SC3228/BatteryProgrammer/Batt Programmer_V2/Batt Programmer/Manual/V1/20180212_135302.jpg

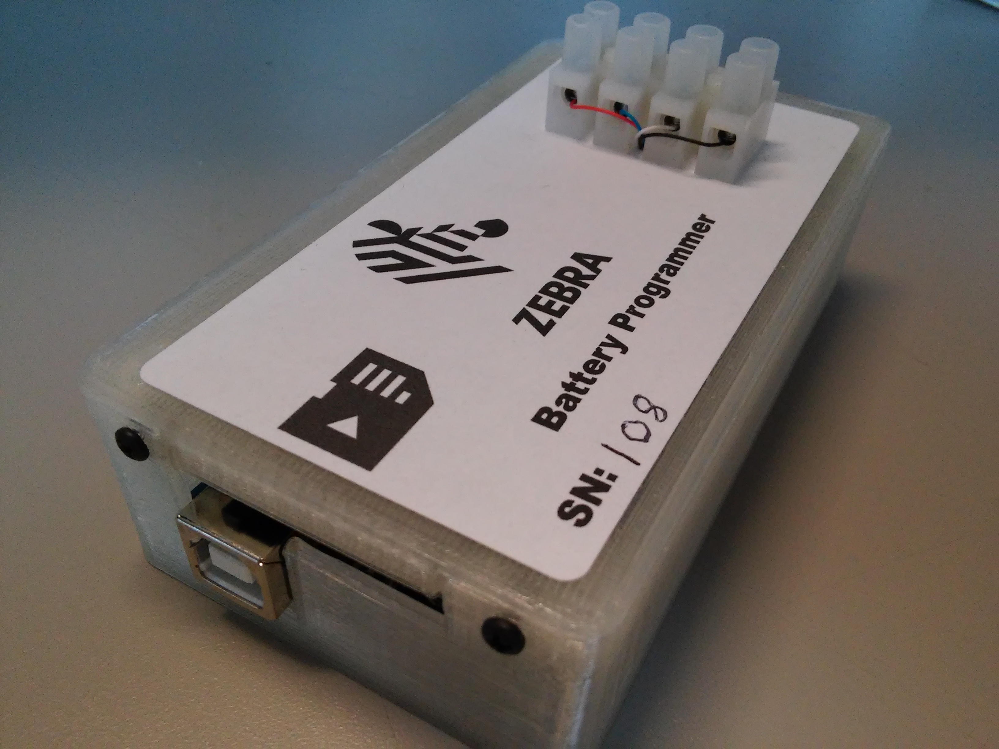
Batt Programmer_V2/Batt Programmer/Manual/V1/20180212_135302.jpg
