SC3228/BatteryProgrammer/Batt Programmer_V2/Batt Programmer/Notes.txt

Support Central Emc-RVHW46 rvhw46@zebra.com

Software
1. Add support for FUBs.
