SC3228/BatteryProgrammer/Batt Programmer_V2/Batt Programmer/Link.txt

https://zebra.sharepoint.com/sites/BatteryProgrammer
