SC3228/BatteryProgrammer/Batt Programmer_V2/Batt Programmer/Box/labels V2 JDM.odt

Batt+

SCL

SDA

Gnd

Therm

PN: ZN10001068

Battery

Programmer

SN:

Batt+

SCL

SDA

Gnd

Therm

PN: ZN10001068

Battery

Programmer

SN:

Batt+

SCL

SDA

Gnd

Therm

PN: ZN10001068

Battery

Programmer

SN:

Batt+

SCL

SDA

Gnd

Therm

PN: ZN10001068

Battery

Programmer

SN:

Batt+

SCL

SDA

Gnd

Therm

PN: ZN10001068

Battery

Programmer

SN:

Batt+

SCL

SDA

Gnd

Therm

PN: ZN10001068

Battery

Programmer

SN:

Batt+

SCL

SDA

Gnd

Therm

PN: ZN10001068

Battery

Programmer

SN:

Batt+

SCL

SDA

Gnd

Therm

PN: ZN10001068

Battery

Programmer

SN:

Batt+

SCL

SDA

Gnd

Therm

PN: ZN10001068

Battery

Programmer

SN:

Batt+

SCL

SDA

Gnd

Therm

PN: ZN10001068

Battery

Programmer

SN:
