SC3228/BatteryProgrammer/Batt Programmer_V2/Batt Programmer/Box/labels V2.odt

Batt+

SCL

SDA

Gnd

Therm

PN: ZN10001068

Battery

Programmer

FOR ZEBRA

INTERNAL USE ONLY!

SN:

Batt+

SCL

SDA

Gnd

Therm

PN: ZN10001068

Battery

Programmer

FOR ZEBRA

INTERNAL USE ONLY!

SN:

Batt+

SCL

SDA

Gnd

Therm

PN: ZN10001068

Battery

Programmer

FOR ZEBRA

INTERNAL USE ONLY!

SN:

Batt+

SCL

SDA

Gnd

Therm

PN: ZN10001068

Battery

Programmer

FOR ZEBRA

INTERNAL USE ONLY!

SN:

Batt+

SCL

SDA

Gnd

Therm

PN: ZN10001068

Battery

Programmer

FOR ZEBRA

INTERNAL USE ONLY!

SN:

Batt+

SCL

SDA

Gnd

Therm

PN: ZN10001068

Battery

Programmer

FOR ZEBRA

INTERNAL USE ONLY!

SN:

Batt+

SCL

SDA

Gnd

Therm

PN: ZN10001068

Battery

Programmer

FOR ZEBRA

INTERNAL USE ONLY!

SN:

Batt+

SCL

SDA

Gnd

Therm

PN: ZN10001068

Battery

Programmer

FOR ZEBRA

INTERNAL USE ONLY!

SN:

Batt+

SCL

SDA

Gnd

Therm

PN: ZN10001068

Battery

Programmer

FOR ZEBRA

INTERNAL USE ONLY!

SN:

Batt+

SCL

SDA

Gnd

Therm

PN: ZN10001068

Battery

Programmer

FOR ZEBRA

INTERNAL USE ONLY!

SN:
