SC3228/BatteryProgrammer/Batt Programmer_V2/Batt Programmer/Box/V1/JDM labels.odt

Batt+

SCL

SDA

Gnd

Battery Programmer

SN:

Batt+

SCL

SDA

Gnd

Battery Programmer

SN:

Batt+

SCL

SDA

Gnd

Battery Programmer

SN:

Batt+

SCL

SDA

Gnd

Battery Programmer

SN:

Batt+

SCL

SDA

Gnd

Battery Programmer

SN:

Batt+

SCL

SDA

Gnd

Battery Programmer

SN:

Batt+

SCL

SDA

Gnd

Battery Programmer

SN:

Batt+

SCL

SDA

Gnd

Battery Programmer

SN:

Batt+

SCL

SDA

Gnd

Battery Programmer

SN:

Batt+

SCL

SDA

Gnd

Battery Programmer

SN:
