SC3228/BatteryProgrammer/Batt Programmer_V2/Batt Programmer/Box/V1/labels.odt

Batt+

SCL

SDA

Gnd

Battery Programmer

FOR ZEBRA INTERNAL USE ONLY!

SN:

Batt+

SCL

SDA

Gnd

Battery Programmer

FOR ZEBRA INTERNAL USE ONLY!

SN:

Batt+

SCL

SDA

Gnd

Battery Programmer

FOR ZEBRA INTERNAL USE ONLY!

SN:

Batt+

SCL

SDA

Gnd

Battery Programmer

FOR ZEBRA INTERNAL USE ONLY!

SN:

Batt+

SCL

SDA

Gnd

Battery Programmer

FOR ZEBRA INTERNAL USE ONLY!

SN:

Batt+

SCL

SDA

Gnd

Battery Programmer

FOR ZEBRA INTERNAL USE ONLY!

SN:

Batt+

SCL

SDA

Gnd

Battery Programmer

FOR ZEBRA INTERNAL USE ONLY!

SN:

Batt+

SCL

SDA

Gnd

Battery Programmer

FOR ZEBRA INTERNAL USE ONLY!

SN:

Batt+

SCL

SDA

Gnd

Battery Programmer

FOR ZEBRA INTERNAL USE ONLY!

SN:

Batt+

SCL

SDA

Gnd

Battery Programmer

FOR ZEBRA INTERNAL USE ONLY!

SN:
