SC3228/BatteryProgrammer/Batt Programmer_V2/Batt Programmer/Manual/Hardware TOP V2.odt

Battery Programmer I/O Board Theory Of Operation

## Overview

## The I/O board is designed as a wing for an Adafruit Feather M4 Express board. It provides the electrical interface to the various batteries

## It also provides other functions as detailed below

## Connectors

## Feather headers - A1

## These connectors provide the interface to the Arduino Mega 2560

## For a detailed pin out please see the A (https://www.adafruit.com/product/3857)dafruit (https://www.adafruit.com/product/3857) documentation (https://www.adafruit.com/product/3857)

## Battery connector – J1

## J1 connects the 5 battery wires to the board, these are Batt+, Gnd, SDA, SCL, Therm

## Input protection

## The diode pack U7 is used to clamp input signals to the rails

## Relays K1 – K3

## Used to isolate the unit from the battery connector until it is powered up and configured

## Controlled by GPIOs from the Mega board thru FETs

## I2C interface

## The I2C interface is handled by the M4 Express board hardware

## The Mega board interface is 3.3V, a level shifter made with Q2 & Q3 is used to support higher bus voltages.

## Pull up voltage

## The I2C pull up voltage is controlled by an M4 Express GPIO using the 2 to 1 analog mux at U4.

## Voltages of 3.3V, or the battery voltage are supported.

## Battery voltages up to ~9.5V are supported

## Pull up resistors

## The I/O board can provide pull up resistor values from 2K to 6.7K

## The resistor value is controlled by GPIOs using the quad analog switches at U1 and U2

## By combining the 5.1K, 6.8K, and 10K resistors in various combinations the following pull up resistor values are available: 2.0K, 2.5K, 2.9K, 3.4K, 4.1K, 5.1K, and 6.7K

## Active clock drive

## To support batteries that need an active clock drive the left over analog switches in U1 and U2 are used to select between the selected pull up resistance or the output of the level shifter at U3

## Only a 3.3V active drive is supported

## On board Auth Chip

## U6 is an Atmel/Microchip ATECC608A authentication chip like the ones in our batteries.

## It’s main use is to perform the math associated with authenticating our batteries

## It stores the serial number and of the battery programmer unit

## It also stores the hardware rev of the I/O board

## Battery voltage measurement

## The battery voltage is measured by an analog input on the M4 Express board

## Resistors R11 and R10 divide the voltage down to a level that allows inputs of up to ~9.5V to be measured

## The on-board regulator on the M4 Express provides a 3.3V 1% reference voltage to the M4 Express AREF pin.

## Config storage

## The unit serial number is stored in the first two bytes of slot 0, LSB first.

## SN values < 1000 are for Zebra internal use only devices

## SN values >= 1000 are for JDM devices

## Slot 0 will be locked after being programmed

## The hardware revision of the unit will be stored in the first two bytes of slot 1.

## Byte 0 will be the major rev value and byte 1 will be the minor rev value.

## Slot 1 will be left unlocked after being programmed.
