SC3228/BatteryProgrammer/Batt Programmer_V2/Batt Programmer/Manual/V1/Hardware TOP V1.odt

Battery Programmer I/O Board Theory Of Operation

## Overview

## The I/O board is designed as a shield for an Arduino Mega 2560 board. It provides the electrical interface to the various batteries

## It also provides other functions as detailed below

## Connectors

## Arduino headers - P1-P7

## These connectors provide the interface to the Arduino Mega 2560

## For a detailed pin out please see the Arduino documentation (https://store.arduino.cc/usa/mega-2560-r3)

## Battery connector – J1

## J1 connects the 4 battery wires to the board, these are Batt+, Gnd, SDA, SCL

## It also has connections to a set of normally open relay contacts for future use

## SD Card socket – J2

## Socket for an SD card that can be used to load/store battery hex files

## Input protection

## The diode pack U7 is used to clamp input signals to the rails

## Relays K1 – K3

## Used to isolate the unit from the battery connector until it is powered up and configured

## Controlled by GPIOs from the Mega board thru FETs

## I2C interface

## The I2C interface is handled by the Mega board hardware

## The Mega board interface is 5V but is compatible with 3.3V signals.

## Pull up voltage

## The I2C pull up voltage is controlled by the Mega GPIOs using the dual 4 to 1 analog mux at U4.

## Voltages of 5V, 3.3V, or the battery voltage are supported.

## The extra input is tied to ground thru R11 and could be used for another input in the future.

## Pull up resistors

## The I/O board can provide pull up resistor values from 2.3K to 10K

## The resistor value is controlled by GPIOs using the two quad analog switches at U1 and U2

## By combining the 5.1K, 6.8K, and 10K resistors in various combinations the following pull up resistor values are available: 2.3K, 2.9K, 3.4K, 4K, 5.1K, 6.8K and 10K

## Active clock drive

## To support batteries that need an active clock drive the left over analog switches in U1 and U2 are used to select between the selected pull up resistance or the output of the level shifter at U3

## Only a 3.3V active drive is supported

## SD Card interface

## The SD card interface only supports a 3.3V SPI interface

## The level shifters at U3 and U5 are used to shift from the 5V mega pins to the 3.3V SD interface

## Both card detect and write protect detection are supported

## On board Auth Chip

## U6 is an Atmel/Microchip ATECC508A authentication chip like the ones in our batteries.

## It’s main use is to perform the math associated with authenticating our batteries

## It stores the serial number and of the battery programmer unit

## It also stores the hardware rev of the I/O board

## Battery voltage measurement

## The battery voltage is measured by an analog input on the Mega board

## Resistors R17 and R22 divide the voltage down to a level that allows inputs of about 5V to be measured

## The regulator at U8 provides a 3.3V reference voltage to the Mega AREF pin.

## Future Expansion

## An extra relay K4 was added for possible future uses

## Load resistor connection

## Charger connection

## Device under test connection
