SC3228/BatteryProgrammer/Batt Programmer_V2/Batt Programmer/GG Programming/GG Update JDM.pdf

# Gas Gauge Update Instructions

This document contains proprietary information of Zebra Technologies Corporation and its subsidiaries (“Zebra Technologies”). It is intended solely for the information and use of parties using the hardware/software described herein. Such proprietary information may not be used, reproduced, or disclosed to any other parties for any other purpose without the express, written permission of Zebra Technologies.

### 1. Terminal Software Installation

A serial communications program is required to use the Battery Programmer. We recommend TeraTerm, but other serial terminal programs may work. TeraTerm can be downloaded from:

https://osdn.net/projects/ttssh2/downloads/74780/teraterm-4.106.exe/

NOTE: The the box is NOT compatible with the Arduino IDE serial monitor

Plug the box into your PC and make a note of the serial port it was assigned. After installing TeraTerm start it and you will see the following dialog, select “Serial” and then pick the port assigned to the box. It will probably be labeled “USB Serial Device”.

When you first plug in the box you may also see a drive pop up with a bunch of files on it. Those files are stored on the box and are needed for the update process. Do not delete or modify them. The drive window can be closed as it is not needed for the update process.

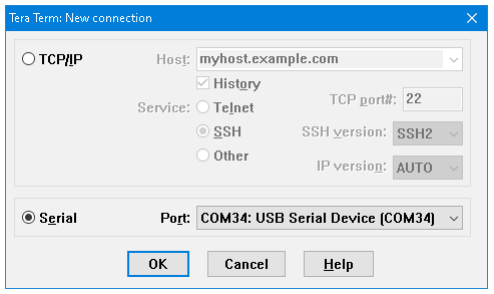
[picture p15: figure]

When the TeraTerm window opens you should see the following:

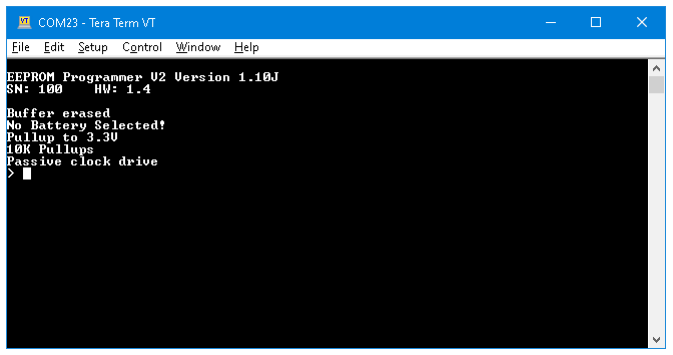
[picture p16: figure]

Page 1 of 2 | GG Update Instructions | 11/22/21

### 2. Select the battery type

Enter the battery select command ‘b’ followed by enter. You should now see the list of supported batteries as shown below:

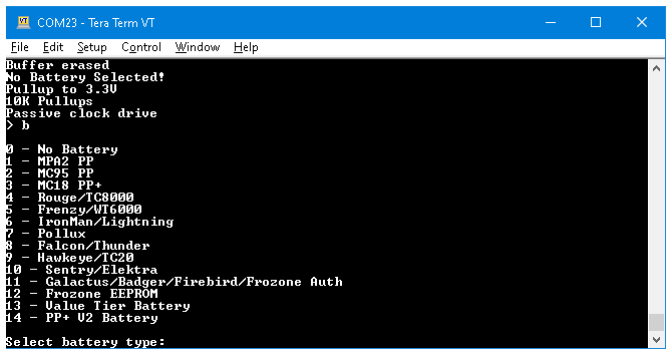
[picture p17: figure]

We want the PP+ V2 Battery, so type the number 14 followed by enter.

### 3. Update a gas gauge

Place a battery into the fixture. You should see the text “Battery detected!” on TeraTerm.
Enter the update gas gauge command ‘ugg’ followed by enter.
The box will now check the battery, check the files it needs for the update, and then update the battery.

This process will take a little over a minute to finish. The LED will glow red during the update.

----DO NOT REMOVE THE BATTERY UNTIL THE UPDATE IS DONE --------Doing so will render the battery unusable----

When the update is finished, the LED will return to green, at that point the battery can be removed from the fixture.

Page 2 of 2 | GG Update Instructions | 11/22/21
