SC3228/BatteryProgrammer/Batt Programmer_V2/Batt Programmer/Docs/BattHardware.ods

Version 1.2 | 2/8/18
Battery Type | Used In | EEPROM Size | EEPROM Address | Temp Chip | Auth Chip | Gas Gauge | Parasitic Power | I2C Bus Speed | Pull up Voltage | Device Pull up | Pack Pull Up | Pack Pull Down | Keys | Data Format | Notes
MPA2&3 PP (Smart) | All MPA2&3 except MC18 | 256 | 0xA0 | 0x90 | N | N | Y | ~32KHz | 3.3V |  |  |  | None | MP2 Smart battery
MPA3 PP+ (Gifted) | MC18, Rogue (TC8000) | 512 | 0xA4 | 0x94 | N | Y | Y |  | 3.3V |  |  |  | Sunrise | PP+
MPA3 PP+ (Gifted) | Frenzy (WT6000) | 512 | 0xA4 | 0x94 | N | Y | Y | 32.2KHz | 3.3V |  |  |  | Freeport | PP+
Pollux | Pollux/Falcon | 512 | 0xA0 | N | N | N | N |  | V_Batt |  |  |  | None | Pollux
Hawkeye | Hawkeye (TC20) | N | N | N | Y | N | N |  | V_Batt |  | 4.7K |  | None | Hawkeye | Data in auth chip slot 8
IronMan | IronMan | 1024 | 0xA0 | N | Y | Y | N | 37.5KHz | V_Batt | 2.2K |  | 1M | IronMan | Combined QC8956 and PP+ | Has both Pollux and PP+ data
Falcon | Falcon | 1024 | 0xA0 | N | Y | Y | N | 37.5KHz | V_Batt | 4.7K |  |  | Falcon | Combined QC8956 and PP+ | Has both Pollux and PP+ data
Sentry | Sentry | 1024 | 0xA0 | N | Y | Y | N | 37.5KHz | V_Batt | 4.7K |  |  | Falcon | Combined QC8956 and PP+ | PP+ Data in auth chip slot 8
Beast | Beast, Galactus, MC19 | 1024 | 0xA0 | N | Y | Y | N | 37.5KHz | V_Batt | 2.2K |  |  | Falcon | PP+ | PP+ Data in auth chip slot 8
