SC3228/BatteryProgrammer/Batt Programmer_V2/Batt Programmer/Backups/V1/IO Board V2_5/IO Board/Hardware TOP.txt

Battery Programmer I/O Board Theroy Of Operation

1. Overview
	The I/O board is designed as a shield for an Arduino Mega 2650 board.
	It provides the electrical interface to the various batteries, as well as other functions
	detailed below.
