SC3228/BatteryProgrammer/Batt Programmer_V2/Batt Programmer/Battery schematics/Beast Connector.png

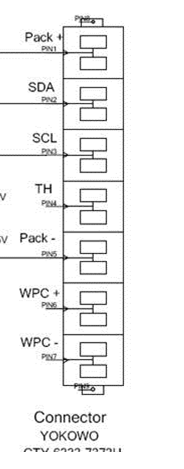
Batt Programmer_V2/Batt Programmer/Battery schematics/Beast Connector.png
