SC3228/BatteryProgrammer/Batt Programmer_V2/Batt Programmer/Battery schematics/Jaws Battery Pinout.jpg

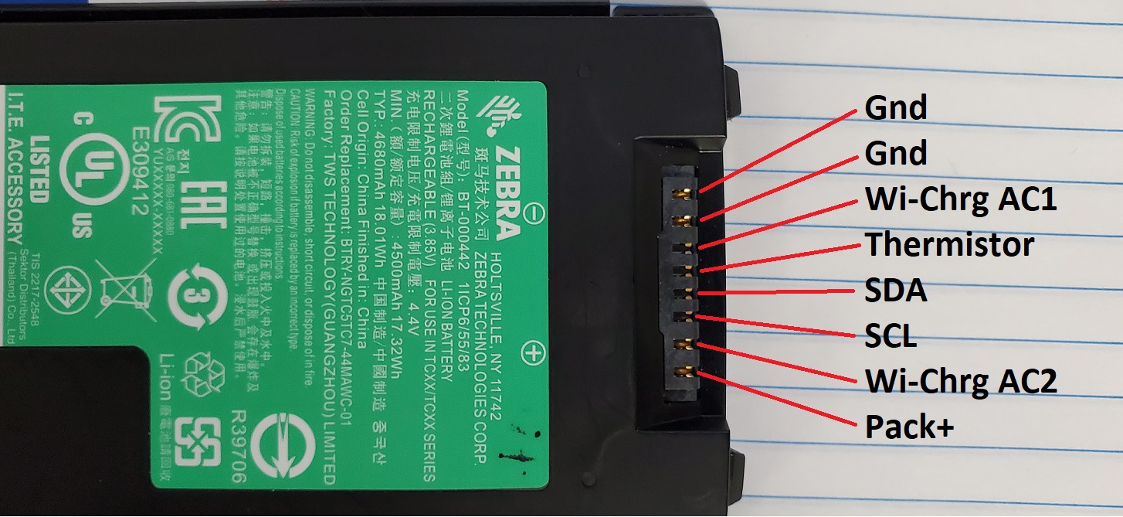
Batt Programmer_V2/Batt Programmer/Battery schematics/Jaws Battery Pinout.jpg
