SC3228/BatteryProgrammer/Batt Programmer_V2/Batt Programmer/Box/V1/sd_card-512.png

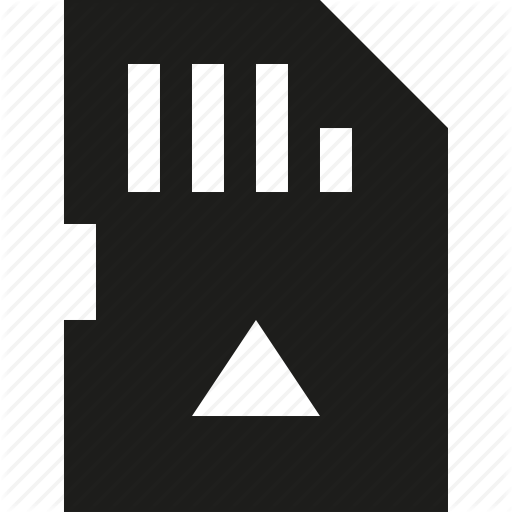
Batt Programmer_V2/Batt Programmer/Box/V1/sd_card-512.png
