SC3228/BatteryProgrammer/Batt Programmer_V2/Batt Programmer/Code/V1 Stuff/BattProgKevin/Untitled.png

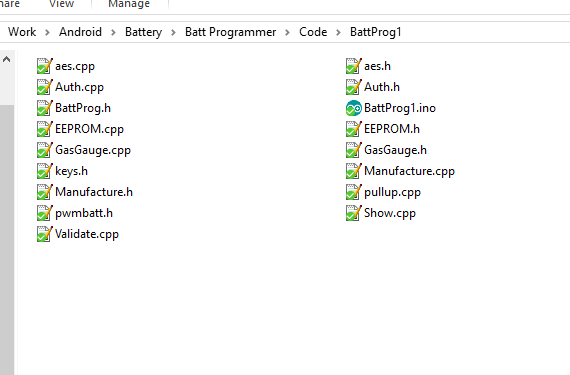
Batt Programmer_V2/Batt Programmer/Code/V1 Stuff/BattProgKevin/Untitled.png
