SC3228/BatteryProgrammer/Batt Programmer_V2/Batt Programmer/GG Programming/Fixture hookup/Jaw Battery Programmer 1.jpg

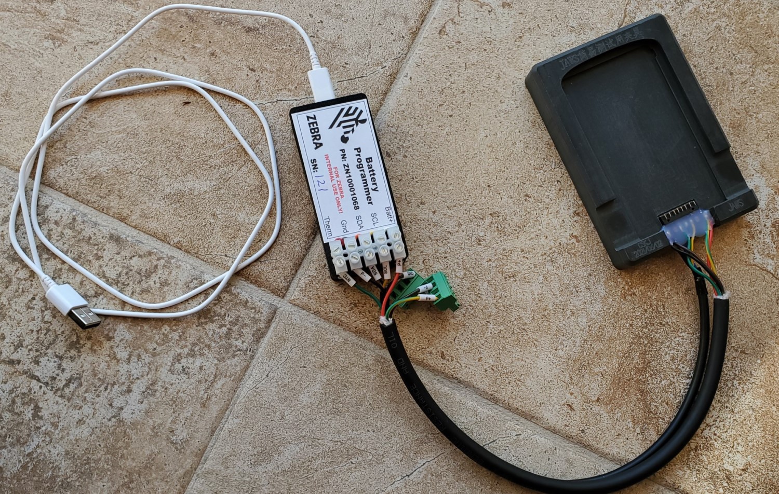
Batt Programmer_V2/Batt Programmer/GG Programming/Fixture hookup/Jaw Battery Programmer 1.jpg
