SC3228/BatteryProgrammer/Batt Programmer_V2/Batt Programmer/GG Programming/Fixture hookup/Jaws Battery Programmer 2.jpg

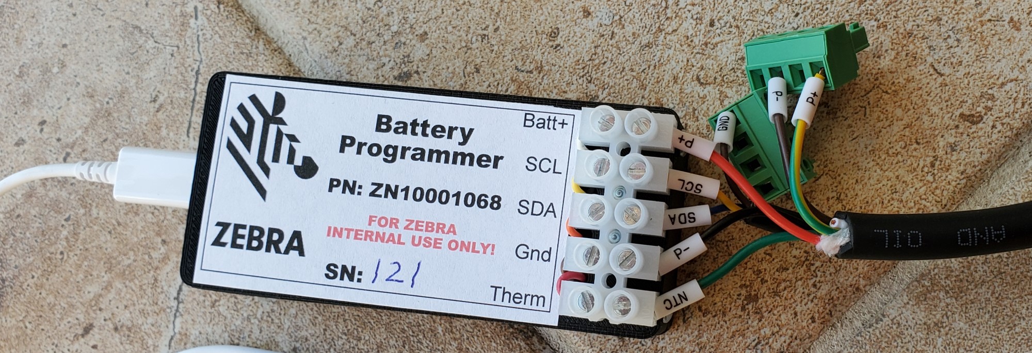
Batt Programmer_V2/Batt Programmer/GG Programming/Fixture hookup/Jaws Battery Programmer 2.jpg
