SC3228/BatteryProgrammer/Batt Programmer_V2/Batt Programmer/IO Board/PCB Settings Stuff/Gerber.png

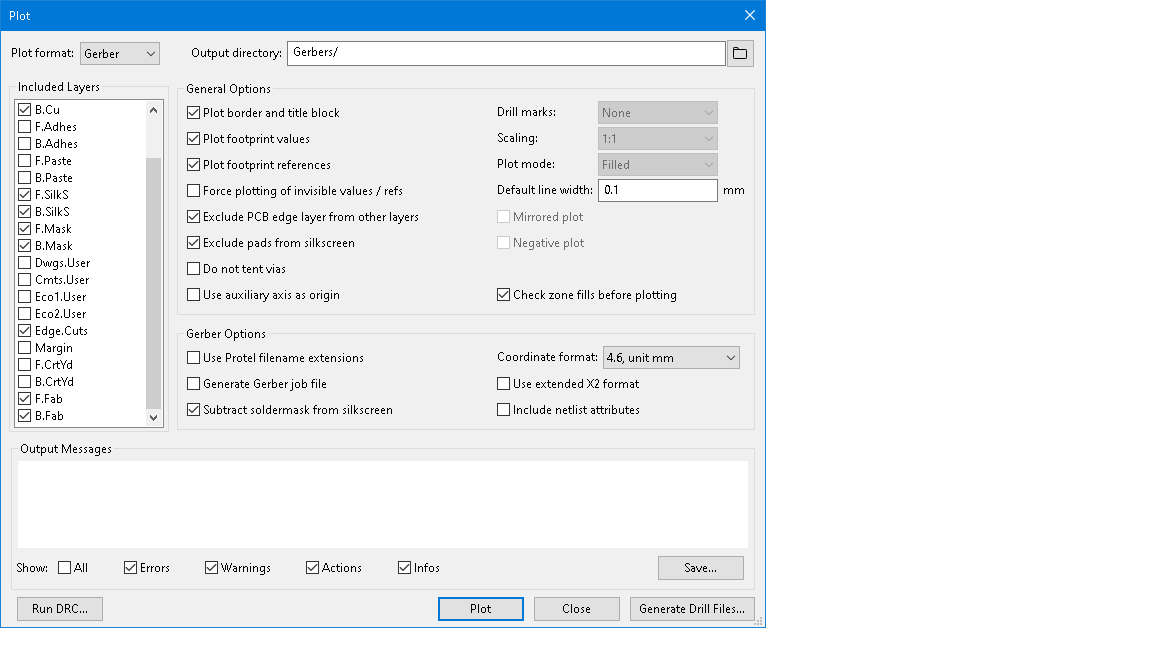
Batt Programmer_V2/Batt Programmer/IO Board/PCB Settings Stuff/Gerber.png
