SC3228/BatteryProgrammer/Batt Programmer_V2/Batt Programmer/Presentations/Top View.jpg

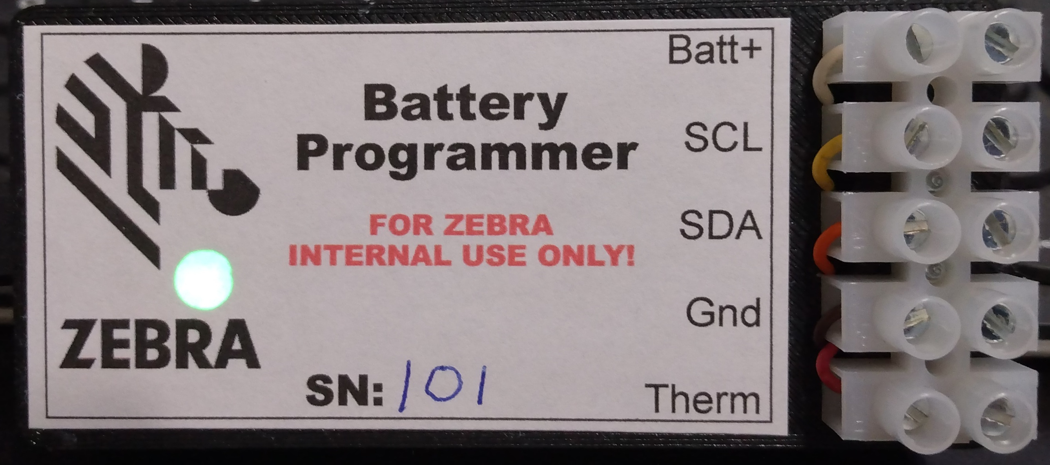
Batt Programmer_V2/Batt Programmer/Presentations/Top View.jpg
