SC3228/BatteryProgrammer/Batt Programmer_V2/Batt Programmer/IO Board/BOM.ods

 |  |  | Build Qnty | Cost each | Total Cost
 |  |  | 10 | $60.02 | $600.21
Ref | Qnt Ea | Buy | Part | Part# | Manf | Supplier | Supplier Part# | Cost | Total Per | Link | Price Break | In Stock | In Stock @ Zebra
A1 | 1 | 10 | Feather M4 Express | 3857 | Adafruit | Digi-key | 1528-2648-ND | $22.95 | $22.95 | https://www.adafruit.com/product/3857 (https://www.digikey.com/en/products/detail/adafruit-industries-llc/3857/9553567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) | 1 | N | 1
U1,U2 | 2 | 20 | Quad 2 to 1 analog mux | MAX4614ESD+ | Maxim | Digi-key | MAX4614ESD+-ND | $3.98 | $7.95 | https://www.digikey.com/en/products/detail/analog-devices-inc-maxim-integrated/MAX4614ESD/1780300 | 10 | Y | 6
U3 | 1 | 10 | Dual Buffer,SOT23-6 | SN74LVC2G17DBVT | TI | Digi-key | 296-26621-1-ND | $1.18 | $1.18 | https://www.digikey.com/product-detail/en/texas-instruments/SN74LVC2G17DBVT/296-26621-1-ND/2255079 | 10 | Y | 5
U4 | 1 | 10 | 2 to 1 analog mux | MAX4624EZT+T | Maxim | Digi-key | MAX4624EZT+T | $4.28 | $4.28 | https://www.digikey.com/en/products/detail/analog-devices-inc-maxim-integrated/MAX4624EZT-T/1163961 | 10 | Y | 4
U5 | 1 | 10 | ESD Protection | DT2042-04SO-7 | Diodes Inc. | Digi-key | DT2042-04SO-7DICT-ND | $0.36 | $0.36 | https://www.digikey.com/product-detail/en/diodes-incorporated/DT2042-04SO-7/DT2042-04SO-7DICT-ND/4457896 | 10 | Y | 4
U6 | 1 | 10 | Authentication IC | ATECC608A-SSHDA-T | Microchip | Digi-key | ATECC608A-SSHDA-TCT-ND | $0.00 | $0.00 | https://www.digikey.com/en/products/detail/microchip-technology/ATECC608A-SSHDA-T/7928116 | 10 | N | 16
U7 | 1 | 10 | Op Amp | MAX4321EUK+T | Maxim | Digi-key | MAX4321EUK+TCT-ND | $2.46 | $2.46 | https://www.digikey.com/en/products/detail/maxim-integrated/MAX4321EUK-T/1702629 | 10 | Y | 4
R1,R2,R3 | 3 | 100 | 100K resistor,5%,1206 | RMCF1206JG100K | Stackpole | Digi-key | RMCF1206JG100KCT-ND | $0.01 | $0.03 | https://www.digikey.com/products/en?keywords=RMCF1206JG100KCT-ND | 100 | Y | 76
R4,R7,R15,R16 | 4 | 100 | 10K resistor,1%,1206 | RMCF1206FT10K0 | Stackpole | Digi-key | RMCF1206FT10K0CT-ND | $0.01 | $0.06 | https://www.digikey.com/products/en?keywords=RMCF1206FT10K0CT-ND | 100 | Y | 68
R5,R8 | 2 | 100 | 6.8K resistor,1%,1206 | RMCF1206FT6K80 | Stackpole | Digi-key | 738-RMCF1206FT6K80CT-ND | $0.01 | $0.03 | https://www.digikey.com/products/en?keywords=738-RMCF1206FT6K80CT-ND | 100 | Y | 98
R6,R9,R14 | 3 | 100 | 5.1K resistor,1%,1206 | RMCF1206FT5K10 | Stackpole | Digi-key | RMCF1206FT5K10CT-ND | $0.01 | $0.04 | https://www.digikey.com/products/en?keywords=RMCF1206FT5K10CT-ND | 100 | Y | 65
R11 | 1 | 10 | 3.65K resistor,.1%,1206 | RT1206BRD073K65L | Yageo | Digi-key | YAG5071CT-ND | $0.48 | $0.48 | https://www.digikey.com/products/en?keywords=YAG5071CT-ND | 10 | Y | 4
R10 | 1 | 10 | 6.81K resistor,.1%,1206 | RT1206BRD076K81L | Yageo | Digi-key | YAG2074CT-ND | $0.48 | $0.48 | https://www.digikey.com/products/en?keywords=YAG2074CT-ND | 10 | Y | 3
R12,R13 | 2 | 20 | 20K resistor,1%,1206 | RMCF1206FT20K0 | Stackpole | Digi-key | RMCF1206FT20K0CT-ND | $0.04 | $0.07 | https://www.digikey.com/en/products/detail/stackpole-electronics-inc/RMCF1206FT20K0/1759766 | 10 | Y | 84
C1,C2,C4,C5,C6 | 5 | 50 | .1uf Cap,1206 | 12061C104KAT4A | AVX Corp | Digi-key | 478-10855-1-ND | $0.07 | $0.34 | https://www.digikey.com/product-detail/en/avx-corporation/12061C104KAT4A/478-10855-1-ND/7536379 | 50 | Y | 15
C3 | 1 | 10 | 10uf Cap,1206 | CL31B106KOHNNWE | Samsung | Digi-key | 1276-3105-1-ND | $0.17 | $0.17 | https://www.digikey.com/en/products/detail/samsung-electro-mechanics/CL31B106KOHNNWE/3888763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 | 10 | Y | 4
K1,K2 | 2 | 50 | DPDT Relay | TX2SA-LT-5V-TH-Z | Panasonic | Digi-key | 255-3837-1-ND | $3.58 | $7.15 | https://www.digikey.com/en/products/detail/panasonic-electric-works/TX2SA-LT-5V-TH-Z/2766947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 | 50 | Y | 4
P1,P2 (A1 Socket) | 1 | 10 | 30 pin header socket | 7-534237-8 | AMP | Digi-key | A32917-ND | $4.94 | $4.94 | https://www.digikey.com/en/products/detail/te-connectivity-amp-connectors/6-534237-4/1089949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 | 10 | Y | 1
D1 | 1 | 10 | 50V 1A Diode | S1A | On Semi | Digi-key | S1AFSCT-ND | $0.34 | $0.34 | https://www.digikey.com/product-detail/en/on-semiconductor/S1A/S1AFSCT-ND/965718 | 10 | Y | 61
D2,D3,D4 | 3 | 100 | Diode Array | BAS70-04-E3-18 | Vishay | Digi-key | BAS70-04-E3-18GICT-ND | $0.18 | $0.54 | https://www.digikey.com/en/products/detail/vishay-general-semiconductor-diodes-division/BAS70-04-E3-18/4826861 | 100 | Y | 21
Q1,Q2,Q3 | 3 | 30 | MOSFET: N-Ch SOT-23 | BSS806NH6327XTSA1 | Infineon | Digi-key | BSS806NH6327XTSA1CT-ND | $0.37 | $1.12 | https://www.digikey.com/en/products/detail/infineon-technologies/BSS806NEH6327XTSA1/5959969 | 10 | Y | 11
 | 1 | 10 | Terminal Strip | 121205 | Adels-Contact | Digi-key | 2098-121205-ND | $0.71 | $0.71 | https://www.digikey.com/products/en?keywords=2098-121205-ND | 10 | Y | 2
 | 6 | 100 | #4x3/8 Screw | PSMS 004 0038 PH | B&F Fastener Supply | Digi-key | H800-ND | $0.09 | $0.54 | https://www.microfasteners.com/smpp0206-2-x-3-8-pan-head-sheet-metal-screws-phillips.html (https://www.digikey.com/en/products/detail/b-f-fastener-supply/PSMS-004-0038-PH/333049) | 100 | Y | 146
PC Board | 1 | 10 |  |  |  |  |  | $3.80 | $3.80 |  | 10 |  | 0
