SC3228/BatteryProgrammer/Batt Programmer_V2/Batt Programmer/Battery Fixtures/Gravity/pogos.stl

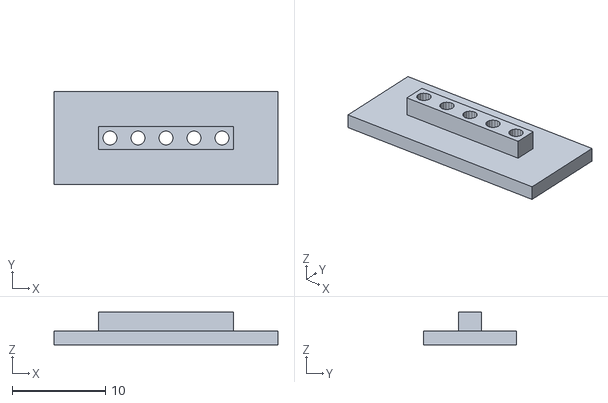
[picture p27: CAD file, 2024-01-31]
Batt Programmer_V2/Batt Programmer/Battery Fixtures/Gravity/pogos.stl
24.0 x 10.0 x 3.50
