SC3228/BatteryProgrammer/Batt Programmer_V2/Batt Programmer/Box/V2 Box Top.stl

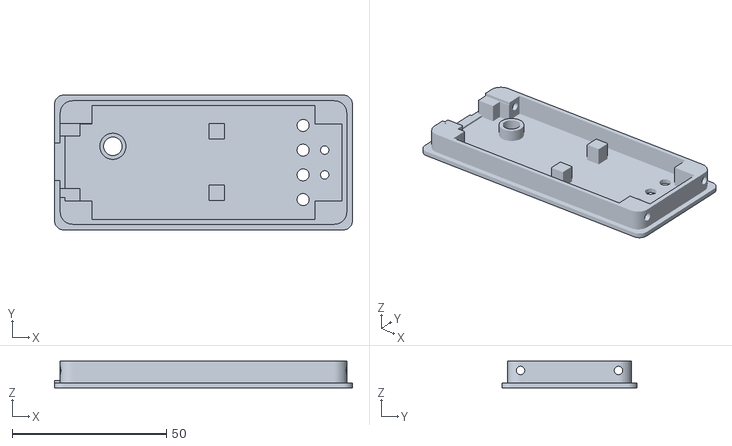
[picture p28: CAD file, 2024-01-31]
Batt Programmer_V2/Batt Programmer/Box/V2 Box Top.stl
96.5 x 43.7 x 8.60
