SC3228/BatteryProgrammer/Batt Programmer_V2/Batt Programmer/IO Board/Gerbers/IO Board-NPTH-drl_map.dxf

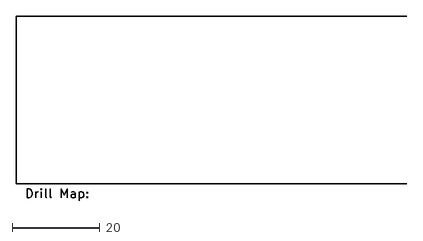
[picture p29: CAD file, 2024-01-31]
Batt Programmer_V2/Batt Programmer/IO Board/Gerbers/IO Board-NPTH-drl_map.dxf
88.9 x 41.9
