SC3228/BatteryProgrammer/Batt Programmer_V2/Batt Programmer/Battery Fixtures/Gravity/fixture.stl

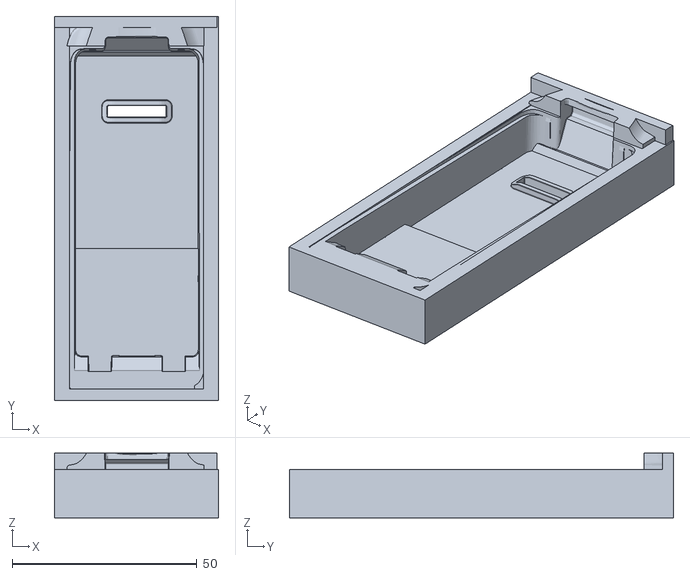
[picture p30: CAD file, 2024-01-31]
Batt Programmer_V2/Batt Programmer/Battery Fixtures/Gravity/fixture.stl
44.4 x 104.0 x 17.5
