SC3228/BatteryProgrammer/Batt Programmer_V2/Batt Programmer/Box/V2 Box Bot.stl

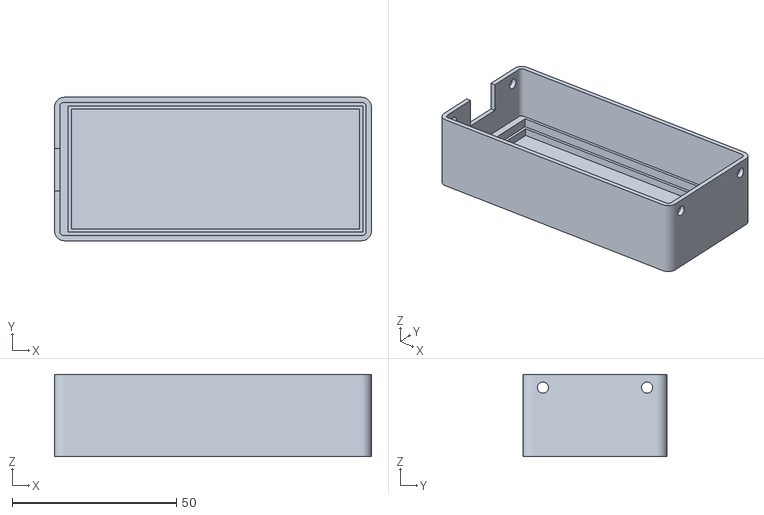
[picture p31: CAD file, 2024-01-31]
Batt Programmer_V2/Batt Programmer/Box/V2 Box Bot.stl
96.5 x 43.7 x 25.0
