SC3228/BatteryProgrammer/Batt Programmer_V2/Batt Programmer/IO Board/Gerbers/IO Board-PTH-drl_map.dxf

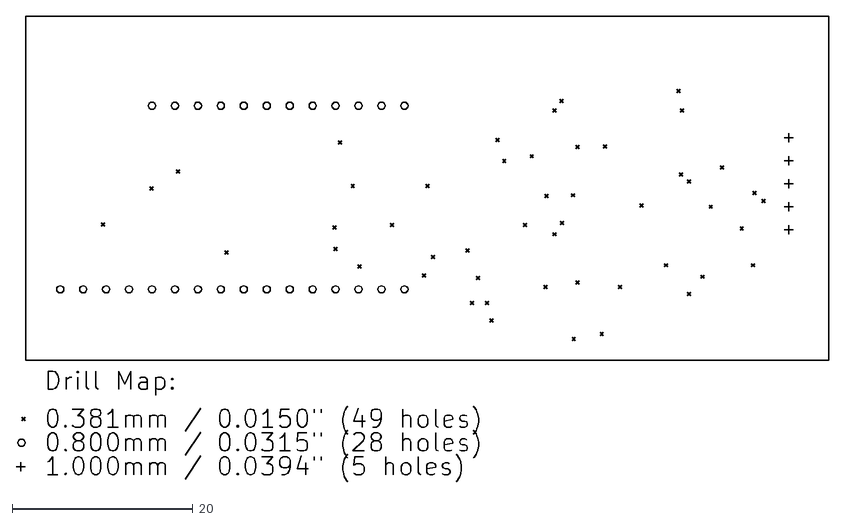
[picture p32: CAD file, 2024-01-31]
Batt Programmer_V2/Batt Programmer/IO Board/Gerbers/IO Board-PTH-drl_map.dxf
90.0 x 51.5
