SC3228/BatteryProgrammer/Batt Programmer_V2/Batt Programmer/Battery Fixtures/Gravity/gravity_4b_top-cover_front_to-Frank_0612.stl

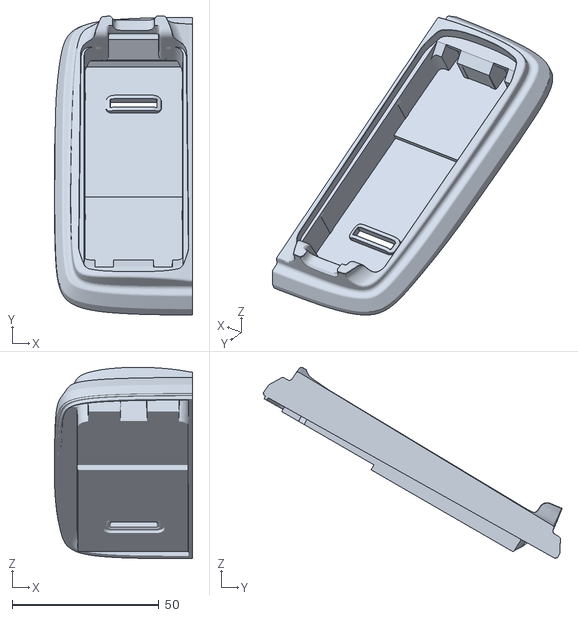
[picture p33: CAD file, 2024-01-31]
Batt Programmer_V2/Batt Programmer/Battery Fixtures/Gravity/gravity_4b_top-cover_front_to-Frank_0612.stl
47.1 x 102.0 x 65.3
