SC3228/BatteryProgrammer/Batt Programmer_V2/Batt Programmer/Box/V2 Box.stl

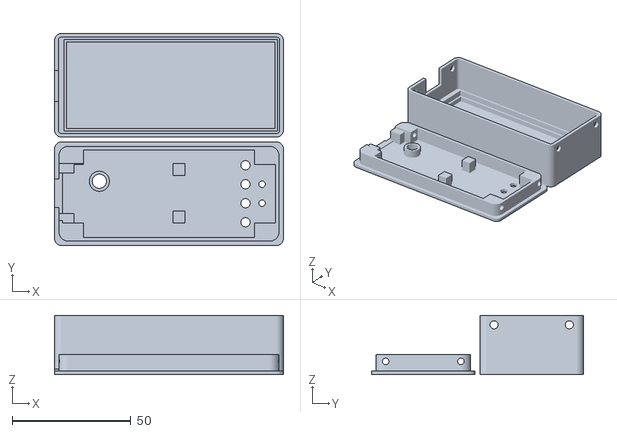
[picture p34: CAD file, 2024-01-31]
Batt Programmer_V2/Batt Programmer/Box/V2 Box.stl
96.5 x 89.4 x 25.0
