SC3228/BatteryProgrammer/(list of files, cad)

Other CAD files:
Batt Programmer_V2/Batt Programmer_OLD/Box/test.scad
