SC3228/BatteryProgrammer/Batt Programmer_V2/Batt Programmer/Docs/508 setup.txt

1. I2C address = 0xC0
2. Chip mode = 0x06
	TTL enable = 1 (VCC based VIN H/L)
	Watchdog Duration = 1 (10 sec.)
