SC3228/BatteryProgrammer/Batt Programmer_V2/Batt Programmer/Battery Programmer Instructions.docx

How to assign new battery programmer to Z employee:

1. Install label on box and mark with correct SN from spreadsheet (V2 Units.ods)
2. Load V2Test UF2 FW File to Board
  a. Plug in USB Cord
  b. Press Reset button 2x
  c. Drag “V2Test.uf2” to FTHRCANBOOT Device
3. Open TeraTerm to run ATP
4. Type “DAT” to run ATP.
5. Load BattProgV2 UF2 FW File to Board
  a. Plug in USB Cord
  b. Press Reset button 2x
  c. Drag “V2Config.uf2” to FTHRCANBOOT Device
6. Type “ES” to enter device Serial Number.
7. Type “EH” to enter device Hardware Rev Number.
8. Load BattProgV2 UF2 FW File to Board
  a. Plug in USB Cord
  b. Press Reset button 2x
  c. Drag “BattProgV2_Ver1_XX.uf2” to FTHRCANBOOT Device
9. BATTPROG Drive should appear on PC
10. Open TeraTerm
