SC3228/BatteryProgrammer/Batt Programmer_V2/Batt Programmer/GG Programming/Data maps/MakeFactoryFreshOrPreserveLearned.xlsx

* Texas Instruments Data Flash File
* File created Wed Jan 19 12:44:13 2022 |  | KEY: Changes to Agile .srec file:
*
* Device Number 1561 |  | TWS updates during mfg.
* Firmware Version 2.01
* Build Number 21 |  | Gauge updates while learning - preserve
* Order Number 0
* |  | Gauge updates while learning, but - overwrite from .fs file
* bqz Device Number 1561
* bqz Firmware Version 2.01
* bqz Build Number 21 | Note that these are the build 21 address offsets. Previously, I sent the build 19 addresses offsets. |  |  |  |  | ADDRESSES DIFFERENT | FLAGS DIFFERENT | Newly exposed
* |  |  |  |  |  | IN BUILDS 19 & 21 | IN BUILDS 19 & 21 | in 21_fixed.bqz
* Field Order: Class name | SubClass name | Parameter name | Parameter Value | Data Length | Address Offset |  |  |  | Default Value | Minimum Value | Maximum Value | Display Format | Read Formula | Write Formula | Flags | Help | Native Units | Data Flash Raw Value
Calibration | Voltage | Cell Gain | 12127 | 2 | 0 |  |  |  | 12101 | -32767 | 32767 | ddd | x | x |  |  | - | 0x522f
Calibration | Current | CC Gain | 9.965 | 4 | 6 |  |  |  | 1 | 0.1 | 4 | f.ffffff | 3.68/x | 3.68/x |  |  | - | 0xc288bd3e
Calibration | Current | Capacity Gain | 9.963 | 4 | 10 |  |  |  | 1 | 298.262 | 119304600 | f.ffffff | 4390411.01/x | 4390411.01/x |  |  | - | 0xdaa5d748
Calibration | Temperature | Internal Temp Offset | -3.6 | 1 | 20 |  |  |  | 0 | -128 | 127 | dd.d | x | x |  |  | 0.1Â°C | 0xf8
Calibration | Temperature | External1 Temp Offset | 0 | 1 | 21 |  |  |  | 0 | -128 | 127 | dd.d | x | x |  |  | 0.1Â°C | 0x00
Calibration | Internal Temp Model | Int Gain | -13908 | 2 | 1088 |  |  |  | -13908 | -32768 | 32767 | ddd | x | x |  |  | - | 0xacc9
Calibration | Internal Temp Model | Int base offset | 6959 | 2 | 1090 |  |  |  | 6959 | -32768 | 32767 | ddd | x | x |  |  | - | 0x2f1b
Calibration | Internal Temp Model | Int Minimum AD | 0 | 2 | 1092 |  |  |  | 0 | -32768 | 32767 | ddd | x | x |  |  | - | 0x0000
Calibration | Internal Temp Model | Int Maximum Temp | 6959 | 2 | 1094 |  |  |  | 6959 | -32768 | 32767 | ddd | x | x |  |  | 0.1degK | 0x2f1b
Calibration | Cell Temperature Model | Coeff a1 | -17447 | 2 | 1096 |  |  |  | -17447 | -32768 | 32767 | ddd | x | x |  |  | - | 0xd9bb
Calibration | Cell Temperature Model | Coeff a2 | 29322 | 2 | 1098 |  |  |  | 29322 | -32768 | 32767 | ddd | x | x |  |  | - | 0x8a72
Calibration | Cell Temperature Model | Coeff a3 | -25430 | 2 | 1100 |  |  |  | -25430 | -32768 | 32767 | ddd | x | x |  |  | - | 0xaa9c
Calibration | Cell Temperature Model | Coeff a4 | 29836 | 2 | 1102 |  |  |  | 29836 | -32768 | 32767 | ddd | x | x |  |  | - | 0x8c74
Calibration | Cell Temperature Model | Coeff a5 | 1200 | 2 | 1104 |  |  |  | 1200 | -32768 | 32767 | ddd | x | x |  |  | - | 0xb004
Calibration | Cell Temperature Model | Coeff b1 | -293 | 2 | 1106 |  |  |  | -293 | -32768 | 32767 | ddd | x | x |  |  | - | 0xdbfe
Calibration | Cell Temperature Model | Coeff b2 | 552 | 2 | 1108 |  |  |  | 552 | -32768 | 32767 | ddd | x | x |  |  | - | 0x2802
Calibration | Cell Temperature Model | Coeff b3 | -2887 | 2 | 1110 |  |  |  | -2887 | -32768 | 32767 | ddd | x | x |  |  | - | 0xb9f4
Calibration | Cell Temperature Model | Coeff b4 | 4591 | 2 | 1112 |  |  |  | 4591 | -32768 | 32767 | ddd | x | x |  |  | - | 0xef11
Calibration | Cell Temperature Model | Rc0 | 11703 | 2 | 1114 |  |  |  | 11703 | -32768 | 32767 | ddd | x | x |  |  | - | 0xb72d
Calibration | Cell Temperature Model | Adc0 | 11703 | 2 | 1116 |  |  |  | 11703 | -32768 | 32767 | ddd | x | x |  |  | - | 0xb72d
Calibration | Cell Temperature Model | Rpad | 0 | 2 | 1118 |  |  |  | 0 | -32768 | 32767 | ddd | x | x |  |  | - | 0x0000
Calibration | Cell Temperature Model | Rint | 0 | 2 | 1120 |  |  |  | 0 | -32768 | 32767 | ddd | x | x |  |  | - | 0x0000
Calibration | Current Deadband | Deadband | 0 | 1 | 1125 |  |  |  | 3 | 0 | 255 | ddd | x | x |  |  | mA | 0x00
Calibration | Current Deadband | Coulomb Counter Deadband | 9 | 1 | 1126 |  |  |  | 9 | 0 | 255 | ddd | x | x |  |  | 116nV | 0x09
Settings | Configuration | Charging Configuration | 1000 | 2 | 1706 | XXXXXX |  |  | 0 | 0 | 0x3f87 | hh | x | x | RSVD|RSVD|TAPER_VOLT|SLEEPCHG|HIBAT_CHG|CHGV_DEGRADE|DEGRADE_CC|COMP_IR|CS_CV|RSVD|RSVD|RSVD|RSVD|SOC_CHARGE|RSVD|CRATE |  | hex | 0x4a01
Settings | Configuration | Temperature Enable | 2 | 1 | 1825 | XXXXXX |  |  | 2 | 0 | 0x03 | hh | x | x | RSVD|RSVD|RSVD|RSVD|RSVD|RSVD|TS1|TSInt |  | hex | 0xcc
Settings | Configuration | DA Configuration | 10 | 2 | 1826 | XXXXXX |  |  | 10 | 0 | 0x10 | hh | x | x | RSVD|RSVD|RSVD|RSVD|RSVD|RSVD|RSVD|RSVD|RSVD|RSVD|RSVD|SLEEP|RSVD|RSVD|RSVD|RSVD |  | hex | 0x1000
Settings | Configuration | I2C Gauging Configuration | 1f | 1 | 1600 |  |  |  | 20 | 0 | 0x3f | hh | x | x | RSVD|RSVD|TAMB_SYNC_SIM|1PERCENT_HOLD|RSVD|LOCK0|RSOC_HOLD|RSOCL |  | hex | 0x1f
Settings | Configuration | I2C Configuration | 0 | 1 | 1601 |  | XXXXXX |  | 8 | 0 | 0xff | hh | x | x | FLASH_BUSY_WAIT|RSVD|RSVD|RSVD|XL|RSVD|RSVD|RSVD |  | hex | 0x00
Settings | Configuration | Auth Config | 0 | 1 | 1602 |  |  |  | 0 | 0 | 0x03 | hh | x | x | RSVD|RSVD|RSVD|RSVD|RSVD|RSVD|KEY_SEL_1|KEY_SEL_0 |  | hex | 0x00
Settings | Configuration | Power Config | 10 | 1 | 1603 |  |  |  | 10 | 0 | 0xff | hh | x | x | RSVD|AUTO_DP_SLP_EN|RSVD|SLP_ACCUM|RSVD|RSVD|HIBERNATE|HIB_AUTO |  | hex | 0x10
Settings | Configuration | IO Config | 0 | 1 | 1604 |  |  |  | 0 | 0 | 0xff | hh | x | x | GPIO_LEVEL_EN|GPIO_POL|INT_TYPE|INT_PUP|INT_POL|INT_EN|BTP_SRC|BTP_EN |  | hex | 0x00
Settings | Configuration | Init Voltage High Set | 4500 | 2 | 1611 |  |  |  | 4500 | 0 | 5000 | ddd | x | x |  |  | mV | 0x9411
Settings | Configuration | Init Voltage High Clear | 4400 | 2 | 1613 |  |  |  | 4400 | 0 | 5000 | ddd | x | x |  |  | mV | 0x3011
Settings | Configuration | Init Voltage Low Set | 2500 | 2 | 1615 |  |  |  | 2500 | 0 | 5000 | ddd | x | x |  |  | mV | 0xc409
Settings | Configuration | Init Voltage Low Clear | 2600 | 2 | 1617 |  |  |  | 2600 | 0 | 5000 | ddd | x | x |  |  | mV | 0x280a
Settings | Configuration | Init Temperature High Set | 60 | 1 | 1619 |  |  |  | 60 | -128 | 127 | ddd | x | x |  |  | Â°C | 0x3c
Settings | Configuration | Init Temperature High Clear | 55 | 1 | 1620 |  |  |  | 55 | -128 | 127 | ddd | x | x |  |  | Â°C | 0x37
Settings | Configuration | Init Temperature Low Set | 0 | 1 | 1621 |  |  |  | 0 | -128 | 127 | ddd | x | x |  |  | Â°C | 0x00
Settings | Configuration | Init Temperature Low Clear | 5 | 1 | 1622 |  |  |  | 5 | -128 | 127 | ddd | x | x |  |  | Â°C | 0x05
Settings | Configuration | SOC Delta | 0 | 1 | 1623 |  |  |  | 1 | 0 | 100 | ddd | x | x |  |  | % | 0x00
Settings | Configuration | GPIO Pulse Width | 7 | 1 | 1624 |  |  |  | 7 | 0 | 255 | ddd | x | x |  |  | 25ms | 0x07
Settings | Configuration | SOC Flag Config A | 0c8c | 2 | 1646 |  |  |  | 0c8c | 0 | 0x0fff | hhhh | x | x | RSVD|RSVD|RSVD|RSVD|TCSETVCT|FCSETVCT|RSVD|RSVD|TCCLEARRSOC|TCSETRSOC|TCCLEARV|TCSETV|TDCLEARRSOC|TDSETRSOC|TDCLEARV|TDSETV |  | hex | 0x8c0c
Settings | Configuration | SOC Flag Config B | 8c | 1 | 1648 |  |  |  | 8c | 0 | 0xff | hh | x | x | FCCLEARRSOC|FCSETRSOC|FCCLEARV|FCSETV|FDCLEARRSOC|FDSETRSOC|FDCLEARV|FDSETV |  | hex | 0x8c
Settings | Configuration | IT Gauging Configuration | d5de | 2 | 1673 |  |  |  | f5fe | 0 | 0xffff | hhhh | x | x | DOD_RSCALE_EN|RELAX_SMOOTH_OK|LFP_RELAX|SMOOTH|RELAX_JUMP_OK|FF_NEAR_EDV|RSVD|FAST_QMAX_FLD|FAST_QMAX_LRN|RSOC_CONV|TDELTAV|DOD0EW|OCVFR|RFACTSTEP|CSYNC|CCT |  | hex | 0xd6d5
Settings | Configuration | IT Gauging Ext | 003e | 2 | 1677 |  | XXXXXX |  | 007f | 0x0000 | 0x003f | hhhh | x | x | RSVD|RSVD|RSVD|RSVD|RSVD|RSVD|RSVD|RSVD|RSVD|EDV_CONV|FOCV_EN|THERM_SAT|THERM_IV|AMB_PRED|CHG_100_SMOOTH_OK|DSG_0_SMOOTH_OK |  | hex | 0x3e00
Settings | AFE | AFE Filter | 250 | 1 | 1828
Settings | BTP | Init Discharge Set | 150 | 2 | 1605 |  |  |  | 150 | 0 | 32767 | ddd | x | x |  |  | mAh | 0x9600
Settings | BTP | Init Charge Set | 175 | 2 | 1607 |  |  |  | 175 | 0 | 32767 | ddd | x | x |  |  | mAh | 0xaf00
Settings | BTP | Init Discharge Set RSOC | 10 | 1 | 1609 |  |  |  | 10 | 0 | 100 | ddd | x | x |  |  | % | 0x0a
Settings | BTP | Init Charge Set RSOC | 15 | 1 | 1610 |  |  |  | 15 | 0 | 100 | ddd | x | x |  |  | % | 0x0f
Settings | Lifetimes | Lifetimes Configuration | 0 | 2 | 1837 | XXXXXX |  |  | 0 | 0 | 0x00ff | hhhh | x | x | RSVD|RSVD|RSVD|RSVD|RSVD|RSVD|RSVD|RSVD|RSVD|RSVD|RSVD|RSVD|RSVD|RSVD|RSVD|SEALED_RESET |  | hex | 0x1900
Settings | Lifetimes | Time RSOC Threshold A | 95 | 1 | 1840 | XXXXXX |  |  | 95 | 0 | 100 | ddd | x | x |  |  | % | 0x3c
Settings | Lifetimes | Time RSOC Threshold B | 90 | 1 | 1841 | XXXXXX |  |  | 90 | 0 | 100 | ddd | x | x |  |  | % | 0x00
Settings | Lifetimes | Time RSOC Threshold C | 80 | 1 | 1842 | XXXXXX |  |  | 80 | 0 | 100 | ddd | x | x |  |  | % | 0x00
Settings | Lifetimes | Time RSOC Threshold D | 50 | 1 | 1843 | XXXXXX |  |  | 50 | 0 | 100 | ddd | x | x |  |  | % | 0x32
Settings | Lifetimes | Time RSOC Threshold E | 20 | 1 | 1844 | XXXXXX |  |  | 20 | 0 | 100 | ddd | x | x |  |  | % | 0x5f
Settings | Lifetimes | Time RSOC Threshold F | 10 | 1 | 1845 | XXXXXX |  |  | 10 | 0 | 100 | ddd | x | x |  |  | % | 0x5a
Settings | Lifetimes | Time RSOC Threshold G | 5 | 1 | 1846 | XXXXXX |  |  | 5 | 0 | 100 | ddd | x | x |  |  | % | 0x50
Settings | Manufacturing | Mfg Status init | 28 | 2 | 1036 |  |  |  | 0 | 0 | 0xffff | hhhh | x | x | RSVD|RSVD|RSVD|RSVD|RSVD|RSVD|RSVD|RSVD|RSVD|RSVD|LF_EN|RSVD|GAUGE_EN|RSVD|RSVD|RSVD |  | hex | 0x2800
Advanced Charge Algorithm | Temperature Ranges | T1 Temp | 0 | 1 | 1708 | XXXXXX |  |  | 0 | -128 | 127 | ddd | x | x |  |  | Â°C | 0x50
Advanced Charge Algorithm | Temperature Ranges | T2 Temp | 10 | 1 | 1709 | XXXXXX |  |  | 10 | -128 | 127 | ddd | x | x |  |  | Â°C | 0x02
Advanced Charge Algorithm | Temperature Ranges | T5 Temp | 20 | 1 | 1710 | XXXXXX |  |  | 20 | -128 | 127 | ddd | x | x |  |  | Â°C | 0x00
Advanced Charge Algorithm | Temperature Ranges | T6 Temp | 45 | 1 | 1711 | XXXXXX |  |  | 25 | -128 | 127 | ddd | x | x |  |  | Â°C | 0x10
Advanced Charge Algorithm | Temperature Ranges | T3 Temp | 50 | 1 | 1712 | XXXXXX |  |  | 45 | -128 | 127 | ddd | x | x |  |  | Â°C | 0x00
Advanced Charge Algorithm | Temperature Ranges | T4 Temp | 60 | 1 | 1713 | XXXXXX |  |  | 55 | -128 | 127 | ddd | x | x |  |  | Â°C | 0x0a
Advanced Charge Algorithm | Temperature Ranges | Hysteresis Temp | 1 | 1 | 1714 | XXXXXX |  |  | 1 | 0 | 127 | ddd | x | x |  |  | Â°C | 0x14
Advanced Charge Algorithm | Low Temp Charging | Current Low | 132 | 2 | 1715 | XXXXXX |  |  | 132 | 0 | 32767 | ddd | x | x |  |  | mA | 0x2d37
Advanced Charge Algorithm | Low Temp Charging | Current Med | 352 | 2 | 1717 | XXXXXX |  |  | 352 | 0 | 32767 | ddd | x | x |  |  | mA | 0x3c01
Advanced Charge Algorithm | Low Temp Charging | Current High | 264 | 2 | 1719 | XXXXXX |  |  | 264 | 0 | 32767 | ddd | x | x |  |  | mA | 0x8400
Advanced Charge Algorithm | Low Temp Charging | Voltage | 4350 | 2 | 898 |  |  |  | 4400 | 0 | 32767 | ddd | x | x |  |  | mV | 0xfe10
Advanced Charge Algorithm | Standard Temp Low Charging | Current Low | 1980 | 2 | 1721 | XXXXXX |  |  | 1980 | 0 | 32767 | ddd | x | x |  |  | mA | 0x6001
Advanced Charge Algorithm | Standard Temp Low Charging | Current Med | 4004 | 2 | 1723 | XXXXXX |  |  | 4004 | 0 | 32767 | ddd | x | x |  |  | mA | 0x0801
Advanced Charge Algorithm | Standard Temp Low Charging | Current High | 2992 | 2 | 1725 | XXXXXX |  |  | 2992 | 0 | 32767 | ddd | x | x |  |  | mA | 0xbc07
Advanced Charge Algorithm | Standard Temp Low Charging | Voltage | 4350 | 2 | 900 |  |  |  | 4400 | 0 | 32767 | ddd | x | x |  |  | mV | 0xfe10
Advanced Charge Algorithm | Standard Temp High Charging | Current Low | 1980 | 2 | 1727 | XXXXXX |  |  | 1980 | 0 | 32767 | ddd | x | x |  |  | mA | 0xa40f
Advanced Charge Algorithm | Standard Temp High Charging | Current Med | 4004 | 2 | 1729 | XXXXXX |  |  | 4004 | 0 | 32767 | ddd | x | x |  |  | mA | 0xb00b
Advanced Charge Algorithm | Standard Temp High Charging | Current High | 2992 | 2 | 1731 | XXXXXX |  |  | 2992 | 0 | 32767 | ddd | x | x |  |  | mA | 0xbc07
Advanced Charge Algorithm | Standard Temp High Charging | Voltage | 4100 | 2 | 902 |  |  |  | 4400 | 0 | 32767 | ddd | x | x |  |  | mV | 0xfe10
Advanced Charge Algorithm | High Temp Charging | Current Low | 1012 | 2 | 1733 | XXXXXX |  |  | 1012 | 0 | 32767 | ddd | x | x |  |  | mA | 0xa40f
Advanced Charge Algorithm | High Temp Charging | Current Med | 1980 | 2 | 1735 | XXXXXX |  |  | 1980 | 0 | 32767 | ddd | x | x |  |  | mA | 0xb00b
Advanced Charge Algorithm | High Temp Charging | Current High | 1496 | 2 | 1737 | XXXXXX |  |  | 1496 | 0 | 32767 | ddd | x | x |  |  | mA | 0xf403
Advanced Charge Algorithm | High Temp Charging | Voltage | 4350 | 2 | 904 |  |  |  | 4100 | 0 | 32767 | ddd | x | x |  |  | mV | 0xfe10
Advanced Charge Algorithm | Rec Temp Charging | Current Low | 2400 | 2 | 1739 | XXXXXX |  |  | 2508 | 0 | 32767 | ddd | x | x |  |  | mA | 0xbc07
Advanced Charge Algorithm | Rec Temp Charging | Current Med | 4488 | 2 | 1741 | XXXXXX |  |  | 4488 | 0 | 32767 | ddd | x | x |  |  | mA | 0xd805
Advanced Charge Algorithm | Rec Temp Charging | Current High | 3520 | 2 | 1743 | XXXXXX |  |  | 3520 | 0 | 32767 | ddd | x | x |  |  | mA | 0x6009
Advanced Charge Algorithm | Rec Temp Charging | Voltage | 4350 | 2 | 906 |  |  |  | 4400 | 0 | 32767 | ddd | x | x |  |  | mV | 0xfe10
Advanced Charge Algorithm | Pre-Charging | Current | 300 | 2 | 1745 | XXXXXX |  |  | 88 | 0 | 32767 | ddd | x | x |  |  | mA | 0x8811
Advanced Charge Algorithm | Maintenance Charging | Current | 44 | 2 | 1747 | XXXXXX |  |  | 44 | 0 | 32767 | ddd | x | x |  |  | mA | 0xc00d
Advanced Charge Algorithm | Voltage Range | Precharge Start Voltage | 2500 | 2 | 1749 | XXXXXX |  |  | 2500 | 0 | 32767 | ddd | x | x |  |  | mV | 0x2c01
Advanced Charge Algorithm | Voltage Range | Charging Voltage Low | 3200 | 2 | 1751 | XXXXXX |  |  | 2900 | 0 | 32767 | ddd | x | x |  |  | mV | 0x2c00
Advanced Charge Algorithm | Voltage Range | Charging Voltage Med | 4300 | 2 | 1753 | XXXXXX |  |  | 3600 | 0 | 32767 | ddd | x | x |  |  | mV | 0xc409
Advanced Charge Algorithm | Voltage Range | Charging Voltage High | 4300 | 2 | 1755 | XXXXXX |  |  | 4000 | 0 | 32767 | ddd | x | x |  |  | mV | 0x800c
Advanced Charge Algorithm | Voltage Range | Charging Voltage Hysteresis | 100 | 1 | 1757 | XXXXXX |  |  | 0 | 0 | 255 | ddd | x | x |  |  | mV | 0xcc
Advanced Charge Algorithm | SoC Range | Charging SoC Med | 50 | 1 | 1758 | XXXXXX |  |  | 50 | 0 | 100 | ddd | x | x |  |  | % | 0x10
Advanced Charge Algorithm | SoC Range | Charging SoC High | 75 | 1 | 1759 | XXXXXX |  |  | 75 | 0 | 100 | ddd | x | x |  |  | % | 0xcc
Advanced Charge Algorithm | SoC Range | Charging SoC Hysteresis | 1 | 1 | 1760 | XXXXXX |  |  | 1 | 0 | 100 | ddd | x | x |  |  | % | 0x10
Advanced Charge Algorithm | Degrade Mode 1 | Cycle Threshold | 50 | 2 | 1761 | XXXXXX |  |  | 50 | 0 | 65535 | ddd | x | x |  |  | - | 0x6432
Advanced Charge Algorithm | Degrade Mode 1 | SOH Threshold | 95 | 1 | 1763 | XXXXXX |  |  | 95 | 0 | 100 | ddd | x | x |  |  | % | 0x4b
Advanced Charge Algorithm | Degrade Mode 1 | Runtime Threshold | 8760 | 2 | 1764 | XXXXXX |  |  | 8760 | 0 | 65535 | ddd | x | x |  |  | h | 0x0132
Advanced Charge Algorithm | Degrade Mode 1 | High SOC Threshold | 8760 | 2 | 1766 | XXXXXX |  |  | 8760 | 0 | 65535 | ddd | x | x |  |  | h | 0x005f
Advanced Charge Algorithm | Degrade Mode 1 | High Temp Threshold | 8760 | 2 | 1768 | XXXXXX |  |  | 8760 | 0 | 65535 | ddd | x | x |  |  | h | 0x3822
Advanced Charge Algorithm | Degrade Mode 1 | High Temp at SOC Threshold | 8760 | 2 | 1770 | XXXXXX |  |  | 8760 | 0 | 65535 | ddd | x | x |  |  | h | 0x3822
Advanced Charge Algorithm | Degrade Mode 1 | Voltage Degradation | 10 | 2 | 1772 | XXXXXX |  |  | 10 | 0 | 32767 | ddd | x | x |  |  | mV | 0x3822
Advanced Charge Algorithm | Degrade Mode 1 | Current Degradation | 10 | 1 | 1774 | XXXXXX |  |  | 10 | 0 | 100 | ddd | x | x |  |  | % | 0x38
Advanced Charge Algorithm | Degrade Mode 2 | Cycle Threshold | 150 | 2 | 1775 | XXXXXX |  |  | 150 | 0 | 65535 | ddd | x | x |  |  | - | 0x220a
Advanced Charge Algorithm | Degrade Mode 2 | SOH Threshold | 80 | 1 | 1777 | XXXXXX |  |  | 80 | 0 | 100 | ddd | x | x |  |  | % | 0x00
Advanced Charge Algorithm | Degrade Mode 2 | Runtime Threshold | 17520 | 2 | 1778 | XXXXXX |  |  | 17520 | 0 | 65535 | ddd | x | x |  |  | h | 0x0a96
Advanced Charge Algorithm | Degrade Mode 2 | High SOC Threshold | 17520 | 2 | 1780 | XXXXXX |  |  | 17520 | 0 | 65535 | ddd | x | x |  |  | h | 0x0050
Advanced Charge Algorithm | Degrade Mode 2 | High Temp Threshold | 17520 | 2 | 1782 | XXXXXX |  |  | 17520 | 0 | 65535 | ddd | x | x |  |  | h | 0x7044
Advanced Charge Algorithm | Degrade Mode 2 | High Temp at SOC Threshold | 17520 | 2 | 1784 | XXXXXX |  |  | 17520 | 0 | 65535 | ddd | x | x |  |  | h | 0x7044
Advanced Charge Algorithm | Degrade Mode 2 | Voltage Degradation | 40 | 2 | 1786 | XXXXXX |  |  | 40 | 0 | 65535 | ddd | x | x |  |  | mV | 0x7044
Advanced Charge Algorithm | Degrade Mode 2 | Current Degradation | 20 | 1 | 1788 | XXXXXX |  |  | 20 | 0 | 100 | ddd | x | x |  |  | % | 0x70
Advanced Charge Algorithm | Degrade Mode 3 | Cycle Threshold | 350 | 2 | 1789 | XXXXXX |  |  | 350 | 0 | 65535 | ddd | x | x |  |  | - | 0x4428
Advanced Charge Algorithm | Degrade Mode 3 | SOH Threshold | 60 | 1 | 1791 | XXXXXX |  |  | 60 | 0 | 100 | ddd | x | x |  |  | % | 0x00
Advanced Charge Algorithm | Degrade Mode 3 | Runtime Threshold | 26280 | 2 | 1792 | XXXXXX |  |  | 26280 | 0 | 65535 | ddd | x | x |  |  | h | 0x145e
Advanced Charge Algorithm | Degrade Mode 3 | High SOC Threshold | 26280 | 2 | 1794 | XXXXXX |  |  | 26280 | 0 | 65535 | ddd | x | x |  |  | h | 0x013c
Advanced Charge Algorithm | Degrade Mode 3 | High Temp Threshold | 26280 | 2 | 1796 | XXXXXX |  |  | 26280 | 0 | 65535 | ddd | x | x |  |  | h | 0xa866
Advanced Charge Algorithm | Degrade Mode 3 | High Temp at SOC Threshold | 26280 | 2 | 1798 | XXXXXX |  |  | 26280 | 0 | 65535 | ddd | x | x |  |  | h | 0xa866
Advanced Charge Algorithm | Degrade Mode 3 | Voltage Degradation | 70 | 2 | 1800 | XXXXXX |  |  | 70 | 0 | 65535 | ddd | x | x |  |  | mV | 0xa866
Advanced Charge Algorithm | Degrade Mode 3 | Current Degradation | 40 | 1 | 1802 | XXXXXX |  |  | 40 | 0 | 100 | ddd | x | x |  |  | % | 0xa8
Advanced Charge Algorithm | Degrade Mode | Cycle Count Start Runtime | 1 | 1 | 1803 | XXXXXX |  |  | 1 | 0 | 255 | ddd | x | x |  |  | - | 0x66
Advanced Charge Algorithm | Degrade Mode | Runtime Update Interval | 10 | 1 | 1804 | XXXXXX |  |  | 10 | 0 | 18 | ddd | x | x |  |  | h | 0x46
Advanced Charge Algorithm | Degrade Mode | Runtime Degrade | 210 | 2 | 512 |  |  |  | 0 | 0 | 65535 | ddd | x | x |  |  | hours | 0xa000
Advanced Charge Algorithm | CS Degrade | Temperature Threshold | 50 | 2 | 1805 | XXXXXX |  |  | 50 | 0 | 32767 | dd.d | x - 2732 | x + 2732 |  |  | 0.1Â°K | 0x0028
Advanced Charge Algorithm | CS Degrade | Voltage Threshold | 4200 | 2 | 1807 | XXXXXX |  |  | 4200 | 0 | 32767 | ddd | x | x |  |  | mV | 0x010a
Advanced Charge Algorithm | CS Degrade | Time Interval | 150 | 2 | 1809 | XXXXXX |  |  | 150 | 0 | 14400 | ddd | x/2 | x * 2 |  |  | s | 0xa00c
Advanced Charge Algorithm | CS Degrade | Delta Voltage | 25 | 2 | 1811 | XXXXXX |  |  | 25 | 0 | 32767 | ddd | x | x |  |  | mV | 0x6810
Advanced Charge Algorithm | CS Degrade | Min CV | 3000 | 2 | 1813 | XXXXXX |  |  | 3000 | 0 | 32767 | ddd | x | x |  |  | mV | 0x2c01
Advanced Charge Algorithm | Termination Config | Charge Term Taper Current | 250 | 2 | 1815 | XXXXXX |  |  | 100 | 0 | 32767 | ddd | x | x |  |  | mA | 0x1900
Advanced Charge Algorithm | Termination Config | Minimum Taper Charge | 25 | 2 | 1817 | ?????
Advanced Charge Algorithm | Termination Config | Charge Term Voltage Offset | 100 | 2 | 1819 | XXXXXX |  |  | 100 | 0 | 32767 | ddd | x | x |  |  | mV | 0xaa00
Advanced Charge Algorithm | Termination Config | Charge Term Charging Voltage | 4300 | 2 | 1821 | XXXXXX |  |  | 4400 | 0 | 32767 | ddd | x | x |  |  | mV | 0xcc10
Advanced Charge Algorithm | Termination Config | Current Taper Window | 40 | 1 | 1823 | ??????
Advanced Charge Algorithm | IR Correction | Averaging Interval | 12 | 1 | 1824 | XXXXXX |  |  | 12 | 1 | 255 | ddd | x | x |  |  | s | 0x00
Gas Gauging | Current Thresholds | Dsg Current Threshold | 45 | 2 | 1829 | XXXXXX |  |  | 60 | -32768 | 32767 | ddd | x | x |  |  | mA | 0x0210
Gas Gauging | Current Thresholds | Chg Current Threshold | 70 | 2 | 1831 | XXXXXX |  |  | 75 | -32768 | 32767 | ddd | x | x |  |  | mA | 0x0000
Gas Gauging | Current Thresholds | Quit Current | 25 | 2 | 1833 | XXXXXX |  |  | 40 | 0 | 32767 | ddd | x | x |  |  | mA | 0x2d00
Gas Gauging | Current Thresholds | Dsg Relax Time | 60 | 1 | 1835 | XXXXXX |  |  | 60 | 0 | 255 | ddd | x | x |  |  | s | 0x46
Gas Gauging | Current Thresholds | Chg Relax Time | 60 | 1 | 1836 | XXXXXX |  |  | 60 | 0 | 255 | ddd | x | x |  |  | s | 0x00
Gas Gauging | Max Load | Max Load Current | -500 | 2 | 1635 |  |  |  | -500 | -32768 | 0 | ddd | x | x |  |  | mA | 0x0cfe
Gas Gauging | Max Load | Max Load Rsoc | 50 | 1 | 1637 |  |  |  | 50 | 0 | 100 | ddd | x | x |  |  | % | 0x32
Gas Gauging | Design | Design Capacity mAh | 6600 | 2 | 1638 |  |  |  | 5300 | 0 | 32767 | ddd | x | x |  |  | mAh | 0x6211
Gas Gauging | Design | Design Capacity cWh | 2541 | 2 | 1640 |  |  |  | 2040 | 0 | 32767 | ddd | x | x |  |  | cWh | 0xb106
Gas Gauging | Design | Design Voltage | 3850 | 2 | 1642 |  |  |  | 3850 | 0 | 32767 | ddd | x | x |  |  | mV | 0x0a0f
Gas Gauging | Cycle | Cycle Count Percentage | 100 | 1 | 1644 |  |  |  | 90 | 0 | 100 | ddd | x | x |  |  | % | 0x64
Gas Gauging | FD | Set Voltage Threshold | 3000 | 2 | 1649 |  |  |  | 3000 | 0 | 5000 | ddd | x | x |  |  | mV | 0xb80b
Gas Gauging | FD | Clear Voltage Threshold | 3100 | 2 | 1651 |  |  |  | 3100 | 0 | 5000 | ddd | x | x |  |  | mV | 0x1c0c
Gas Gauging | FD | Set % RSOC Threshold | 0 | 1 | 1653 |  |  |  | 0 | 0 | 100 | ddd | x | x |  |  | % | 0x00
Gas Gauging | FD | Clear % RSOC Threshold | 5 | 1 | 1654 |  |  |  | 5 | 0 | 100 | ddd | x | x |  |  | % | 0x05
Gas Gauging | FC | Set Voltage Threshold | 4275 | 2 | 1655 |  |  |  | 4400 | 0 | 5000 | ddd | x | x |  |  | mV | 0xb310
Gas Gauging | FC | Clear Voltage Threshold | 4200 | 2 | 1657 |  |  |  | 4300 | 0 | 5000 | ddd | x | x |  |  | mV | 0x6810
Gas Gauging | FC | Set % RSOC Threshold | 100 | 1 | 1659 |  |  |  | 100 | 0 | 100 | ddd | x | x |  |  | % | 0x64
Gas Gauging | FC | Clear % RSOC Threshold | 95 | 1 | 1660 |  |  |  | 95 | 0 | 100 | ddd | x | x |  |  | % | 0x5f
Gas Gauging | TD | Set Voltage Threshold | 3200 | 2 | 1661 |  |  |  | 3200 | 0 | 5000 | ddd | x | x |  |  | mV | 0x800c
Gas Gauging | TD | Clear Voltage Threshold | 3300 | 2 | 1663 |  |  |  | 3300 | 0 | 5000 | ddd | x | x |  |  | mV | 0xe40c
Gas Gauging | TD | Set % RSOC Threshold | 6 | 1 | 1665 |  |  |  | 6 | 0 | 100 | ddd | x | x |  |  | % | 0x06
Gas Gauging | TD | Clear % RSOC Threshold | 8 | 1 | 1666 |  |  |  | 8 | 0 | 100 | ddd | x | x |  |  | % | 0x08
Gas Gauging | TC | Set Voltage Threshold | 4275 | 2 | 1667 |  |  |  | 4400 | 0 | 5000 | ddd | x | x |  |  | mV | 0xb310
Gas Gauging | TC | Clear Voltage Threshold | 4200 | 2 | 1669 |  |  |  | 4300 | 0 | 5000 | ddd | x | x |  |  | mV | 0x6810
Gas Gauging | TC | Set % RSOC Threshold | 100 | 1 | 1671 |  |  |  | 100 | 0 | 100 | ddd | x | x |  |  | % | 0x64
Gas Gauging | TC | Clear % RSOC Threshold | 95 | 1 | 1672 |  |  |  | 95 | 0 | 100 | ddd | x | x |  |  | % | 0x5f
Gas Gauging | State | Cycle Count | 2 | 2 | 448 |  |  |  | 0 | 0 | 65535 | ddd | x | x |  |  | - | 0x0200
Gas Gauging | State | Qmax Cell 1 | 7105 | 2 | 390 |  |  |  | 5359 | 0 | 32767 | ddd | x | x |  |  | mAh | 0x1e12
Gas Gauging | State | Qmax Day | 55 | 2 | 392 |  |  |  | 0 | 0 | 65535 | ddd | x | x |  |  | - | 0x4100
Gas Gauging | State | Qmax Cycle Count | 2 | 2 | 394 |  |  |  | 0 | 0 | 65535 | ddd | x | x |  |  | - | 0x0200
Gas Gauging | State | Update Status | 0e | 1 | 396 |  |  |  | 0 | 0 | 0x0e | hh | x | x | RSVD|RSVD|RSVD|RSVD|is_Qmax_Field_Updated|Enable|UPDATE1|UPDATE0 |  | - | 0x0e
Gas Gauging | State | Cell 1 Chg Voltage at EoC | 4339 | 2 | 397 |  |  |  | 4375 | 0 | 32767 | ddd | x | x |  |  | mV | 0xf510
Gas Gauging | State | Current at EoC | 238 | 2 | 399 |  |  |  | 100 | 0 | 32767 | ddd | x | x |  |  | mA | 0xa400
Gas Gauging | State | Avg I Last Run | -996 | 2 | 401 |  |  |  | -500 | -32768 | 32767 | ddd | x | x |  |  | mA | 0x20fc
Gas Gauging | State | Avg P Last Run | -384 | 2 | 403 |  |  |  | -192 | -32768 | 32767 | ddd | x | x |  |  | cW | 0x96fe
Gas Gauging | State | Delta Voltage | 2 | 2 | 405 |  |  |  | 0 | -32768 | 32767 | ddd | x | x |  |  | mV | 0x0200
Gas Gauging | State | Temp k | 3.63 | 2 | 407 |  |  |  | 2 | 0 | 32767 | d.dd | x | x |  |  | 0.1 Â°C/256cW | 0x5500
Gas Gauging | State | Temp a | 1093 | 2 | 409 |  |  |  | 1000 | 0 | 32767 | ddd | x | x |  |  | s | 0x8500
Gas Gauging | State | Max Avg I Last Run | -999 | 2 | 411 |  |  |  | -500 | -32768 | 32767 | ddd | x | x |  |  | mA | 0x17fc
Gas Gauging | State | Max Avg P Last Run | -430 | 2 | 413 |  |  |  | -192 | -32768 | 32767 | ddd | x | x |  |  | cW | 0x84fe
Gas Gauging | State | SOH Temp k | 3.63 | 2 | 1702 | XXXXXX |  |  | 1 | 0 | 32767 | d.dd | x | x |  |  | 0.1 Â°C/256cW | 0x4a01
Gas Gauging | State | SOH Temp a | 1093 | 2 | 1704 | XXXXXX |  |  | 1000 | 0 | 32767 | ddd | x | x |  |  | s | 0x5002
Gas Gauging | Turbo Cfg | Min System Voltage | 3000 | 2 | 835 |  |  |  | 3000 | 0 | 32767 | ddd | x | x |  |  | mV | 0xb80b
Gas Gauging | Turbo Cfg | Ten Second Max C Rate | -2 | 1 | 837 |  |  |  | -2 | -127 | 0 | dd.d | x | x |  |  | 0.1C | 0xec
Gas Gauging | Turbo Cfg | Ten Millisecond Max C Rate | -4 | 1 | 838 |  |  |  | -4 | -127 | 0 | dd.d | x | x |  |  | 0.1C | 0xd8
Gas Gauging | Turbo Cfg | High Frequency Resistance | 0 | 2 | 839 |  |  |  | 36 | 0 | 32767 | ddd | x | x |  |  | mOhm | 0x0000
Gas Gauging | Turbo Cfg | Reserve Energy % | 0 | 1 | 841 |  |  |  | 0 | 0 | 100 | ddd | x | x |  |  | % | 0x00
Gas Gauging | Turbo Cfg | Turbo Adjustment Factor | 1 | 1 | 842 |  |  |  | 1 | 0 | 255 | d.dd | x | x |  |  | % | 0x64
Gas Gauging | IT Cfg | Load Select | 1 | 1 | 1679 |  |  |  | 1 | 0 | 7 | ddd | x | x |  |  | - | 0x01
Gas Gauging | IT Cfg | Load Mode | 1 | 1 | 1680 |  |  |  | 1 | 0 | 1 | ddd | x | x |  |  | - | 0x01
Gas Gauging | IT Cfg | User Rate-mA | 0 | 2 | 1681 |  |  |  | 0 | -9000 | 0 | ddd | x | x |  |  | mA | 0x0000
Gas Gauging | IT Cfg | User Rate-cW | 0 | 2 | 1683 |  |  |  | 0 | -32768 | 0 | ddd | x | x |  |  | cW | 0x0000
Gas Gauging | IT Cfg | Reserve Cap-mAh | 0 | 2 | 1685 |  |  |  | 0 | 0 | 9000 | ddd | x | x |  |  | mAh | 0x0000
Gas Gauging | IT Cfg | Reserve Cap-cWh | 0 | 2 | 1687 |  |  |  | 0 | 0 | 32000 | ddd | x | x |  |  | cWh | 0x0000
Gas Gauging | IT Cfg | Predict Ambient Time | 2186 | 2 | 1700 |  |  |  | 2000 | 0 | 65535 | ddd | x | x |  |  | s | 0xa004
Gas Gauging | IT Cfg | Design Resistance | 60 | 2 | 384 |  |  |  | 90 | 1 | 32767 | ddd | x | x |  |  | mOhm | 0x5f00
Gas Gauging | IT Cfg | Pack Resistance | 68 | 2 | 386 |  |  |  | 0 | 0 | 32767 | ddd | x | x |  |  | mOhm | 0x4400
Gas Gauging | IT Cfg | System Resistance | 60 | 2 | 388 |  |  |  | 0 | 0 | 32767 | ddd | x | x |  |  | mOhm | 0x3c00
Gas Gauging | IT Cfg | Ra Filter | 80 | 2 | 1486 |  |  |  | 80 | 0 | 999 | dd.d | x | x |  |  | 0.10% | 0x2003
Gas Gauging | IT Cfg | Ra Max Delta | 15 | 1 | 1489 |  |  |  | 15 | 0 | 255 | ddd | x | x |  |  | % | 0x0f
Gas Gauging | IT Cfg | Resistance Parameter Filter | 65142 | 2 | 1492 |  |  |  | 65142 | 1 | 65535 | ddd | x | x |  |  | - | 0x76fe
Gas Gauging | IT Cfg | Near EDV Ra Param Filter | 62184 | 2 | 1494 |  |  |  | 62184 | 1 | 65535 | ddd | x | x |  |  | - | 0xe8f2
Gas Gauging | IT Cfg | Cell 1 Interconnect Resistance | 1 | 2 | 1496 |  |  |  | 0 | 0 | 32767 | ddd | x | x |  |  | 2^-10ohm | 0x0100
Gas Gauging | IT Cfg | Max Current Change % | 10 | 1 | 1498 |  |  |  | 10 | 0 | 100 | ddd | x | x |  |  | % | 0x0a
Gas Gauging | IT Cfg | Resistance Update Voltage | 50 | 2 | 1499 |  |  |  | 50 | 0 | 32767 | ddd | x | x |  |  | mV | 0x3200
Gas Gauging | IT Cfg | Q Invalid MaxT | 45 | 2 | 1508 |  |  |  | 40 | 0 | 32767 | dd.d | x | x |  |  | 0.1 Â°C | 0xc201
Gas Gauging | IT Cfg | Q Invalid MinT | 0 | 2 | 1510 |  |  |  | 10 | 0 | 32767 | dd.d | x | x |  |  | 0.1 Â°C | 0x0000
Gas Gauging | IT Cfg | Qmax Delta | 5 | 1 | 1537 |  |  |  | 5 | 3 | 100 | ddd | x | x |  |  | % | 0x05
Gas Gauging | IT Cfg | Qmax Upper Bound | 130 | 1 | 1538 |  |  |  | 130 | 100 | 255 | ddd | x | x |  |  | % | 0x82
Gas Gauging | IT Cfg | Cycle Adjust Threshold | 20 | 1 | 1539 |  |  |  | 20 | 0 | 255 | ddd | x | x |  |  | - | 0x14
Gas Gauging | IT Cfg | Cycle Adj Incr | 5 | 1 | 1540 |  |  |  | 5 | 0 | 255 | ddd | x | x |  |  | 0.01% | 0x05
Gas Gauging | IT Cfg | OCV Pred Active T Limit | 200 | 2 | 1541 |  |  |  | 200 | 100 | 65535 | ddd | x | x |  |  | s | 0xc800
Gas Gauging | IT Cfg | OCV Pred Transient T | 300 | 2 | 1543 |  |  |  | 300 | 100 | 65535 | ddd | x | x |  |  | s | 0x2c01
Gas Gauging | IT Cfg | OCV Pred Measure Time | 200 | 2 | 1545 |  |  |  | 200 | 0 | 65535 | ddd | x | x |  |  | s | 0xc800
Gas Gauging | IT Cfg | Term Voltage | 3000 | 2 | 1547 |  |  |  | 3000 | 0 | 32767 | ddd | x | x |  |  | mV | 0xb80b
Gas Gauging | IT Cfg | Term V Hold Time | 2 | 1 | 1549 |  |  |  | 2 | 0 | 255 | ddd | x | x |  |  | s | 0x02
Gas Gauging | IT Cfg | Term Voltage Delta | 200 | 2 | 1550 |  |  |  | 200 | 0 | 32767 | ddd | x | x |  |  | mV | 0xc800
Gas Gauging | IT Cfg | Max Simulation Iterations | 50 | 1 | 1561 |  |  |  | 50 | 20 | 50 | ddd | x | x |  |  | - | 0x32
Gas Gauging | IT Cfg | Simulation Near Term Delta | 250 | 2 | 1562 |  |  |  | 250 | 0 | 32767 | ddd | x | x |  |  | mV | 0xfa00
Gas Gauging | IT Cfg | Fast Scale Start SOC | 10 | 1 | 1580 |  |  |  | 10 | 0 | 100 | ddd | x | x |  |  | % | 0x0a
Gas Gauging | IT Cfg | Min Delta Voltage | 0 | 2 | 1589 |  |  |  | 0 | -32768 | 32767 | ddd | x | x |  |  | mV | 0x0000
Gas Gauging | Smoothing | Smooth Relax Time | 1000 | 2 | 1689 |  |  |  | 1000 | 1 | 32767 | ddd | x | x |  |  | s | 0xe803
Gas Gauging | Smoothing | Term Smooth Start Cell V Delta | 150 | 2 | 1691 |  |  |  | 150 | 0 | 32767 | ddd | x | x |  |  | mV | 0x9600
Gas Gauging | Smoothing | Term Smooth Final Cell V Delta | 0 | 2 | 1693 |  |  |  | 100 | 0 | 32767 | ddd | x | x |  |  | mV | 0x0000
Gas Gauging | Smoothing | Term Smooth Time | 20 | 1 | 1695 |  |  |  | 20 | 1 | 32767 | ddd | x | x |  |  | s | 0x14
Gas Gauging | Smoothing | EDV Convergence SOC Threshold | 60 | 1 | 1697 |  |  |  | 60 | 0 | 100 | ddd | x | x |  |  | % | 0x3c
Gas Gauging | Smoothing | EDV Convergence V Threshold | 3500 | 2 | 1698 |  |  |  | 3500 | 0 | 5000 | ddd | x | x |  |  | mV | 0xac0d
Gas Gauging | SoH | SoH Load Rate | 5 | 1 | 1593 |  |  |  | 5 | 0 | 255 | dd.d | x | x |  |  | 0.1Hr rate | 0x32
Power | Power | Valid Update Voltage | 2800 | 2 | 1625 |  |  |  | 2800 | 0 | 32767 | ddd | x | x |  |  | mV | 0xf00a
Power | Sleep | Sleep Current | 12 | 2 | 1627 |  |  |  | 15 | 0 | 32767 | ddd | x | x |  |  | mA | 0x0c00
Power | Sleep | Voltage Time | 4 | 1 | 1629 |  |  |  | 5 | 1 | 20 | ddd | x | x |  |  | s | 0x04
Power | Sleep | Deep Sleep Voltage Time | 20 | 1 | 1630 |  |  |  | 20 | 1 | 20 | ddd | x | x |  |  | s | 0x14
Power | Sleep | Wake Check Time | 1 | 1 | 1631 |  |  |  | 1 | 0 | 20 | ddd | x | x |  |  | s | 0x01
Power | Sleep | Deep Sleep Current | 8 | 2 | 1632 |  |  |  | 10 | 0 | 32767 | ddd | x | x |  |  | mA | 0x0800
Power | Hibernate | Auto Time | 2 | 1 | 1634 |  |  |  | 2 | 0 | 20 | ddd | x | x |  |  | s | 0x02
System Data | Manufacturer Data | Manufacturer Info Block A01 | 6c | 1 | 65 |  |  |  | 61 | 0 | 0xff | hh | x | x |  |  | Hex | 0x61
System Data | Manufacturer Data | Manufacturer Info Block A02 | 1 | 1 | 66 |  |  |  | 62 | 0 | 0xff | hh | x | x |  |  | Hex | 0x01
System Data | Manufacturer Data | Manufacturer Info Block A03 | 18 | 1 | 67 |  |  |  | 63 | 0 | 0xff | hh | x | x |  |  | Hex | 0x1a
System Data | Manufacturer Data | Manufacturer Info Block A04 | af | 1 | 68 |  |  |  | 64 | 0 | 0xff | hh | x | x |  |  | Hex | 0xb8
System Data | Manufacturer Data | Manufacturer Info Block A05 | 0e | 1 | 69 |  |  |  | 65 | 0 | 0xff | hh | x | x |  |  | Hex | 0x0e
System Data | Manufacturer Data | Manufacturer Info Block A06 | 0 | 1 | 70 |  |  |  | 66 | 0 | 0xff | hh | x | x |  |  | Hex | 0x00
System Data | Manufacturer Data | Manufacturer Info Block A07 | 0a | 1 | 71 |  |  |  | 67 | 0 | 0xff | hh | x | x |  |  | Hex | 0x0a
System Data | Manufacturer Data | Manufacturer Info Block A08 | 14 | 1 | 72 |  |  |  | 68 | 0 | 0xff | hh | x | x |  |  | Hex | 0x14
System Data | Manufacturer Data | Manufacturer Info Block A09 | 2d | 1 | 73 |  |  |  | 69 | 0 | 0xff | hh | x | x |  |  | Hex | 0x2d
System Data | Manufacturer Data | Manufacturer Info Block A10 | 37 | 1 | 74 |  |  |  | 6a | 0 | 0xff | hh | x | x |  |  | Hex | 0x37
System Data | Manufacturer Data | Manufacturer Info Block A11 | 3c | 1 | 75 |  |  |  | 6b | 0 | 0xff | hh | x | x |  |  | Hex | 0x3c
System Data | Manufacturer Data | Manufacturer Info Block A12 | 0 | 1 | 76 |  |  |  | 6c | 0 | 0xff | hh | x | x |  |  | Hex | 0x00
System Data | Manufacturer Data | Manufacturer Info Block A13 | 0 | 1 | 77 |  |  |  | 6d | 0 | 0xff | hh | x | x |  |  | Hex | 0x00
System Data | Manufacturer Data | Manufacturer Info Block A14 | 0 | 1 | 78 |  |  |  | 6e | 0 | 0xff | hh | x | x |  |  | Hex | 0x00
System Data | Manufacturer Data | Manufacturer Info Block A15 | 0 | 1 | 79 |  |  |  | 6f | 0 | 0xff | hh | x | x |  |  | Hex | 0x00
System Data | Manufacturer Data | Manufacturer Info Block A16 | 0 | 1 | 80 |  |  |  | 70 | 0 | 0xff | hh | x | x |  |  | Hex | 0x00
System Data | Manufacturer Data | Manufacturer Info Block A17 | 0 | 1 | 81 |  |  |  | 71 | 0 | 0xff | hh | x | x |  |  | Hex | 0x00
System Data | Manufacturer Data | Manufacturer Info Block A18 | 0 | 1 | 82 |  |  |  | 72 | 0 | 0xff | hh | x | x |  |  | Hex | 0x00
System Data | Manufacturer Data | Manufacturer Info Block A19 | 0 | 1 | 83 |  |  |  | 73 | 0 | 0xff | hh | x | x |  |  | Hex | 0x00
System Data | Manufacturer Data | Manufacturer Info Block A20 | 0 | 1 | 84 |  |  |  | 74 | 0 | 0xff | hh | x | x |  |  | Hex | 0x00
System Data | Manufacturer Data | Manufacturer Info Block A21 | 0 | 1 | 85 |  |  |  | 75 | 0 | 0xff | hh | x | x |  |  | Hex | 0x00
System Data | Manufacturer Data | Manufacturer Info Block A22 | 0 | 1 | 86 |  |  |  | 76 | 0 | 0xff | hh | x | x |  |  | Hex | 0x00
System Data | Manufacturer Data | Manufacturer Info Block A23 | 0 | 1 | 87 |  |  |  | 77 | 0 | 0xff | hh | x | x |  |  | Hex | 0x00
System Data | Manufacturer Data | Manufacturer Info Block A24 | 0 | 1 | 88 |  |  |  | 7a | 0 | 0xff | hh | x | x |  |  | Hex | 0x00
System Data | Manufacturer Data | Manufacturer Info Block A25 | 0 | 1 | 89 |  |  |  | 78 | 0 | 0xff | hh | x | x |  |  | Hex | 0x00
System Data | Manufacturer Data | Manufacturer Info Block A26 | 0 | 1 | 90 |  |  |  | 79 | 0 | 0xff | hh | x | x |  |  | Hex | 0x00
System Data | Manufacturer Data | Manufacturer Info Block A27 | 0 | 1 | 91 |  |  |  | 30 | 0 | 0xff | hh | x | x |  |  | Hex | 0x00
System Data | Manufacturer Data | Manufacturer Info Block A28 | 0 | 1 | 92 |  |  |  | 31 | 0 | 0xff | hh | x | x |  |  | Hex | 0x00
System Data | Manufacturer Data | Manufacturer Info Block A29 | 0 | 1 | 93 |  |  |  | 32 | 0 | 0xff | hh | x | x |  |  | Hex | 0x00
System Data | Manufacturer Data | Manufacturer Info Block A30 | 0 | 1 | 94 |  |  |  | 33 | 0 | 0xff | hh | x | x |  |  | Hex | 0x00
System Data | Manufacturer Data | Manufacturer Info Block A31 | 0 | 1 | 95 |  |  |  | 34 | 0 | 0xff | hh | x | x |  |  | Hex | 0x00
System Data | Manufacturer Data | Manufacturer Info Block A32 | 0 | 1 | 96 |  |  |  | 35 | 0 | 0xff | hh | x | x |  |  | Hex | 0x00
System Data | Manufacturer Info B | Manufacturer Info Block B01 | 0 | 1 | 98 |  |  |  | 61 | 0 | 0xff | hh | x | x |  |  | Hex | 0x00
System Data | Manufacturer Info B | Manufacturer Info Block B02 | 0 | 1 | 99 |  |  |  | 62 | 0 | 0xff | hh | x | x |  |  | Hex | 0x00
System Data | Manufacturer Info B | Manufacturer Info Block B03 | 0 | 1 | 100 |  |  |  | 63 | 0 | 0xff | hh | x | x |  |  | Hex | 0x00
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
System Data | Manufacturer Info C | Manufacturer Info Block C03 | 0 | 1 | 133 |  |  |  | 63 | 0 | 0xff | hh | x | x |  |  | Hex | 0x00
System Data | Manufacturer Info C | Manufacturer Info Block C04 | 0 | 1 | 134 |  |  |  | 64 | 0 | 0xff | hh | x | x |  |  | Hex | 0x00
System Data | Manufacturer Info C | Manufacturer Info Block C05 | 0 | 1 | 135 |  |  |  | 65 | 0 | 0xff | hh | x | x |  |  | Hex | 0x00
System Data | Manufacturer Info C | Manufacturer Info Block C06 | 0 | 1 | 136 |  |  |  | 66 | 0 | 0xff | hh | x | x |  |  | Hex | 0x00
System Data | Manufacturer Info C | Manufacturer Info Block C07 | 0 | 1 | 137 |  |  |  | 67 | 0 | 0xff | hh | x | x |  |  | Hex | 0x00
System Data | Manufacturer Info C | Manufacturer Info Block C08 | 0 | 1 | 138 |  |  |  | 68 | 0 | 0xff | hh | x | x |  |  | Hex | 0x00
System Data | Manufacturer Info C | Manufacturer Info Block C09 | 0 | 1 | 139 |  |  |  | 69 | 0 | 0xff | hh | x | x |  |  | Hex | 0x00
System Data | Manufacturer Info C | Manufacturer Info Block C10 | 0 | 1 | 140 |  |  |  | 6a | 0 | 0xff | hh | x | x |  |  | Hex | 0x00
System Data | Manufacturer Info C | Manufacturer Info Block C11 | 0 | 1 | 141 |  |  |  | 6b | 0 | 0xff | hh | x | x |  |  | Hex | 0x00
System Data | Manufacturer Info C | Manufacturer Info Block C12 | 0 | 1 | 142 |  |  |  | 6c | 0 | 0xff | hh | x | x |  |  | Hex | 0x00
System Data | Manufacturer Info C | Manufacturer Info Block C13 | 0 | 1 | 143 |  |  |  | 6d | 0 | 0xff | hh | x | x |  |  | Hex | 0x00
System Data | Manufacturer Info C | Manufacturer Info Block C14 | 0 | 1 | 144 |  |  |  | 6e | 0 | 0xff | hh | x | x |  |  | Hex | 0x00
System Data | Manufacturer Info C | Manufacturer Info Block C15 | 0 | 1 | 145 |  |  |  | 6f | 0 | 0xff | hh | x | x |  |  | Hex | 0x00
System Data | Manufacturer Info C | Manufacturer Info Block C16 | 0 | 1 | 146 |  |  |  | 70 | 0 | 0xff | hh | x | x |  |  | Hex | 0x00
System Data | Manufacturer Info C | Manufacturer Info Block C17 | 0 | 1 | 147 |  |  |  | 71 | 0 | 0xff | hh | x | x |  |  | Hex | 0x00
System Data | Manufacturer Info C | Manufacturer Info Block C18 | 0 | 1 | 148 |  |  |  | 72 | 0 | 0xff | hh | x | x |  |  | Hex | 0x00
System Data | Manufacturer Info C | Manufacturer Info Block C19 | 0 | 1 | 149 |  |  |  | 73 | 0 | 0xff | hh | x | x |  |  | Hex | 0x00
System Data | Manufacturer Info C | Manufacturer Info Block C20 | 0 | 1 | 150 |  |  |  | 74 | 0 | 0xff | hh | x | x |  |  | Hex | 0x00
System Data | Manufacturer Info C | Manufacturer Info Block C21 | 0 | 1 | 151 |  |  |  | 75 | 0 | 0xff | hh | x | x |  |  | Hex | 0x00
System Data | Manufacturer Info C | Manufacturer Info Block C22 | 0 | 1 | 152 |  |  |  | 76 | 0 | 0xff | hh | x | x |  |  | Hex | 0x00
System Data | Manufacturer Info C | Manufacturer Info Block C23 | 0 | 1 | 153 |  |  |  | 77 | 0 | 0xff | hh | x | x |  |  | Hex | 0x00
System Data | Manufacturer Info C | Manufacturer Info Block C24 | 0 | 1 | 154 |  |  |  | 7a | 0 | 0xff | hh | x | x |  |  | Hex | 0x00
System Data | Manufacturer Info C | Manufacturer Info Block C25 | 0 | 1 | 155 |  |  |  | 78 | 0 | 0xff | hh | x | x |  |  | Hex | 0x00
System Data | Manufacturer Info C | Manufacturer Info Block C26 | 0 | 1 | 156 |  |  |  | 79 | 0 | 0xff | hh | x | x |  |  | Hex | 0x00
System Data | Manufacturer Info C | Manufacturer Info Block C27 | 0 | 1 | 157 |  |  |  | 30 | 0 | 0xff | hh | x | x |  |  | Hex | 0x00
System Data | Manufacturer Info C | Manufacturer Info Block C28 | 0 | 1 | 158 |  |  |  | 31 | 0 | 0xff | hh | x | x |  |  | Hex | 0x00
System Data | Manufacturer Info C | Manufacturer Info Block C29 | 0 | 1 | 159 |  |  |  | 32 | 0 | 0xff | hh | x | x |  |  | Hex | 0x00
System Data | Manufacturer Info C | Manufacturer Info Clock C30 | 0 | 1 | 160 |  |  |  | 33 | 0 | 0xff | hh | x | x |  |  | Hex | 0x00
System Data | Manufacturer Info C | Manufacturer Info Block C31 | 0 | 1 | 161 |  |  |  | 34 | 0 | 0xff | hh | x | x |  |  | Hex | 0x00
System Data | Manufacturer Info C | Manufacturer Info Block C32 | 0 | 1 | 162 |  |  |  | 35 | 0 | 0xff | hh | x | x |  |  | Hex | 0x00
System Data | Integrity | Static DF Signature | 0 | 2 | 163 |  |  |  | 0 | 0 | 0x7fff | hhhh | x | x |  |  | hex | 0x0000
System Data | Integrity | Static Chem DF Signature | 5478 | 2 | 165 |  |  |  | 3a4c | 0 | 0x7fff | hhhh | x | x |  |  | hex | 0x8d42
System Data | Integrity | All DF Signature | 0 | 2 | 167 |  |  |  | 0 | 0 | 0x7fff | hhhh | x | x |  |  | hex | 0x0000
I2C Configuration | Data | Manufacture Date | 2021-11-21 | 2 | 169 |  |  |  | 1980-01-01 | 0 | 65535 | z | x | x |  |  | date | 0x2153
I2C Configuration | Data | Serial Number | 10 | 2 | 171 |  |  |  | 1 | 0 | 0xffff | hhhh | x | x |  |  | hex | 0x5203
I2C Configuration | Data | Manufacturer Name | T | 21 | 173 |  |  |  | Texas Instruments | x | x | s | x | x |  |  | - | 0x015400000000000000000000000000000000000000
I2C Configuration | Data | Device Name | bq27z561 | 21 | 194 |  |  |  | bq27z561 | x | x | s | x | x |  |  | - | 0x08627132377a353631000000000000000000000000
I2C Configuration | Data | Device Chemistry | LION | 5 | 215 |  |  |  | LION | x | x | s | x | x |  |  | - | 0x044c494f4e
Lifetimes | Voltage | Cell 1 Max Voltage | 4391 | 2 | 514 |  |  |  | 0 | 0 | 32767 | ddd | x | x |  |  | mV | 0xfe10
Lifetimes | Voltage | Cell 1 Min Voltage | 2851 | 2 | 516 |  |  |  | 32767 | 0 | 32767 | ddd | x | x |  |  | mV | 0xe60a
Lifetimes | Current | Max Charge Current | 1500 | 2 | 518 |  |  |  | 0 | 0 | 32767 | ddd | x | x |  |  | mA | 0xb90b
Lifetimes | Current | Max Discharge Current | -1000 | 2 | 520 |  |  |  | 0 | -32768 | 0 | ddd | x | x |  |  | mA | 0x29f9
Lifetimes | Current | Max Avg Dsg Current | -999 | 2 | 522 |  |  |  | 0 | -32768 | 0 | ddd | x | x |  |  | mA | 0x51fb
Lifetimes | Current | Max Avg Dsg Power | -432 | 2 | 524 |  |  |  | 0 | -32768 | 0 | ddd | x | x |  |  | cW | 0x03fe
Lifetimes | Temperature | Max Temp Cell | 26 | 1 | 526 |  |  |  | -128 | -128 | 127 | ddd | x | x |  |  | Â°C | 0x30
Lifetimes | Temperature | Min Temp Cell | -9 | 1 | 527 |  |  |  | 127 | -128 | 127 | ddd | x | x |  |  | Â°C | 0x09
Lifetimes | Temperature | Max Temp Int Sensor | 23 | 1 | 528 |  |  |  | -128 | -128 | 127 | ddd | x | x |  |  | Â°C | 0x30
Lifetimes | Temperature | Min Temp Int Sensor | -14 | 1 | 529 |  |  |  | 127 | -128 | 127 | ddd | x | x |  |  | Â°C | 0x09
Lifetimes | Charging Events | No Valid Charge Term | 2 | 2 | 530 |  |  |  | 0 | 0 | 32767 | ddd | x | x |  |  | events | 0x0000
Lifetimes | Charging Events | Last Valid Charge Term | 1 | 2 | 532 |  |  |  | 0 | 0 | 32767 | ddd | x | x |  |  | cycles | 0x0000
Lifetimes | Gauging Events | No Of Qmax Updates | 5 | 2 | 534 |  |  |  | 0 | 0 | 32767 | ddd | x | x |  |  | events | 0x0400
Lifetimes | Gauging Events | Last Qmax Update | 2 | 2 | 536 |  |  |  | 0 | 0 | 32767 | ddd | x | x |  |  | cycles | 0x0200
Lifetimes | Gauging Events | No Of Ra Updates | 26 | 2 | 538 |  |  |  | 0 | 0 | 32767 | ddd | x | x |  |  | events | 0x1300
Lifetimes | Gauging Events | Last Ra Update | 2 | 2 | 540 |  |  |  | 0 | 0 | 32767 | ddd | x | x |  |  | cycles | 0x0200
Lifetimes | Time | Total Fw Runtime | 1388 | 4 | 545 |  |  |  | 0 | 0x00000000 | 0xFFFFFFFF | ddd | x/3600 | x*3600 |  |  | s | 0x160d5900
Lifetimes | Time | Time Spent In UT RSOC A | 0 | 4 | 549 |  |  |  | 0 | 0x00000000 | 0xFFFFFFFF | ddd | x/3600 | x*3600 |  |  | s | 0x00000000
Lifetimes | Time | Time Spent In UT RSOC B | 0 | 4 | 553 |  |  |  | 0 | 0x00000000 | 0xFFFFFFFF | ddd | x/3600 | x*3600 |  |  | s | 0x00000000
Lifetimes | Time | Time Spent In UT RSOC C | 0 | 4 | 557 |  |  |  | 0 | 0x00000000 | 0xFFFFFFFF | ddd | x/3600 | x*3600 |  |  | s | 0x00000000
Lifetimes | Time | Time Spent In UT RSOC D | 0 | 4 | 561 |  |  |  | 0 | 0x00000000 | 0xFFFFFFFF | ddd | x/3600 | x*3600 |  |  | s | 0x00000000
Lifetimes | Time | Time Spent In UT RSOC E | 11 | 4 | 565 |  |  |  | 0 | 0x00000000 | 0xFFFFFFFF | ddd | x/3600 | x*3600 |  |  | s | 0x00000000
Lifetimes | Time | Time Spent In UT RSOC F | 5 | 4 | 569 |  |  |  | 0 | 0x00000000 | 0xFFFFFFFF | ddd | x/3600 | x*3600 |  |  | s | 0x00000000
Lifetimes | Time | Time Spent In UT RSOC G | 0 | 4 | 573 |  |  |  | 0 | 0x00000000 | 0xFFFFFFFF | ddd | x/3600 | x*3600 |  |  | s | 0x00000000
Lifetimes | Time | Time Spent In UT RSOC H | 0 | 4 | 577 |  |  |  | 0 | 0x00000000 | 0xFFFFFFFF | ddd | x/3600 | x*3600 |  |  | s | 0x00000000
Lifetimes | Time | Time Spent In LT RSOC A | 0 | 4 | 581 |  |  |  | 0 | 0x00000000 | 0xFFFFFFFF | ddd | x/3600 | x*3600 |  |  | s | 0x00000000
Lifetimes | Time | Time Spent In LT RSOC B | 0 | 4 | 585 |  |  |  | 0 | 0x00000000 | 0xFFFFFFFF | ddd | x/3600 | x*3600 |  |  | s | 0x00000000
Lifetimes | Time | Time Spent In LT RSOC C | 0 | 4 | 589 |  |  |  | 0 | 0x00000000 | 0xFFFFFFFF | ddd | x/3600 | x*3600 |  |  | s | 0x00000000
Lifetimes | Time | Time Spent In LT RSOC D | 0 | 4 | 593 |  |  |  | 0 | 0x00000000 | 0xFFFFFFFF | ddd | x/3600 | x*3600 |  |  | s | 0x00000000
Lifetimes | Time | Time Spent In LT RSOC E | 11 | 4 | 597 |  |  |  | 0 | 0x00000000 | 0xFFFFFFFF | ddd | x/3600 | x*3600 |  |  | s | 0x00000000
Lifetimes | Time | Time Spent In LT RSOC F | 0 | 4 | 601 |  |  |  | 0 | 0x00000000 | 0xFFFFFFFF | ddd | x/3600 | x*3600 |  |  | s | 0x00000000
Lifetimes | Time | Time Spent In LT RSOC G | 0 | 4 | 605 |  |  |  | 0 | 0x00000000 | 0xFFFFFFFF | ddd | x/3600 | x*3600 |  |  | s | 0x00000000
Lifetimes | Time | Time Spent In LT RSOC H | 0 | 4 | 609 |  |  |  | 0 | 0x00000000 | 0xFFFFFFFF | ddd | x/3600 | x*3600 |  |  | s | 0x00000000
Lifetimes | Time | Time Spent In STL RSOC A | 0 | 4 | 613 |  |  |  | 0 | 0x00000000 | 0xFFFFFFFF | ddd | x/3600 | x*3600 |  |  | s | 0x00000000
Lifetimes | Time | Time Spent In STL RSOC B | 0 | 4 | 617 |  |  |  | 0 | 0x00000000 | 0xFFFFFFFF | ddd | x/3600 | x*3600 |  |  | s | 0x00000000
Lifetimes | Time | Time Spent In STL RSOC C | 0 | 4 | 621 |  |  |  | 0 | 0x00000000 | 0xFFFFFFFF | ddd | x/3600 | x*3600 |  |  | s | 0x00000000
Lifetimes | Time | Time Spent In STL RSOC D | 0 | 4 | 625 |  |  |  | 0 | 0x00000000 | 0xFFFFFFFF | ddd | x/3600 | x*3600 |  |  | s | 0x00000000
Lifetimes | Time | Time Spent In STL RSOC E | 225 | 4 | 629 |  |  |  | 0 | 0x00000000 | 0xFFFFFFFF | ddd | x/3600 | x*3600 |  |  | s | 0x00000000
Lifetimes | Time | Time Spent In STL RSOC F | 0 | 4 | 633 |  |  |  | 0 | 0x00000000 | 0xFFFFFFFF | ddd | x/3600 | x*3600 |  |  | s | 0x00000000
Lifetimes | Time | Time Spent In STL RSOC G | 0 | 4 | 637 |  |  |  | 0 | 0x00000000 | 0xFFFFFFFF | ddd | x/3600 | x*3600 |  |  | s | 0x00000000
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
Lifetimes | Time | Time Spent In OT RSOC D | 0 | 4 | 753 |  |  |  | 0 | 0x00000000 | 0xFFFFFFFF | ddd | x/3600 | x*3600 |  |  | s | 0x00000000
Lifetimes | Time | Time Spent In OT RSOC E | 0 | 4 | 757 |  |  |  | 0 | 0x00000000 | 0xFFFFFFFF | ddd | x/3600 | x*3600 |  |  | s | 0x00000000
Lifetimes | Time | Time Spent In OT RSOC F | 0 | 4 | 761 |  |  |  | 0 | 0x00000000 | 0xFFFFFFFF | ddd | x/3600 | x*3600 |  |  | s | 0x00000000
Lifetimes | Time | Time Spent In OT RSOC G | 0 | 4 | 765 |  |  |  | 0 | 0x00000000 | 0xFFFFFFFF | ddd | x/3600 | x*3600 |  |  | s | 0x00000000
Lifetimes | Time | Time Spent In OT RSOC H | 0 | 4 | 769 |  |  |  | 0 | 0x00000000 | 0xFFFFFFFF | ddd | x/3600 | x*3600 |  |  | s | 0x00000000
Ra Table | R_a0 | Cell0 R_a flag | 55 | 2 | 256 |  |  |  | ff55 | 0 | 0xffff | hhhh | x | x | STATUS7|STATUS6|STATUS5|STATUS4|STATUS3|STATUS2|STATUS1|STATUS0|FLAG7|FLAG6|FLAG5|FLAG4|FLAG3|FLAG2|FLAG1|FLAG0 |  | - | 0x5500
Ra Table | R_a0 | Cell0 R_a 0 | 85 | 2 | 258 |  |  |  | 159 | 0 | 32767 | ddd | x | x |  |  | 2^-10ohm | 0x6e00
Ra Table | R_a0 | Cell0 R_a 1 | 43 | 2 | 260 |  |  |  | 58 | 0 | 32767 | ddd | x | x |  |  | 2^-10ohm | 0x4600
Ra Table | R_a0 | Cell0 R_a 2 | 42 | 2 | 262 |  |  |  | 65 | 0 | 32767 | ddd | x | x |  |  | 2^-10ohm | 0x4700
Ra Table | R_a0 | Cell0 R_a 3 | 48 | 2 | 264 |  |  |  | 79 | 0 | 32767 | ddd | x | x |  |  | 2^-10ohm | 0x4e00
Ra Table | R_a0 | Cell0 R_a 4 | 58 | 2 | 266 |  |  |  | 90 | 0 | 32767 | ddd | x | x |  |  | 2^-10ohm | 0x5500
Ra Table | R_a0 | Cell0 R_a 5 | 41 | 2 | 268 |  |  |  | 63 | 0 | 32767 | ddd | x | x |  |  | 2^-10ohm | 0x4100
Ra Table | R_a0 | Cell0 R_a 6 | 46 | 2 | 270 |  |  |  | 76 | 0 | 32767 | ddd | x | x |  |  | 2^-10ohm | 0x4900
Ra Table | R_a0 | Cell0 R_a 7 | 45 | 2 | 272 |  |  |  | 82 | 0 | 32767 | ddd | x | x |  |  | 2^-10ohm | 0x4700
Ra Table | R_a0 | Cell0 R_a 8 | 46 | 2 | 274 |  |  |  | 82 | 0 | 32767 | ddd | x | x |  |  | 2^-10ohm | 0x4700
Ra Table | R_a0 | Cell0 R_a 9 | 48 | 2 | 276 |  |  |  | 87 | 0 | 32767 | ddd | x | x |  |  | 2^-10ohm | 0x4a00
Ra Table | R_a0 | Cell0 R_a 10 | 49 | 2 | 278 |  |  |  | 87 | 0 | 32767 | ddd | x | x |  |  | 2^-10ohm | 0x4800
Ra Table | R_a0 | Cell0 R_a 11 | 55 | 2 | 280 |  |  |  | 101 | 0 | 32767 | ddd | x | x |  |  | 2^-10ohm | 0x5000
Ra Table | R_a0 | Cell0 R_a 12 | 69 | 2 | 282 |  |  |  | 118 | 0 | 32767 | ddd | x | x |  |  | 2^-10ohm | 0x6200
Ra Table | R_a0 | Cell0 R_a 13 | 148 | 2 | 284 |  |  |  | 191 | 0 | 32767 | ddd | x | x |  |  | 2^-10ohm | 0x7b00
Ra Table | R_a0 | Cell0 R_a 14 | 238 | 2 | 286 |  |  |  | 282 | 0 | 32767 | ddd | x | x |  |  | 2^-10ohm | 0xca00
Ra Table | R_a0x | xCell0 R_a flag | 0 | 2 | 320 |  |  |  | ffff | 0 | 0xffff | hhhh | x | x | STATUS7|STATUS6|STATUS5|STATUS4|STATUS3|STATUS2|STATUS1|STATUS0|FLAG7|FLAG6|FLAG5|FLAG4|FLAG3|FLAG2|FLAG1|FLAG0 |  | - | 0x0000
Ra Table | R_a0x | xCell0 R_a 0 | 85 | 2 | 322 |  |  |  | 159 | 0 | 32767 | ddd | x | x |  |  | 2^-10ohm | 0x6e00
Ra Table | R_a0x | xCell0 R_a 1 | 43 | 2 | 324 |  |  |  | 58 | 0 | 32767 | ddd | x | x |  |  | 2^-10ohm | 0x4600
Ra Table | R_a0x | xCell0 R_a 2 | 42 | 2 | 326 |  |  |  | 65 | 0 | 32767 | ddd | x | x |  |  | 2^-10ohm | 0x4700
Ra Table | R_a0x | xCell0 R_a 3 | 48 | 2 | 328 |  |  |  | 79 | 0 | 32767 | ddd | x | x |  |  | 2^-10ohm | 0x4e00
Ra Table | R_a0x | xCell0 R_a 4 | 58 | 2 | 330 |  |  |  | 90 | 0 | 32767 | ddd | x | x |  |  | 2^-10ohm | 0x5500
Ra Table | R_a0x | xCell0 R_a 5 | 41 | 2 | 332 |  |  |  | 63 | 0 | 32767 | ddd | x | x |  |  | 2^-10ohm | 0x4100
Ra Table | R_a0x | xCell0 R_a 6 | 46 | 2 | 334 |  |  |  | 76 | 0 | 32767 | ddd | x | x |  |  | 2^-10ohm | 0x4900
Ra Table | R_a0x | xCell0 R_a 7 | 45 | 2 | 336 |  |  |  | 82 | 0 | 32767 | ddd | x | x |  |  | 2^-10ohm | 0x4700
Ra Table | R_a0x | xCell0 R_a 8 | 46 | 2 | 338 |  |  |  | 82 | 0 | 32767 | ddd | x | x |  |  | 2^-10ohm | 0x4700
Ra Table | R_a0x | xCell0 R_a 9 | 48 | 2 | 340 |  |  |  | 87 | 0 | 32767 | ddd | x | x |  |  | 2^-10ohm | 0x4a00
Ra Table | R_a0x | xCell0 R_a 10 | 49 | 2 | 342 |  |  |  | 87 | 0 | 32767 | ddd | x | x |  |  | 2^-10ohm | 0x4800
Ra Table | R_a0x | xCell0 R_a 11 | 55 | 2 | 344 |  |  |  | 101 | 0 | 32767 | ddd | x | x |  |  | 2^-10ohm | 0x5000
Ra Table | R_a0x | xCell0 R_a 12 | 69 | 2 | 346 |  |  |  | 118 | 0 | 32767 | ddd | x | x |  |  | 2^-10ohm | 0x6200
Ra Table | R_a0x | xCell0 R_a 13 | 148 | 2 | 348 |  |  |  | 191 | 0 | 32767 | ddd | x | x |  |  | 2^-10ohm | 0x6d00
Ra Table | R_a0x | xCell0 R_a 14 | 238 | 2 | 350 |  |  |  | 282 | 0 | 32767 | ddd | x | x |  |  | 2^-10ohm | 0xb300
