SC3228/BatteryProgrammer/Batt Programmer_V2/Batt Programmer/Code/V2 Test and config/Manual/Startup.png

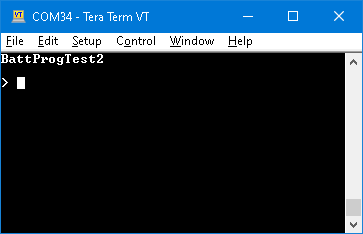
Batt Programmer_V2/Batt Programmer/Code/V2 Test and config/Manual/Startup.png
