SC3228/BatteryProgrammer/Batt Programmer_V2/Batt Programmer/Manual/bootloader drive.png

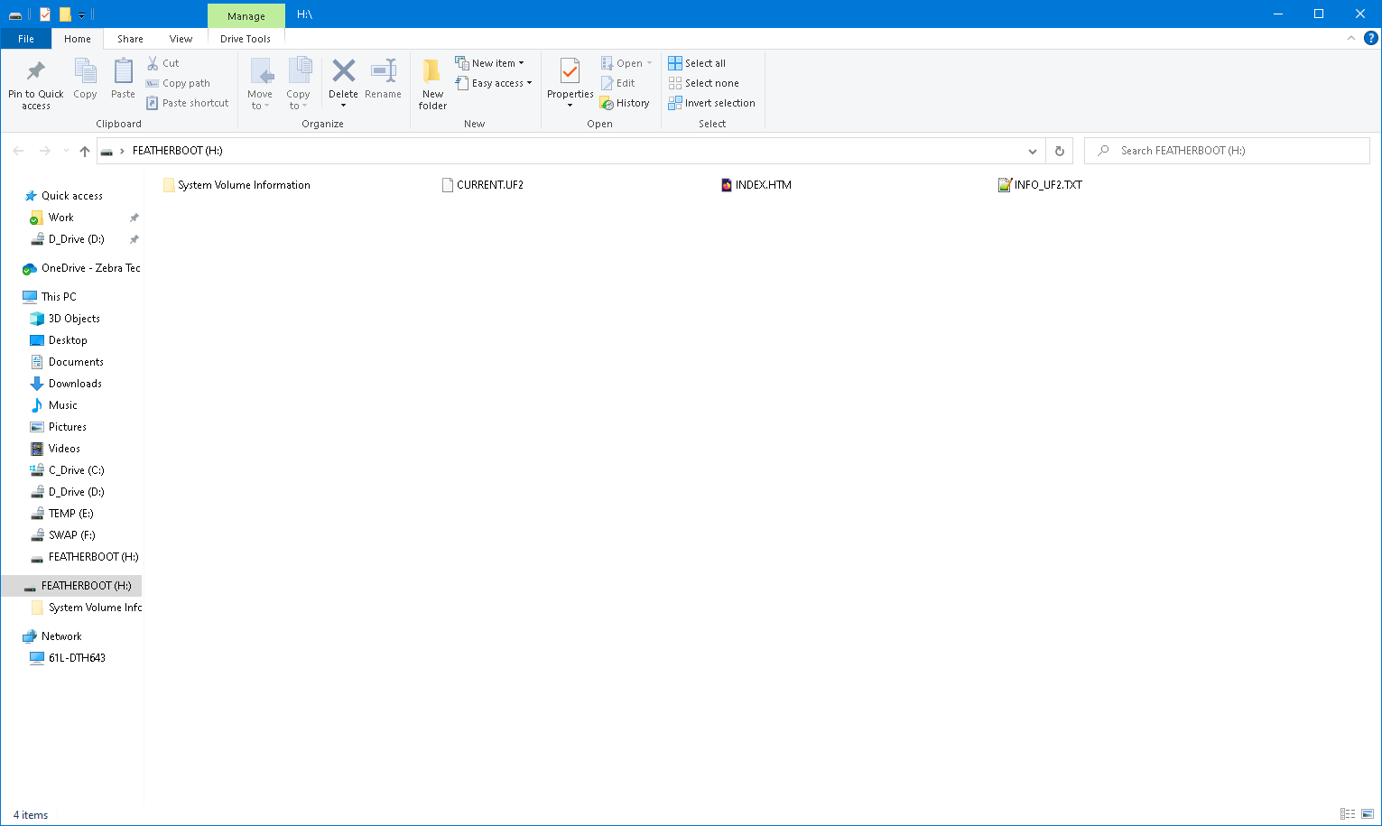
Batt Programmer_V2/Batt Programmer/Manual/bootloader drive.png
