SC3228/BatteryProgrammer/Batt Programmer_V2/Batt Programmer/Manual/extra pics/Board Bot.jpg

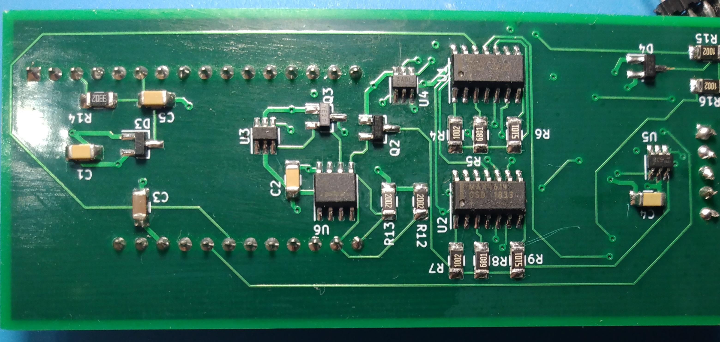
Batt Programmer_V2/Batt Programmer/Manual/extra pics/Board Bot.jpg
