SC3228/BatteryProgrammer/Batt Programmer_V2/Batt Programmer/Manual/extra pics/Board Top.jpg

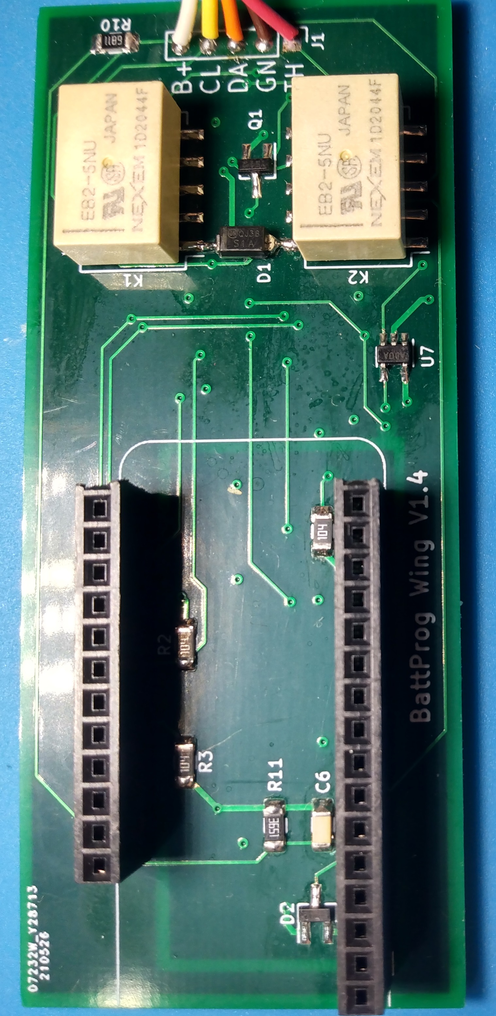
Batt Programmer_V2/Batt Programmer/Manual/extra pics/Board Top.jpg
