SC3228/BatteryProgrammer/Batt Programmer_V2/Batt Programmer/Manual/extra pics/V2Box.jpg

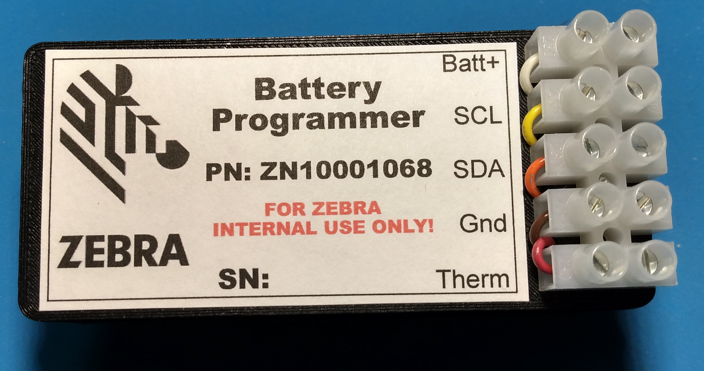
Batt Programmer_V2/Batt Programmer/Manual/extra pics/V2Box.jpg
