SC3228/BatteryProgrammer/Batt Programmer_V2/Batt Programmer/Manual/V1/20180212_135318.jpg

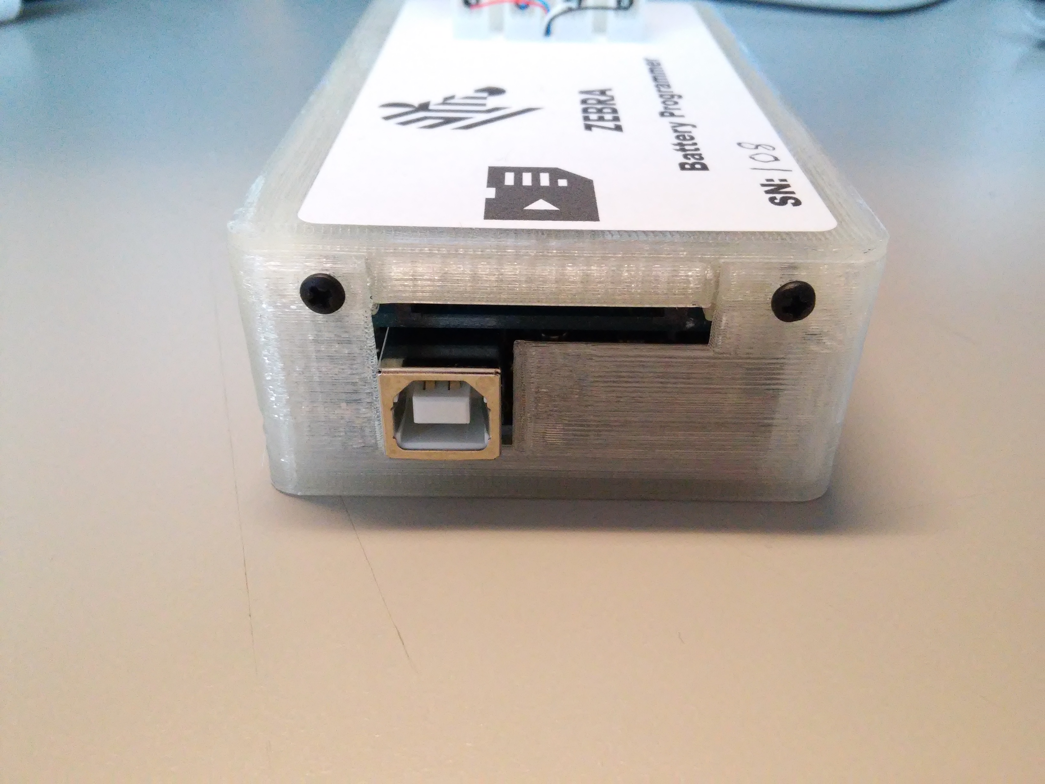
Batt Programmer_V2/Batt Programmer/Manual/V1/20180212_135318.jpg
