SC3228/BatteryProgrammer/Batt Programmer_V2/Batt Programmer/Manual/V1/done.png

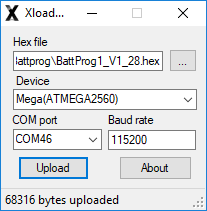
Batt Programmer_V2/Batt Programmer/Manual/V1/done.png
