SC3228/BatteryProgrammer/Batt Programmer_V2/Batt Programmer/Manual/V1/hexselect.png

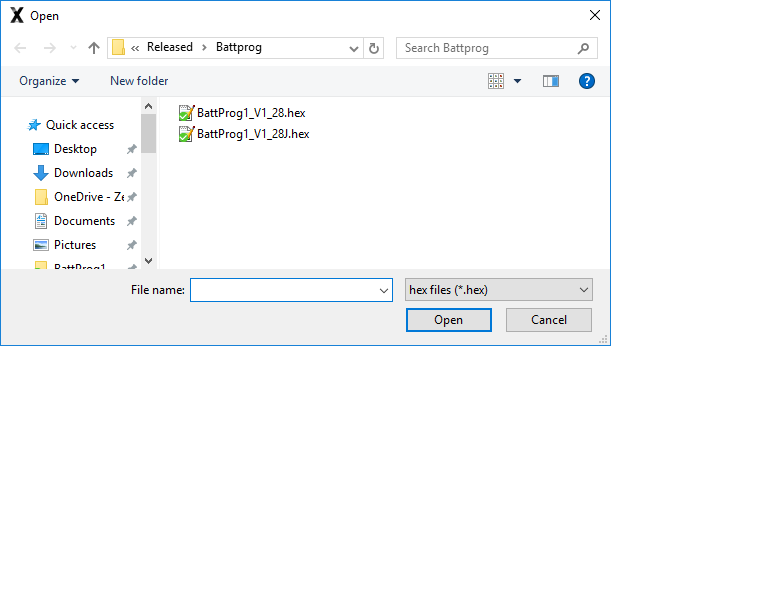
Batt Programmer_V2/Batt Programmer/Manual/V1/hexselect.png
