SC3228/BatteryProgrammer/Batt Programmer_V2/Batt Programmer/Manual/V1/loading.png

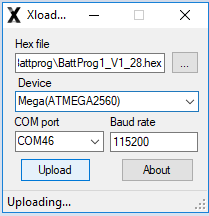
Batt Programmer_V2/Batt Programmer/Manual/V1/loading.png
