SC3228/BatteryProgrammer/Batt Programmer_V2/Batt Programmer/GG Programming/Data maps/1_5X test.txt

P 0,2
P 6,8
P 20,2
P 65,32
P 98,32
P 131,32
P 169,25
P 390,17
P 411,4
P 448,2
P 514,28
P 545,228
P 1635,2
