SC3228/BatteryProgrammer/Batt Programmer_V2/Batt Programmer/Battery schematics/BTRY-MC40.pdf

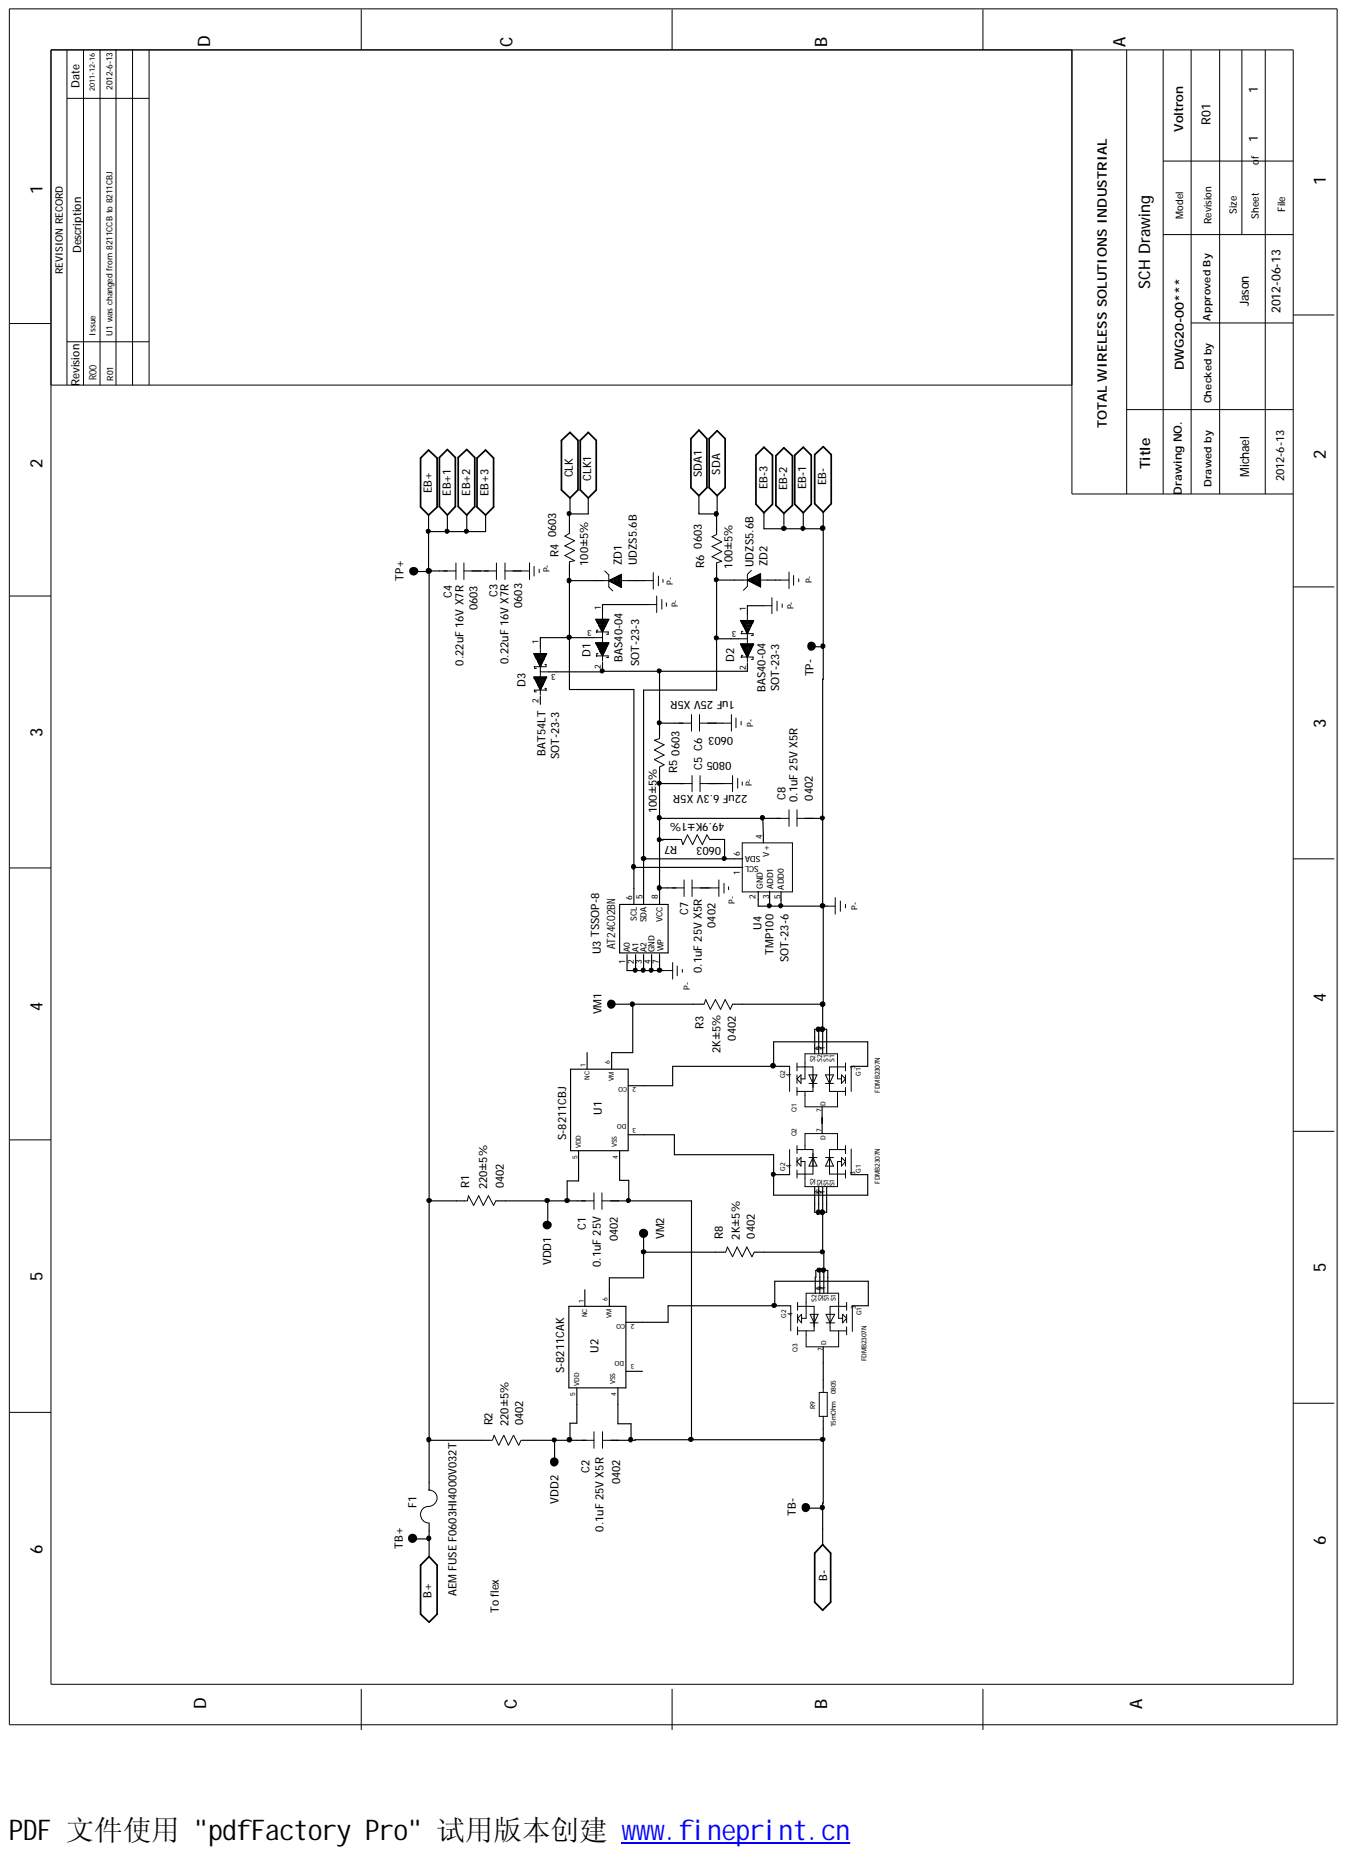
[picture p78: page 1]

R01 U1 was changed from 8211CCB to 8211CBJ 2012-6-13

TOTAL WIRELESS SOLUTIONS INDUSTRIAL

Revision Approved By Checked by Drawed by

1 A0 2 A1 3 A2 4 GND 5 SDA 6 SCL 7 WP 8 VCC

PDF 文件使用 "pdfFactory Pro" 试用版本创建 www.fineprint.cn
