SC3228/BatteryProgrammer/Batt Programmer_V2/Batt Programmer/Battery schematics/MC18ProductionPack.pdf

Description | Date
6 | 5 | 4 | 3 | 2 | 1

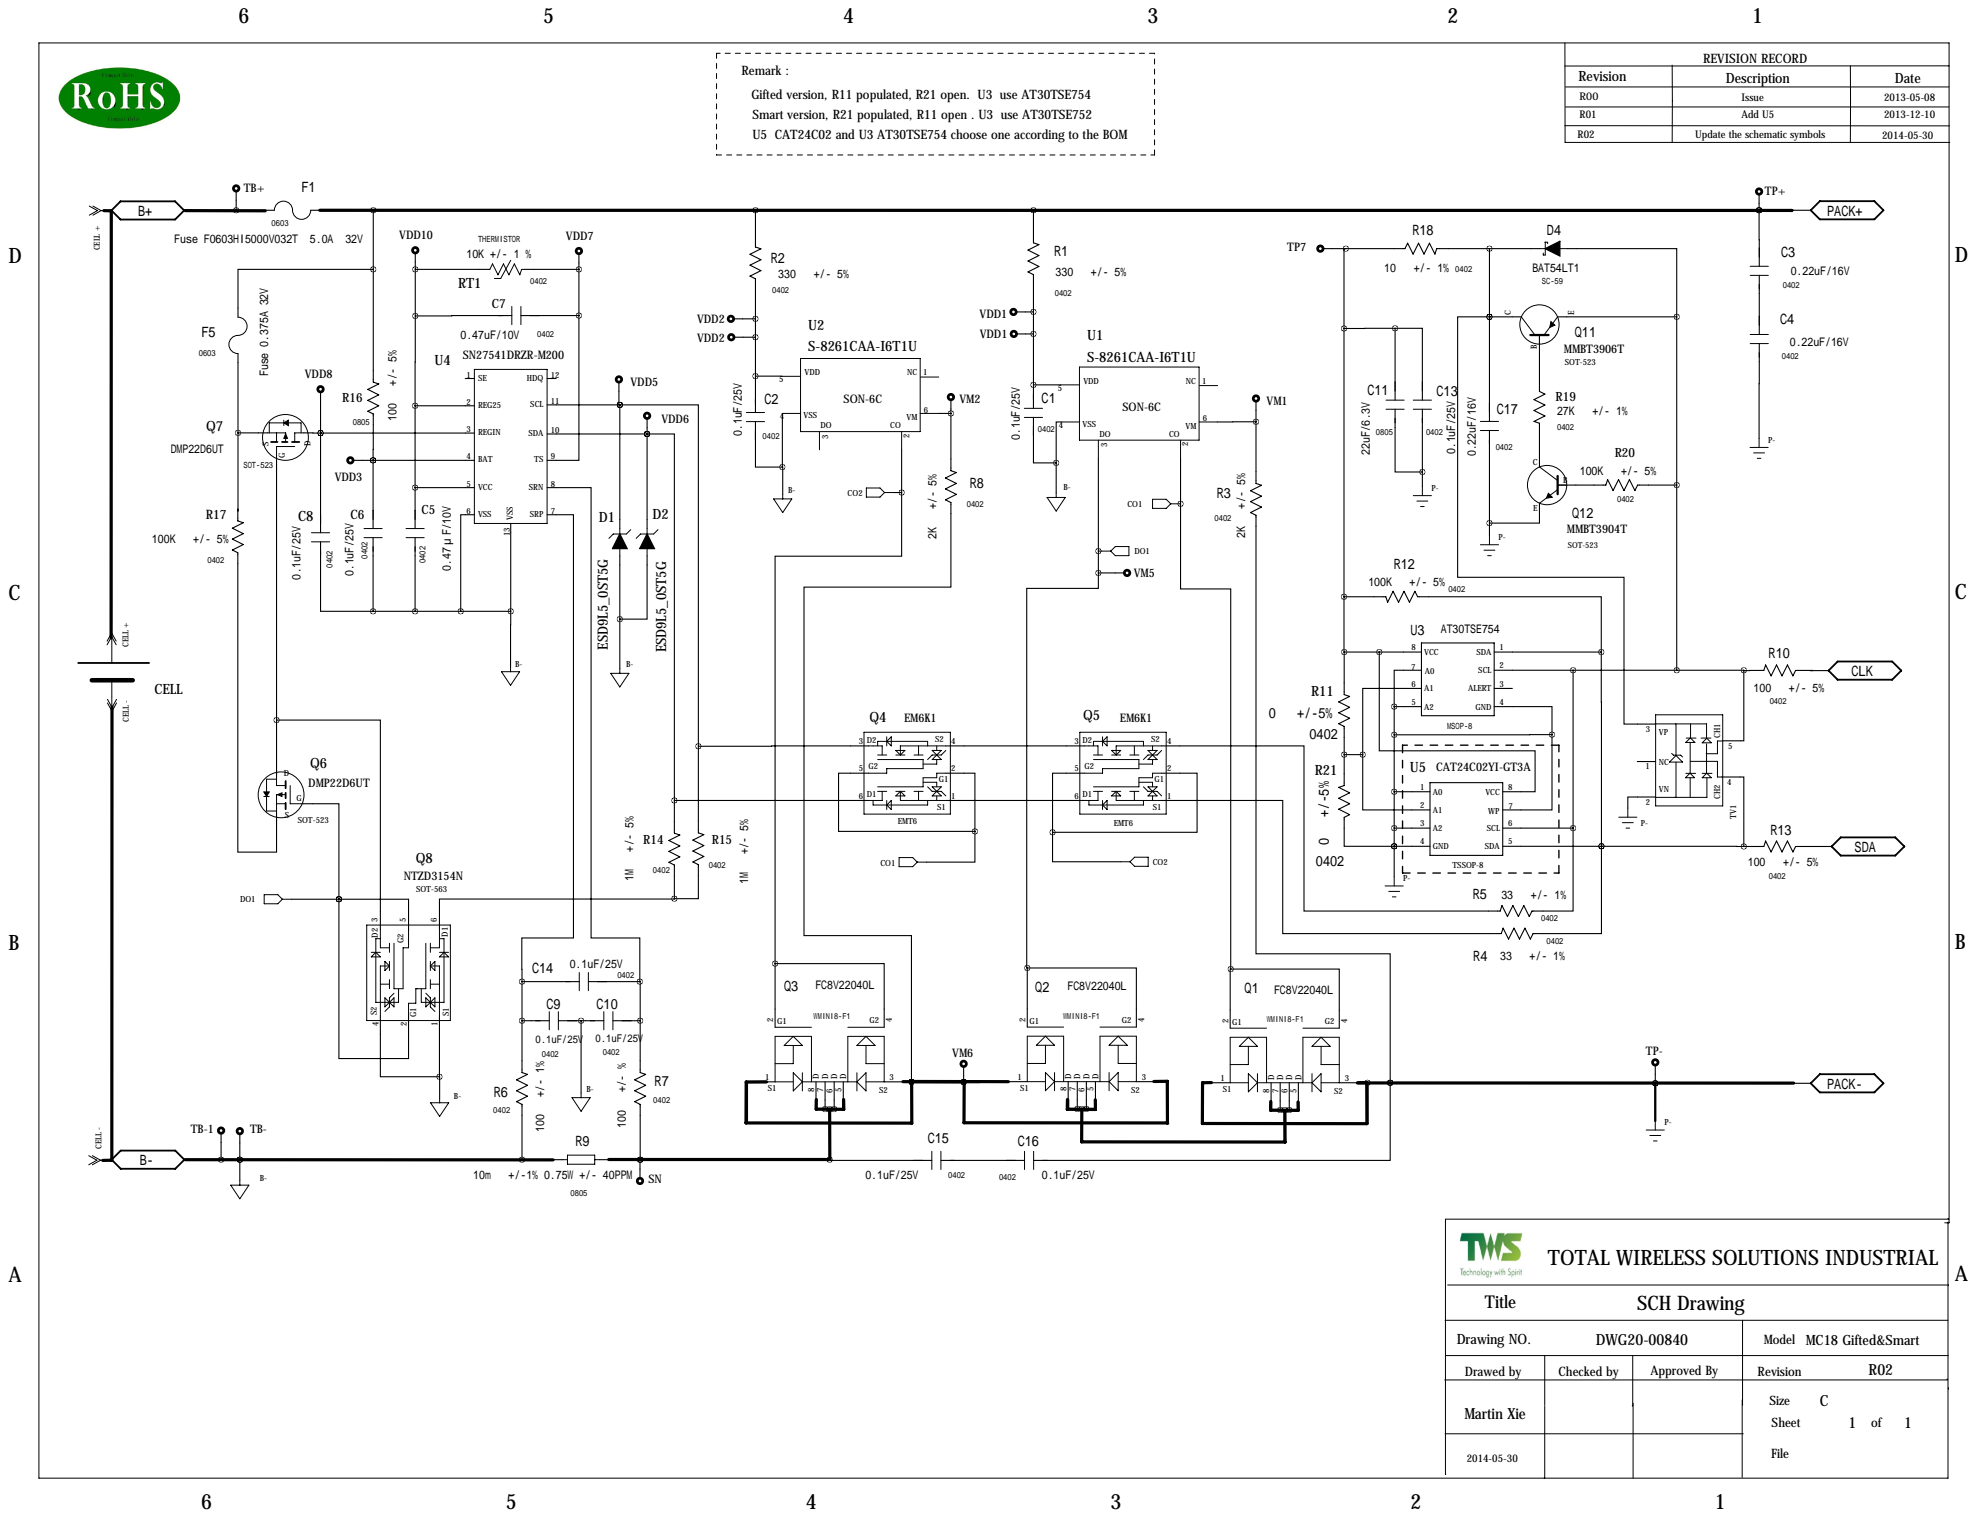
[picture p79: page 1]

Gifted version, R11 populated, R21 open. U3 use AT30TSE754
Smart version, R21 populated, R11 open . U3 use AT30TSE752
U5 CAT24C02 and U3 AT30TSE754 choose one according to the BOM

TOTAL WIRELESS SOLUTIONS INDUSTRIAL

Drawing NO. DWG20-00840 | Model MC18 Gifted&Smart

Drawed by | Checked by | Approved By | Revision R02
