SC3228/BatteryProgrammer/Batt Programmer_V2/Batt Programmer/Battery schematics/RogueProductionPack.pdf

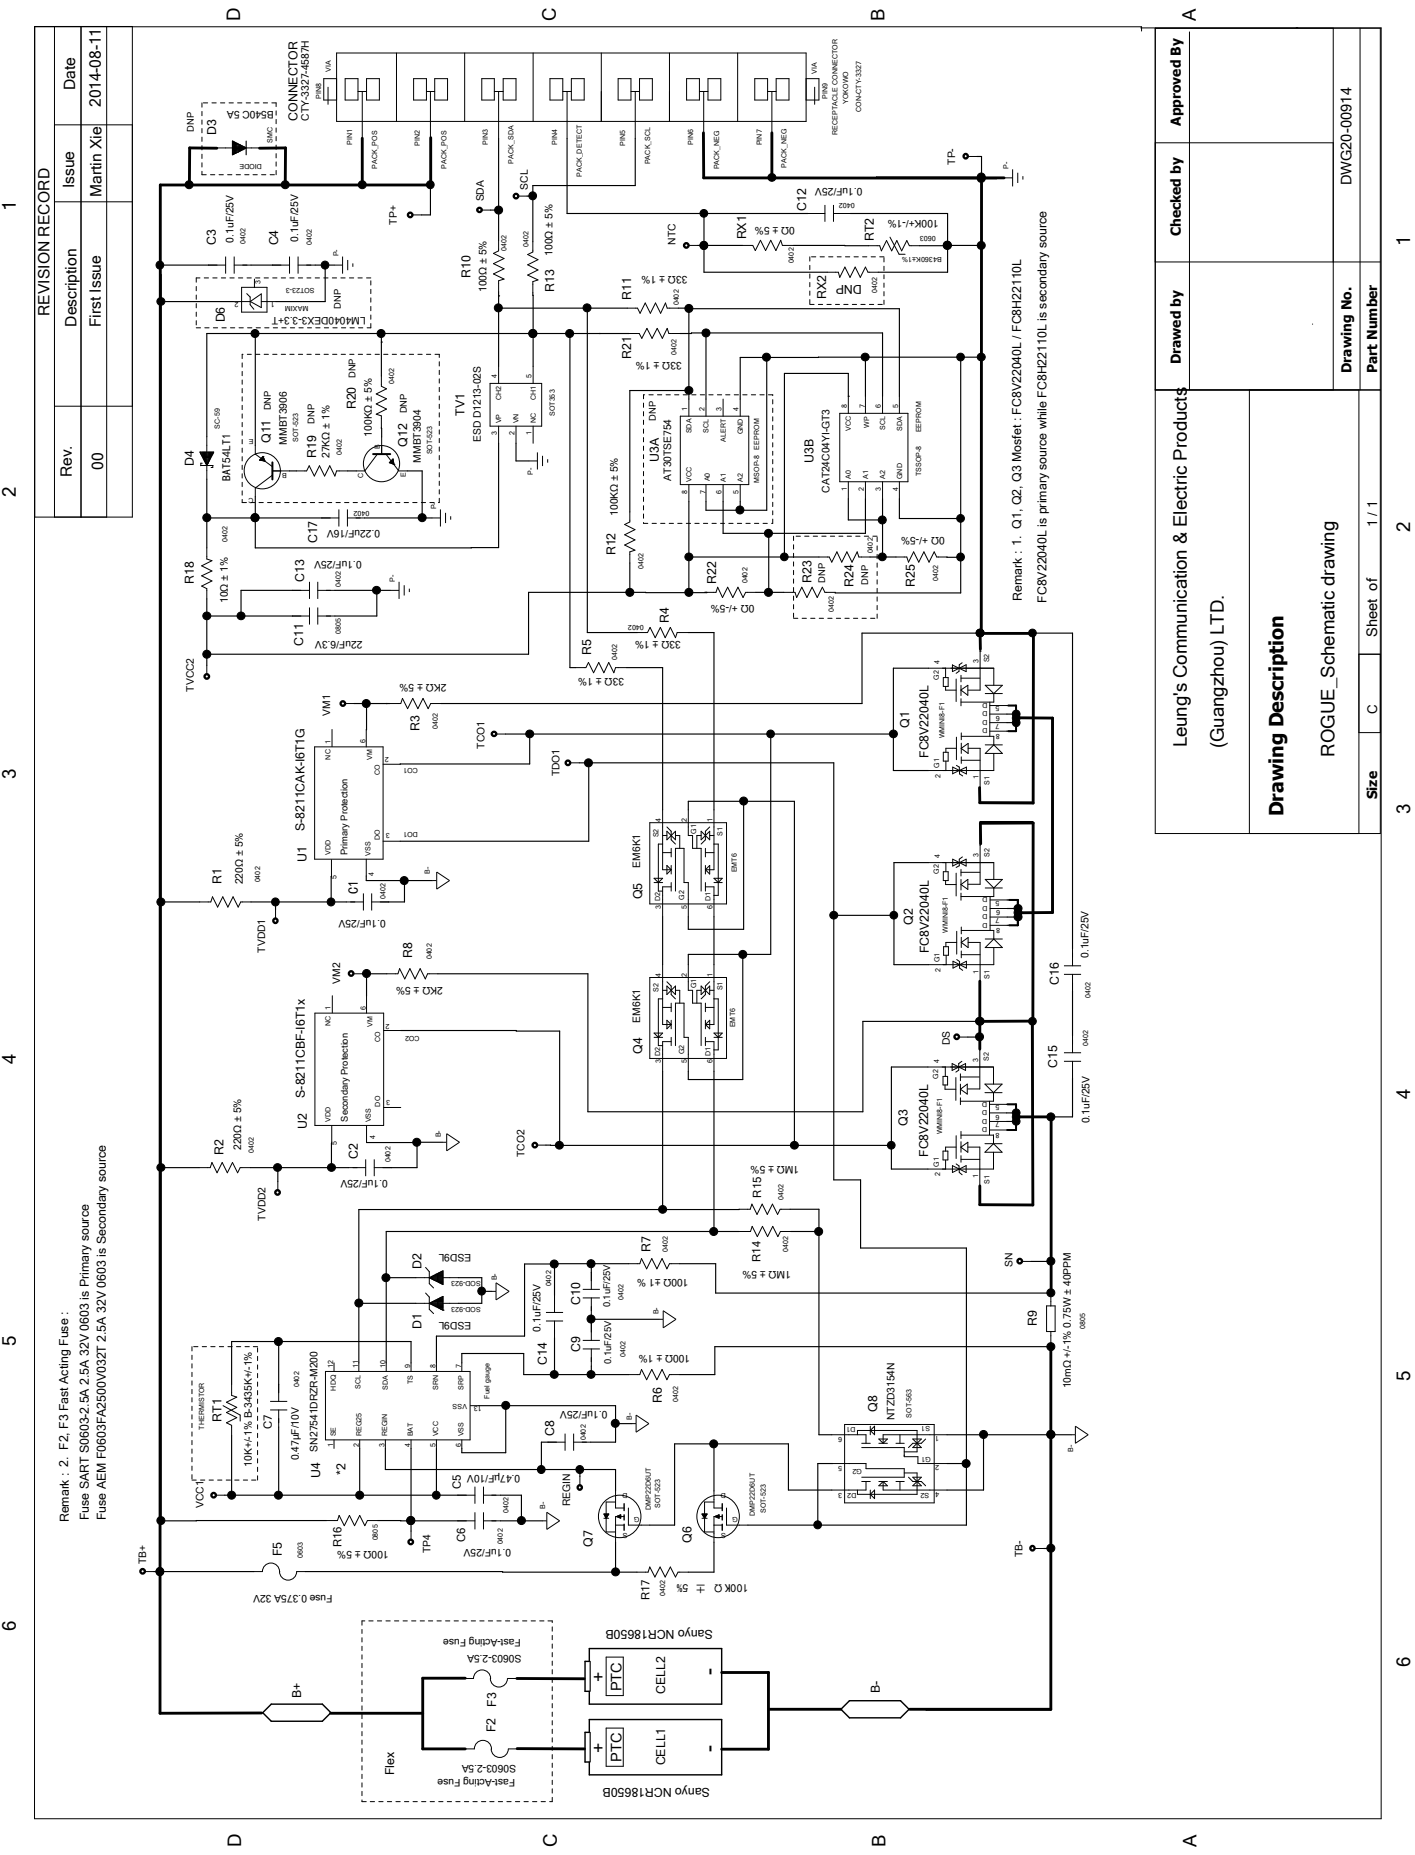
[picture p80: page 1]

Approved By Checked by Drawed by

00 First Issue Martin Xie

TB+ TP+ TVDD2 TVDD1 TVCC2 TDO1TCO1 TCO2 DS VCC1 TP4 REGIN VM2 VM1 1 NC2 CO 3 DO 4 VSS 5 VDD 6 VM U1 S-8211CAK-I6T1G Primary Protection R11

FC8V22040L is primary source while FC8H22110L is secondary source

C Sheet of Part Number 1 / 1

Leung's Communication & Electric Products

Fuse AEM F0603FA2500V032T 2.5A 32V 0603 is Secondary source

Fuse SART S0603-2.5A 2.5A 32V 0603 is Primary source

2. F2, F3 Fast Acting Fuse : Remark :

1 SE 2 REG25 3 REGIN 4 BAT 5 VCC 6 VSS 7 SRP 8 SRN 9 TS 10 SDA 11 SCL 12 HDQ
