SC3228/BatteryProgrammer/Batt Programmer_V2/Batt Programmer/Battery schematics/Sentry 2X Battery Pack Schematic .pdf

DATE | Change History | Issued By | Checked By | Approved By
2017/4/27 | A1: New Release | Monkee Li | Jason Wu | XJJ

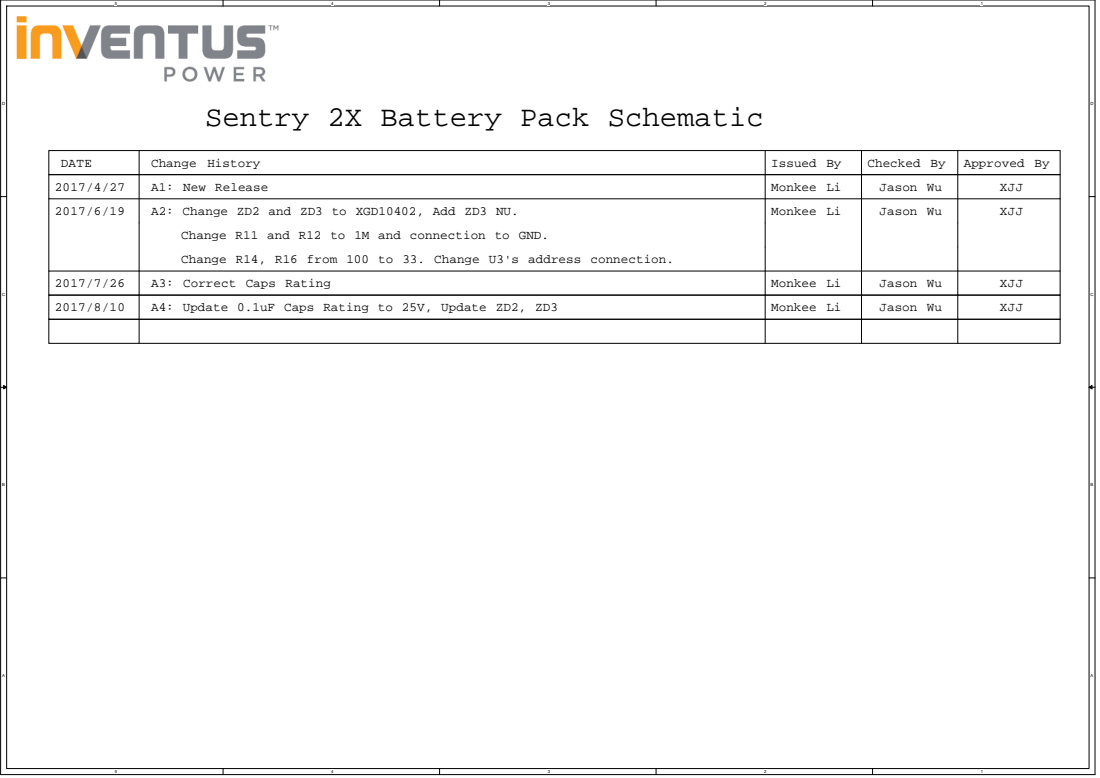
[picture p81: page 1]

Sentry 2X Battery Pack Schematic

2017/6/19 | A2: Change ZD2 and ZD3 to XGD10402, Add ZD3 NU. Change R11 and R12 to 1M and connection to GND. Change R14, R16 from 100 to 33. Change U3's address connection. | Monkee Li | Jason Wu | XJJ

2017/7/26 | A3: Correct Caps Rating | Monkee Li | Jason Wu | XJJ
2017/8/10 | A4: Update 0.1uF Caps Rating to 25V, Update ZD2, ZD3 | Monkee Li | Jason Wu | XJJ

# 6708 Sentry 2X Battery Pack

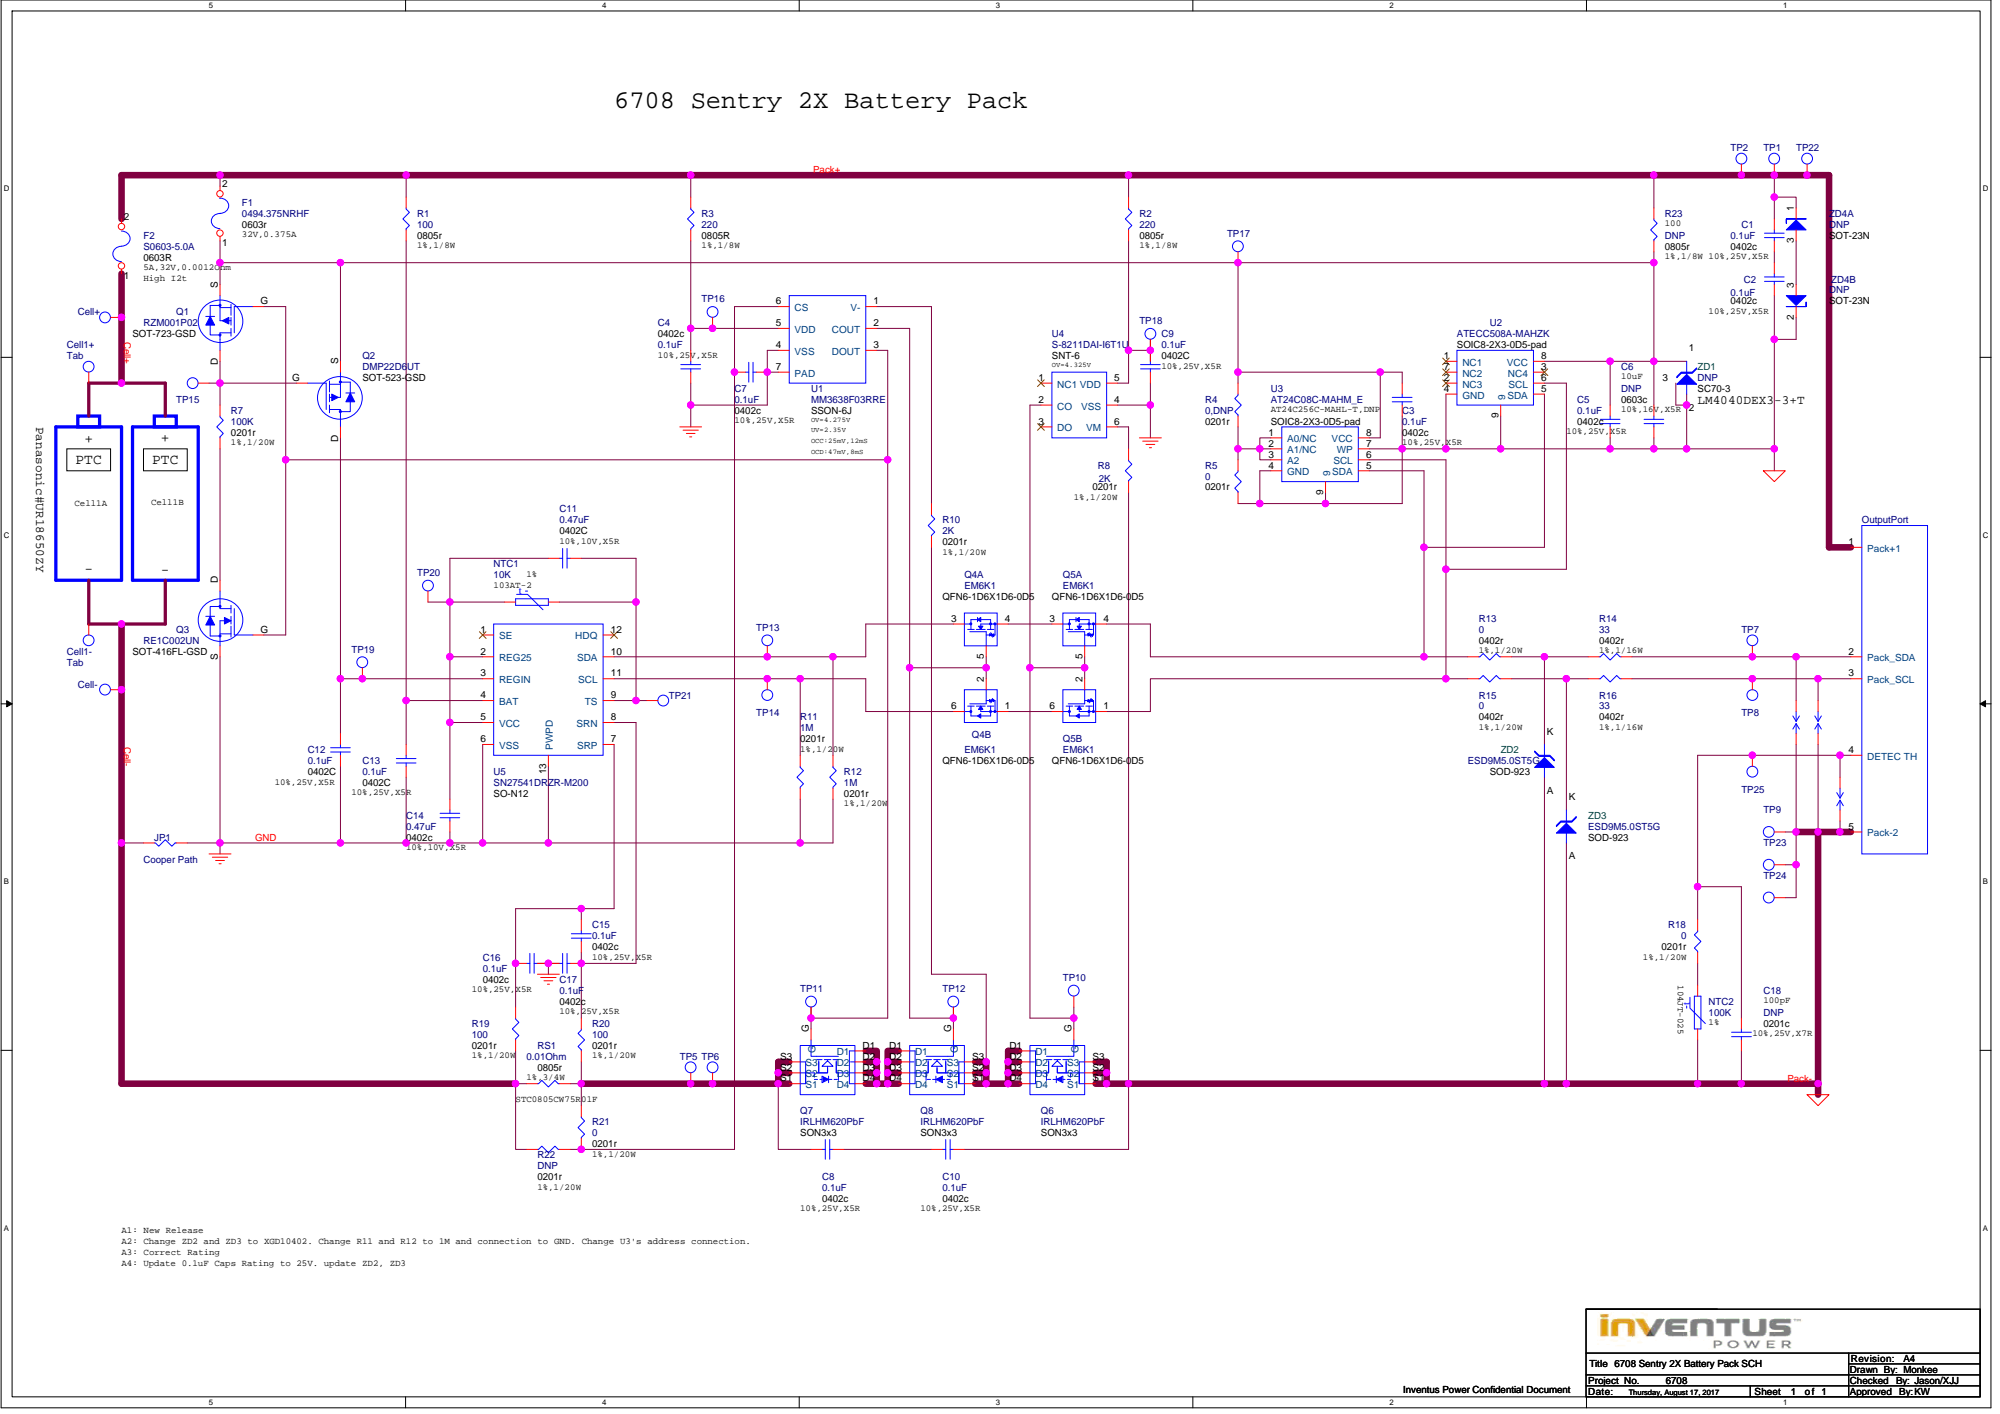
[picture p82: page 2]

A1: New Release
A2: Change ZD2 and ZD3 to XGD10402. Change R11 and R12 to 1M and connection to GND. Change U3's address connection.
A3: Correct Rating
A4: Update 0.1uF Caps Rating to 25V. update ZD2, ZD3
