SC3228/BatteryProgrammer/Batt Programmer_V2/Batt Programmer/Battery schematics/Zebra_Ironman_SCH_R03_MV_20160816.pdf

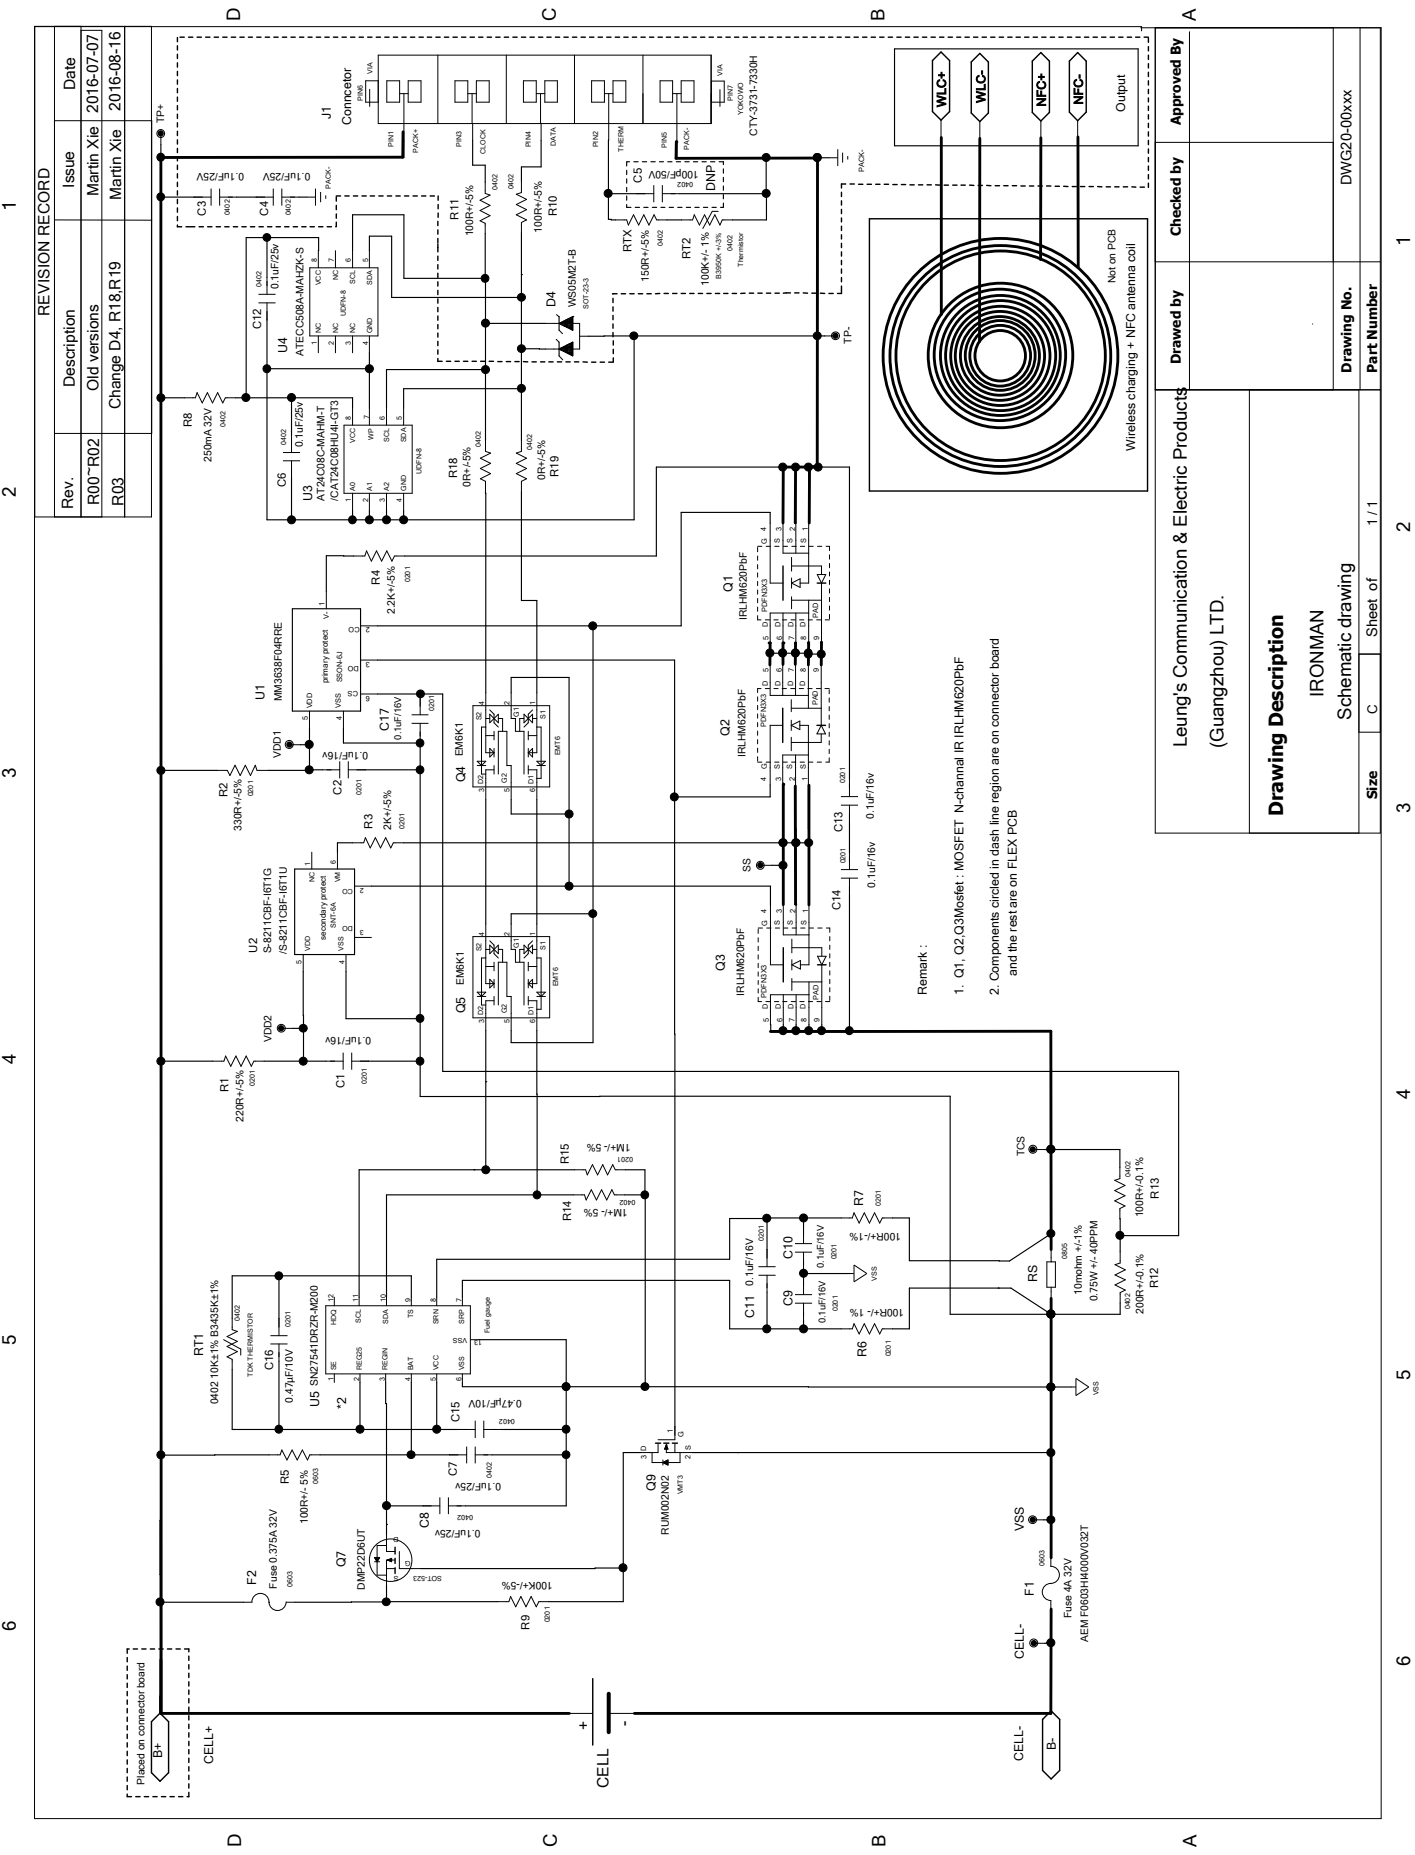
[picture p83: page 1]

Approved By Checked by Drawed by

Wireless charging + NFC antenna coil Output

TP+ RTX 150R+/-5%0402 1 V- 5 VDD 4 VSS 3 DO

R00~R02 Old versions Martin Xie

C Sheet of Part Number 1 / 1

Leung's Communication & Electric Products

primary protect secondary protect

2. Components circled in dash line region are on connector board

and the rest are on FLEX PCB

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

Placed on connector board
