SC3228/BatteryProgrammer/Batt Programmer_V2/Batt Programmer/Battery schematics/Zebra_TC70_SCH_R01_(FG)_20160316.pdf

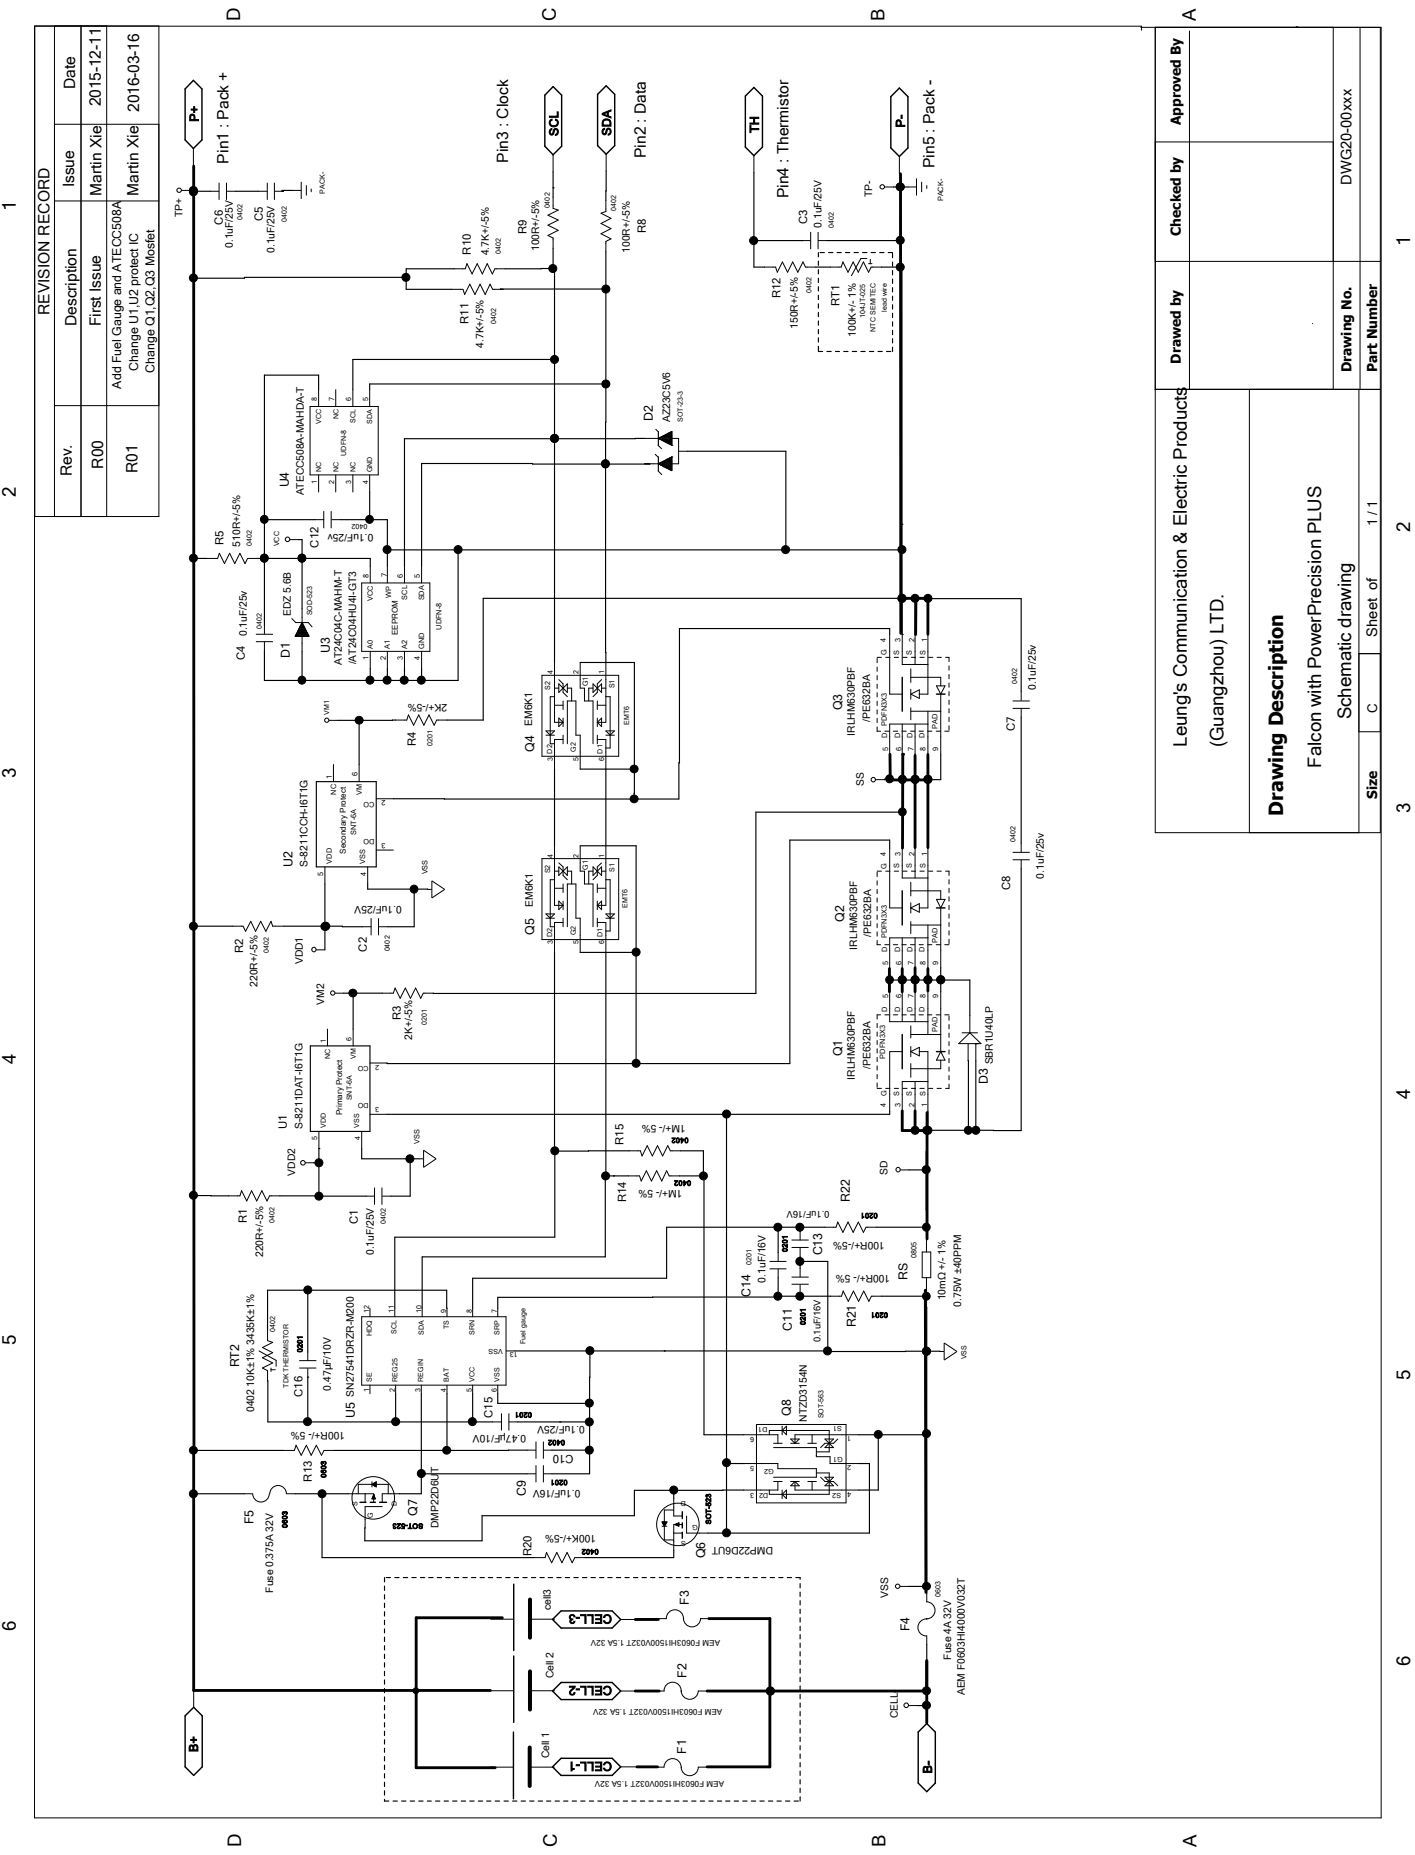
[picture p84: page 1]

Approved By Checked by Drawed by

R00 First Issue Martin Xie

Add Fuel Gauge and ATECC508A

C Sheet of Part Number 1 / 1

Leung's Communication & Electric Products

Falcon with PowerPrecision PLUS

Primary Protect Secondary Protect
