SC3228/BatteryProgrammer/Batt Programmer_V2/Batt Programmer/IO Board/PDFs/IO Board-B_Cu.pdf

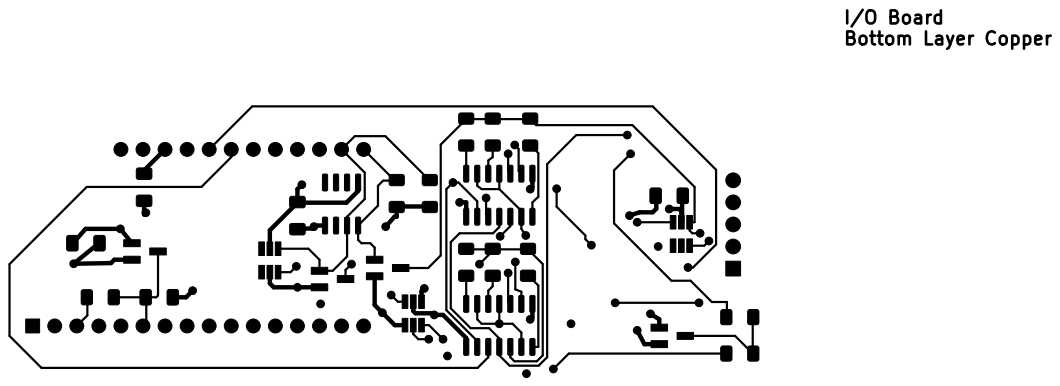
[picture p85: page 1]

I/O Board Bottom Layer Copper

File: IO Board.kicad_pcb Sheet:
Id: 1/1 Title: I/O Board Layout
