SC3228/BatteryProgrammer/Batt Programmer_V2/Batt Programmer/IO Board/PDFs/IO Board-B_Silkscreen.pdf

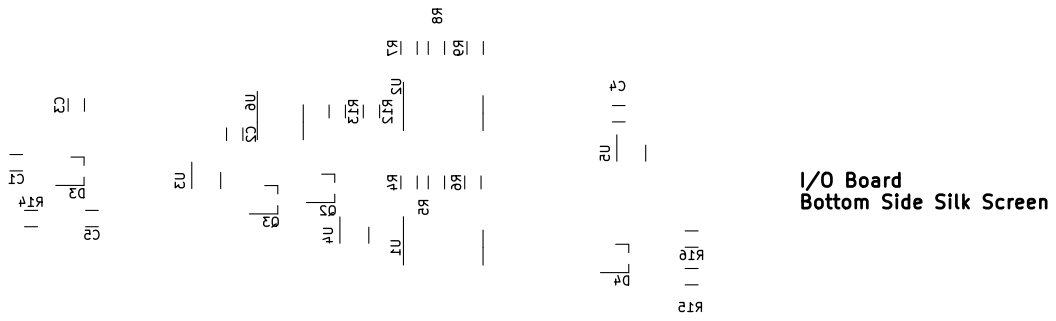
[picture p89: page 1]

File: IO Board.kicad_pcb Sheet:
Id: 1/1 Title: I/O Board Layout
