SC3228/BatteryProgrammer/Batt Programmer_V2/Batt Programmer/IO Board/PDFs/IO Board-F_Cu.pdf

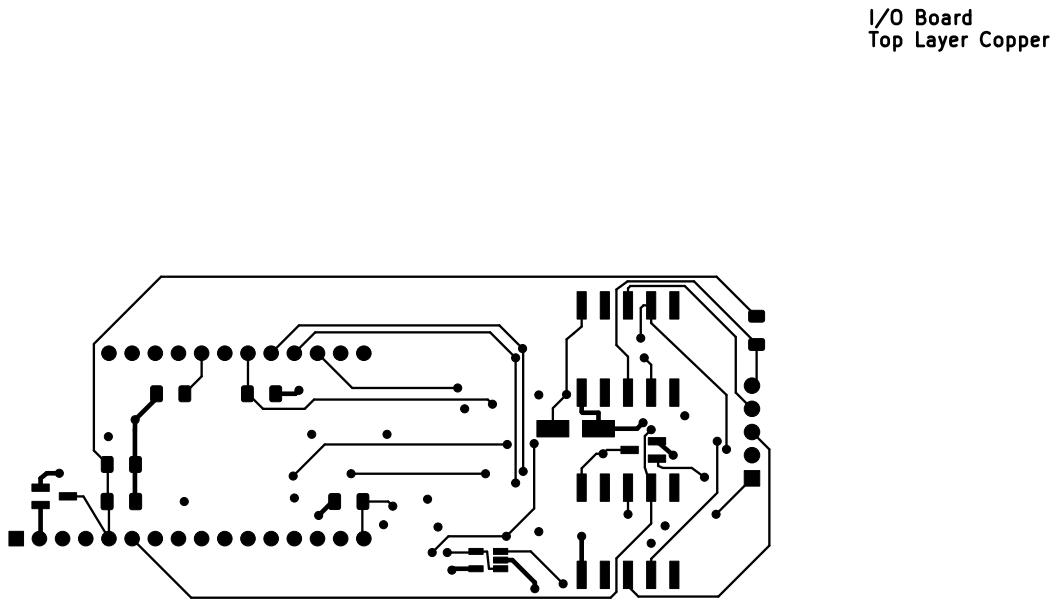
[picture p91: page 1]

File: IO Board.kicad_pcb Sheet:
Id: 1/1 Title: I/O Board Layout
