SC3228/BatteryProgrammer/Batt Programmer_V2/Batt Programmer/IO Board/PDFs/IO Board-F_Fab.pdf

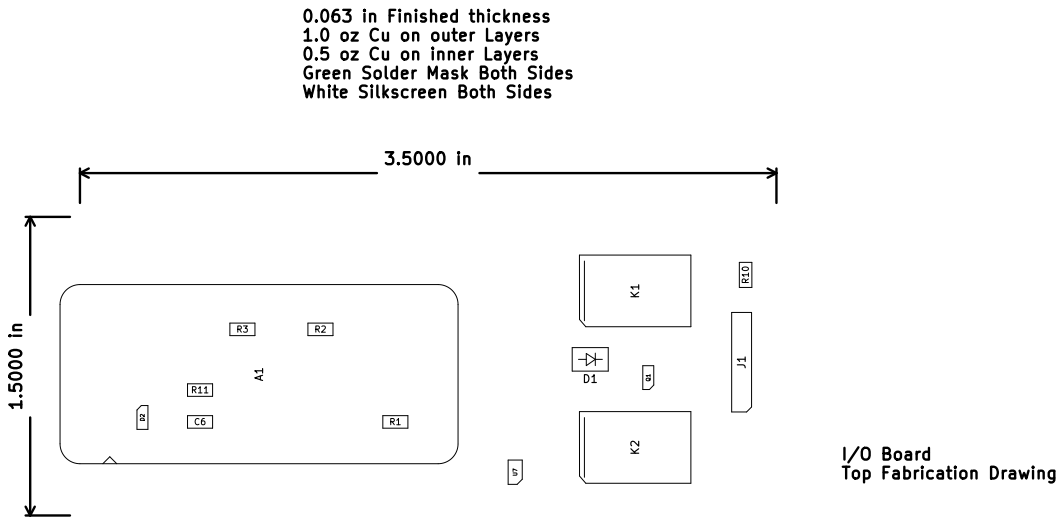
[picture p92: page 1]

0.063 in Finished thickness
1.0 oz Cu on outer Layers

File: IO Board.kicad_pcb Sheet:
Id: 1/1 Title: I/O Board Layout
