SC3228/BatteryProgrammer/Batt Programmer_V2/Batt Programmer/IO Board/PDFs/IO Board-F_Mask.pdf

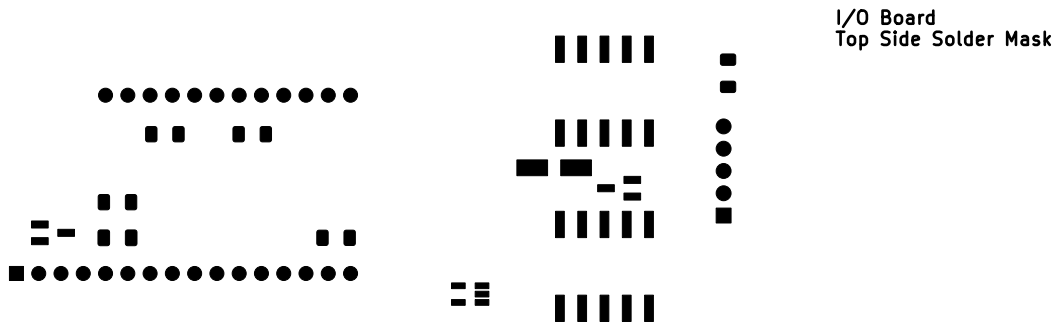
[picture p93: page 1]

I/O Board
Top Side Solder Mask

File: IO Board.kicad_pcb Sheet:
Id: 1/1 Title: I/O Board Layout
