SC3228/BatteryProgrammer/Batt Programmer_V2/Batt Programmer/IO Board/PDFs/IO Board.pdf

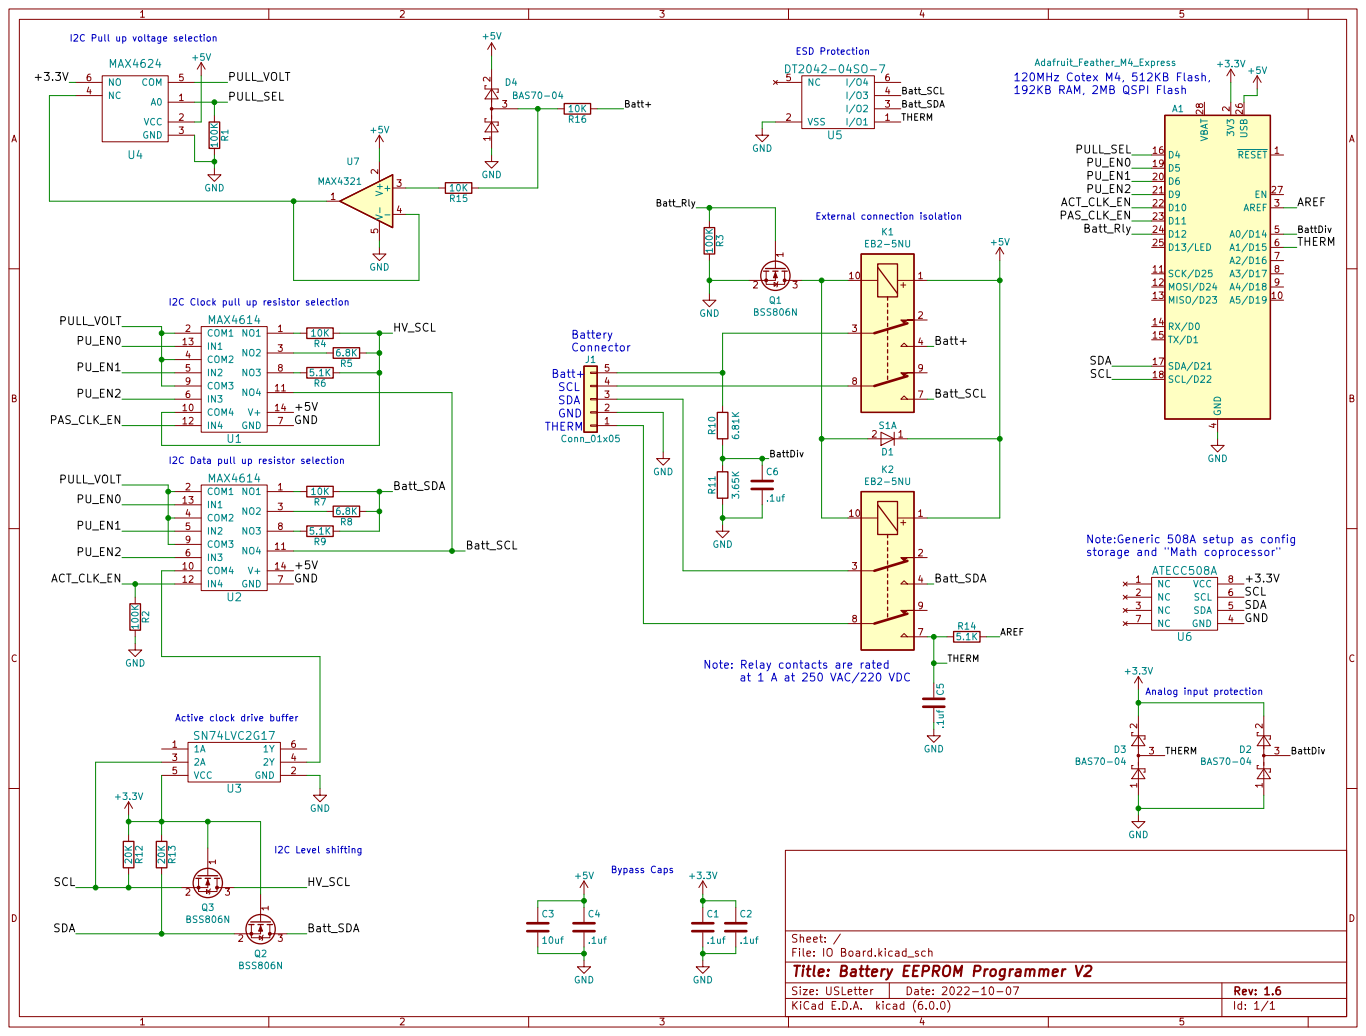
[picture p98: page 1]

I2C Pull up voltage selection

ESD Protection Batt+ SDA

2 D6 20 D9 21 D10 22 D11 23 D12 24 D13/LED 25 USB 26 EN 27 VBAT 28 AREF 3 GND

I2C Data pull up resistor selection

Note:Generic 508A setup as config
storage and "Math coprocessor"

at 1 A at 250 VAC/220 VDC

Id: 1/1 Title: Battery EEPROM Programmer V2
