SC3228/BatteryProgrammer/Batt Programmer_V2/Batt Programmer/Battery schematics/Frenzy_Battery_SCH_R00 20150506 (2).pdf

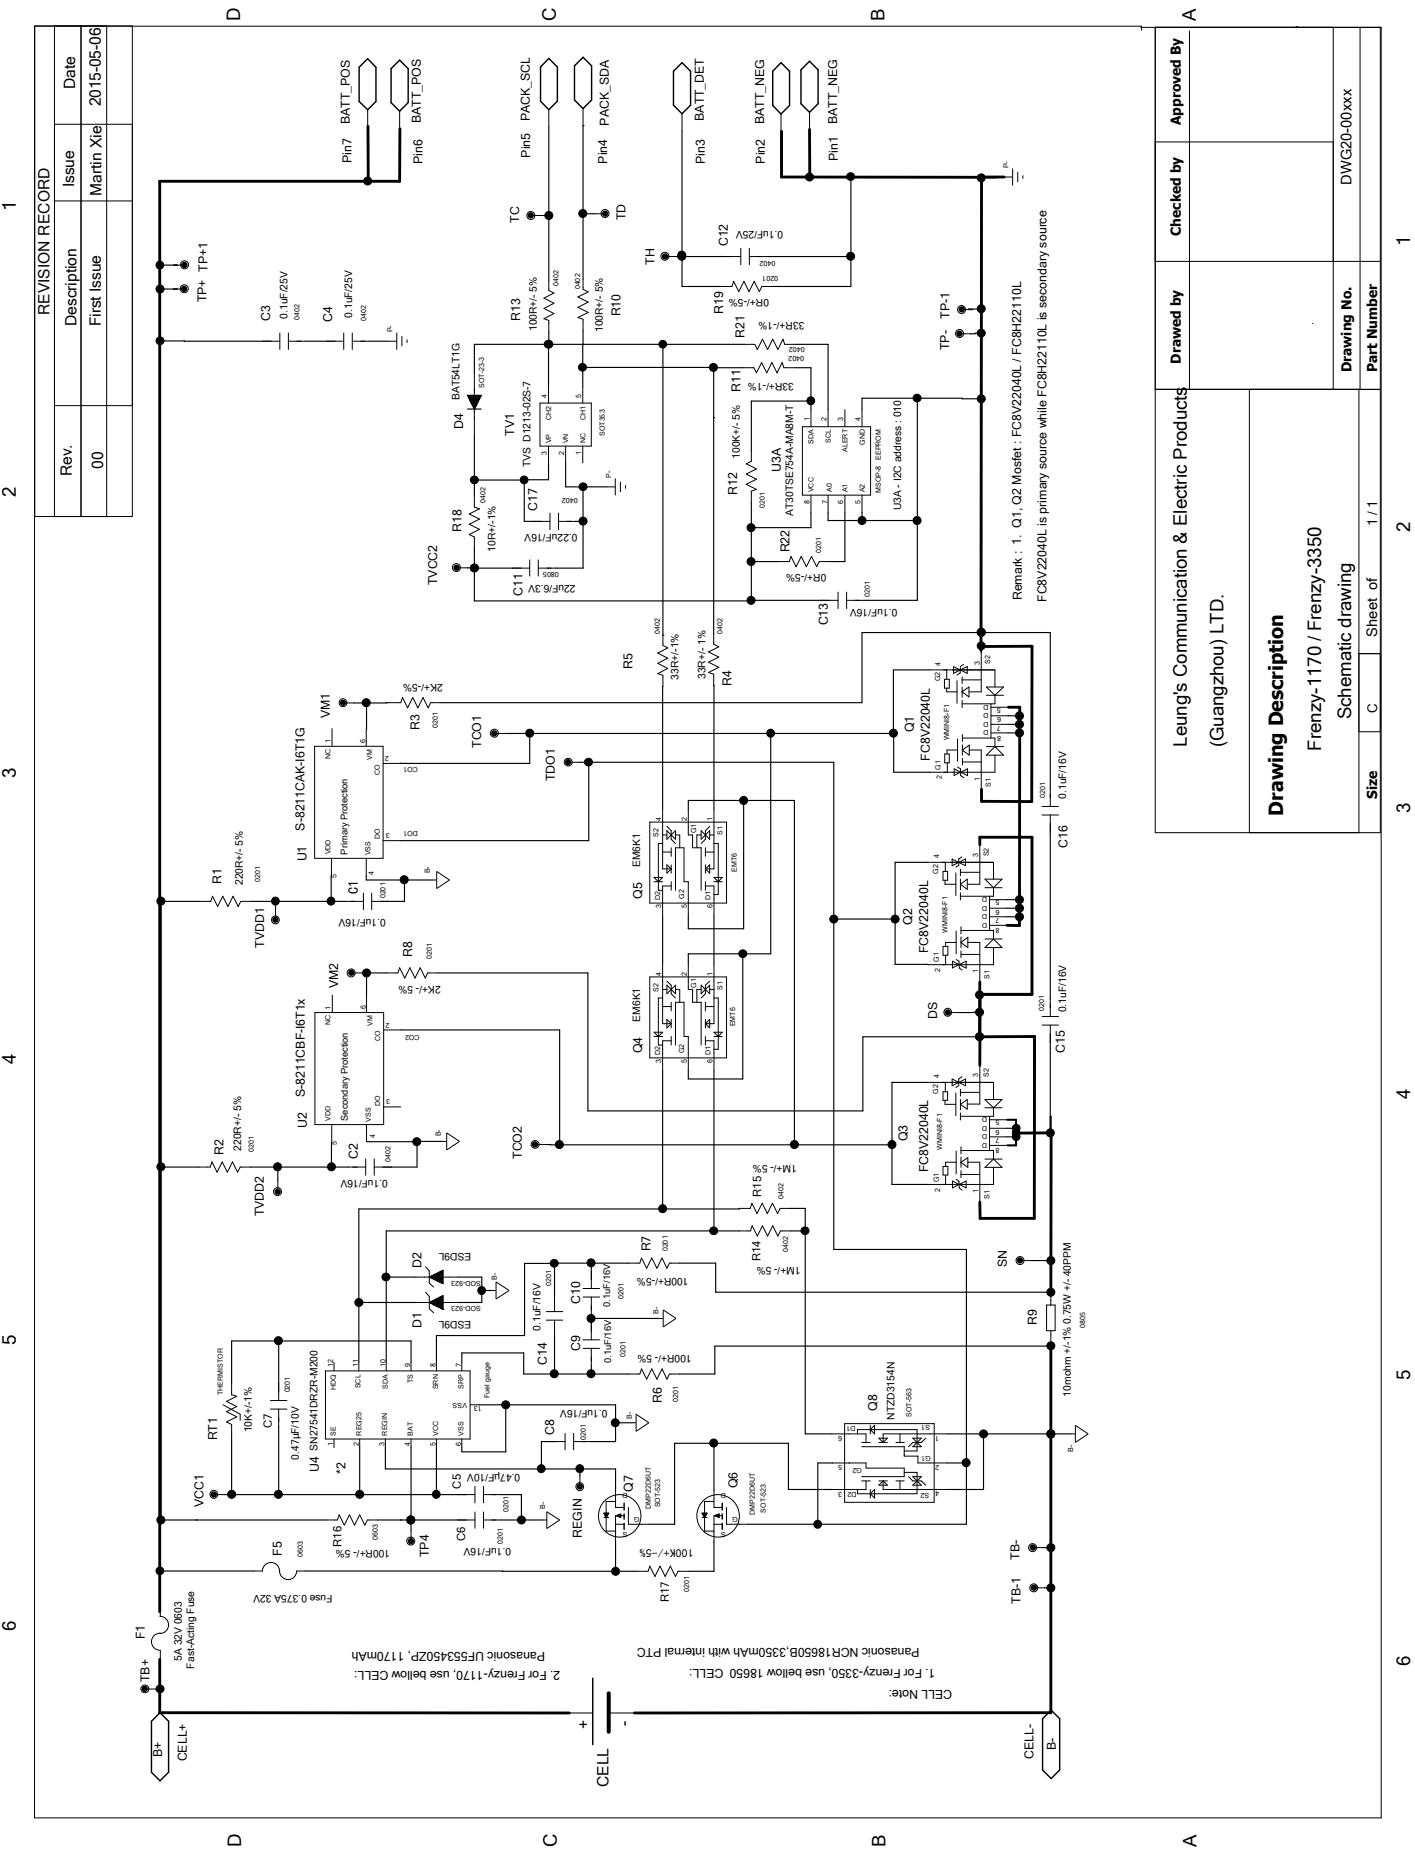
[picture p99: page 1]

Approved By Checked by Drawed by

00 First Issue Martin Xie

FC8V22040L is primary source while FC8H22110L is secondary source

C Sheet of Part Number 1 / 1

TB+ TVDD2 TVDD1 TVCC2 TDO1TCO1 TCO2 DS VCC1 TP4REGIN VM2 VM1 1 NC2 CO 3 DO 4 VSS 5 VDD 6 VM U1 S-8211CAK-I6T1G Primary Protection R11

Leung's Communication & Electric Products

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
