SC3228/BatteryProgrammer/Batt Programmer_V2/Batt Programmer/Battery schematics/Zebra_Falcon_SCH_R03_20160819.pdf

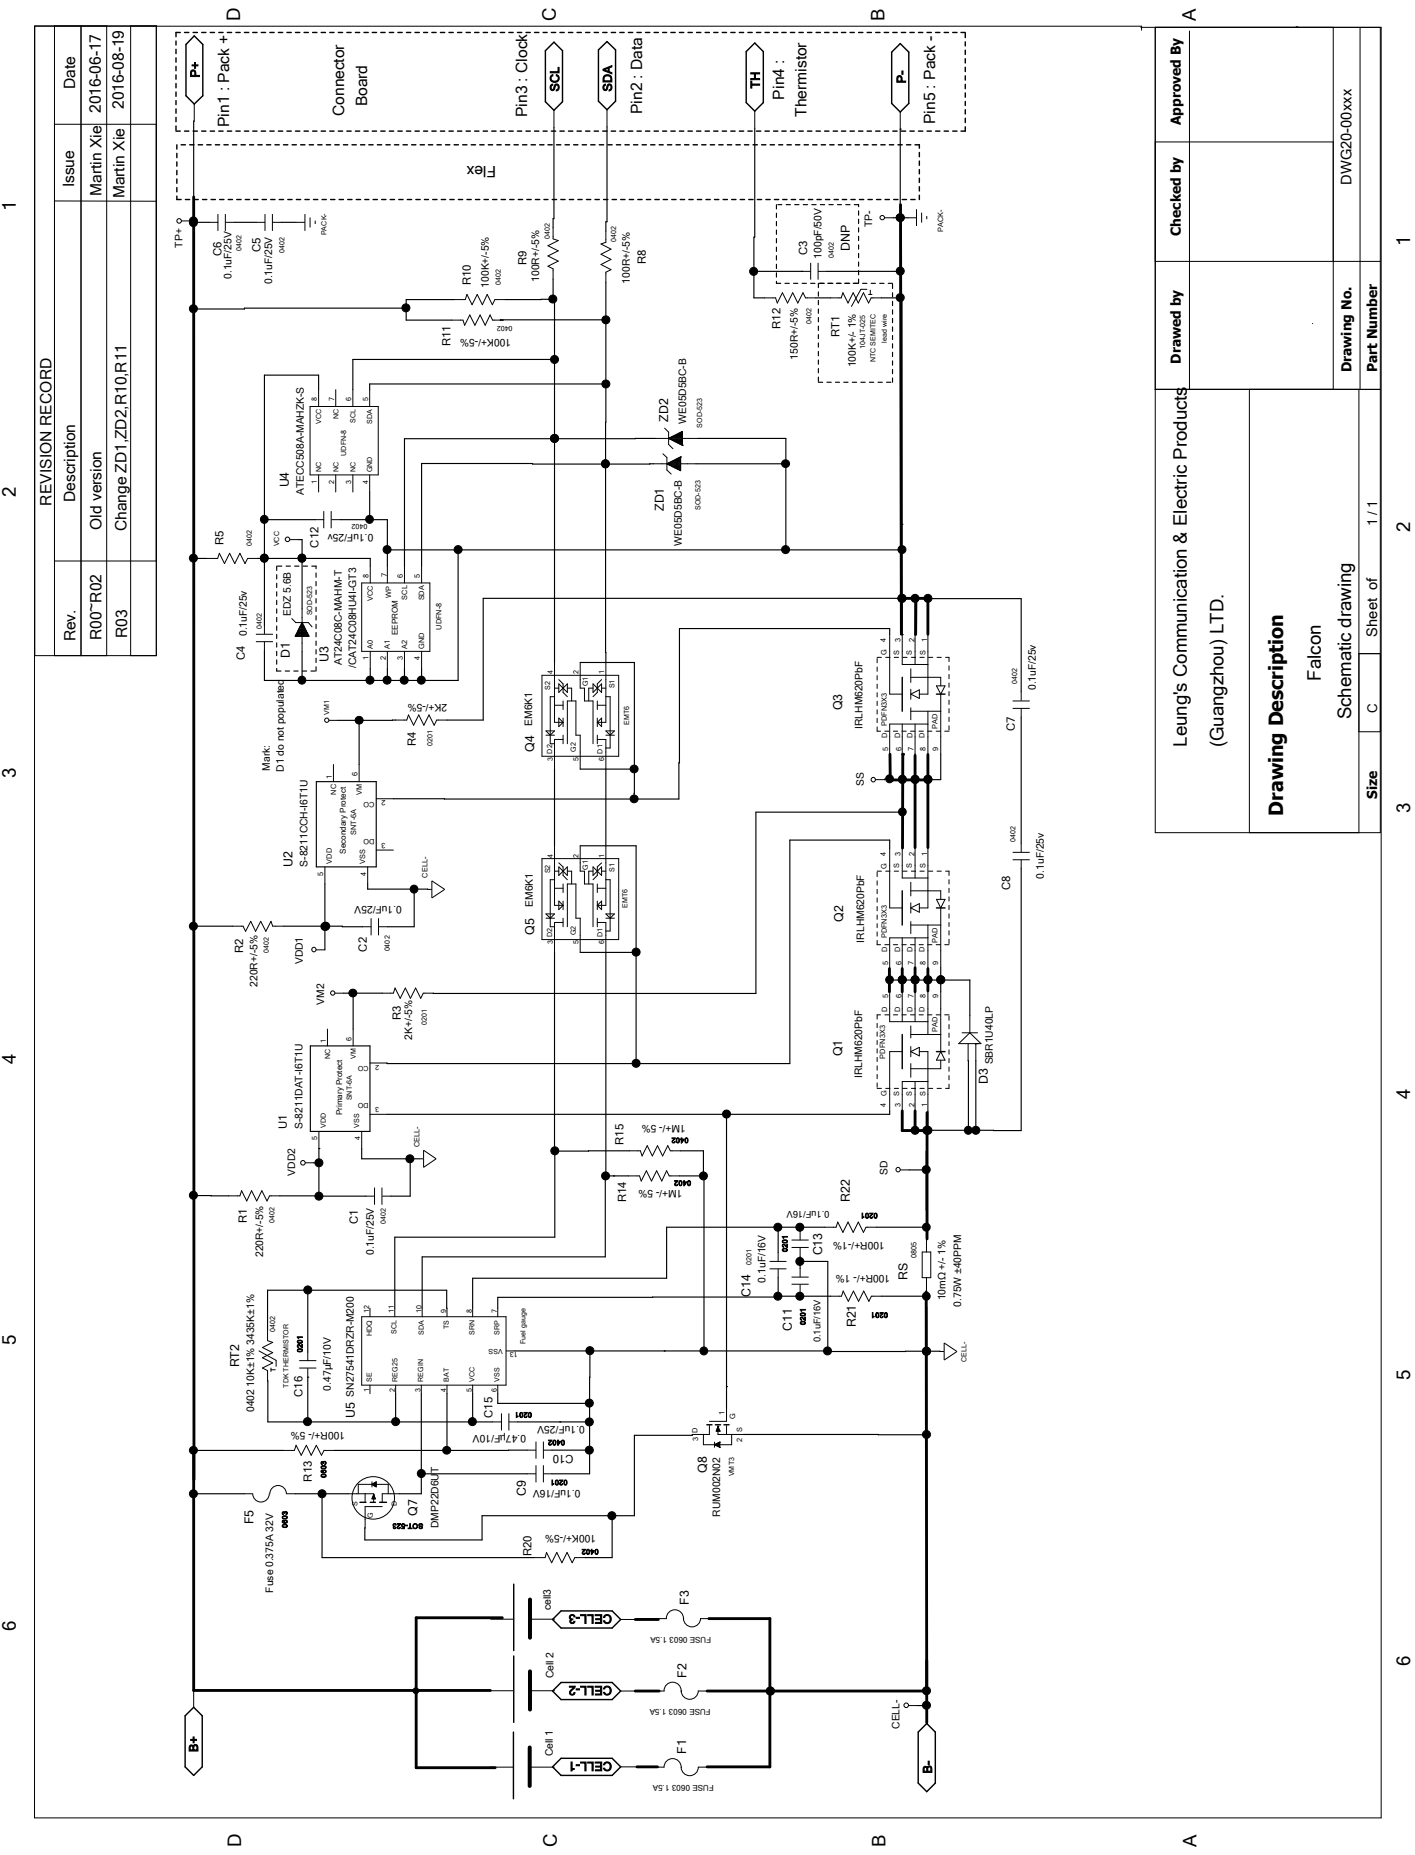
[picture p100: page 1]

Approved By Checked by Drawed by

Description Date Rev. Issue

R00~R02 Old version Martin Xie

C Sheet of Part Number 1 / 1

Leung's Communication & Electric Products

Primary Protect Secondary Protect
