SC3228/BatteryProgrammer/Batt Programmer_V2/Batt Programmer/Docs/Feather_M4_Pinout.pdf

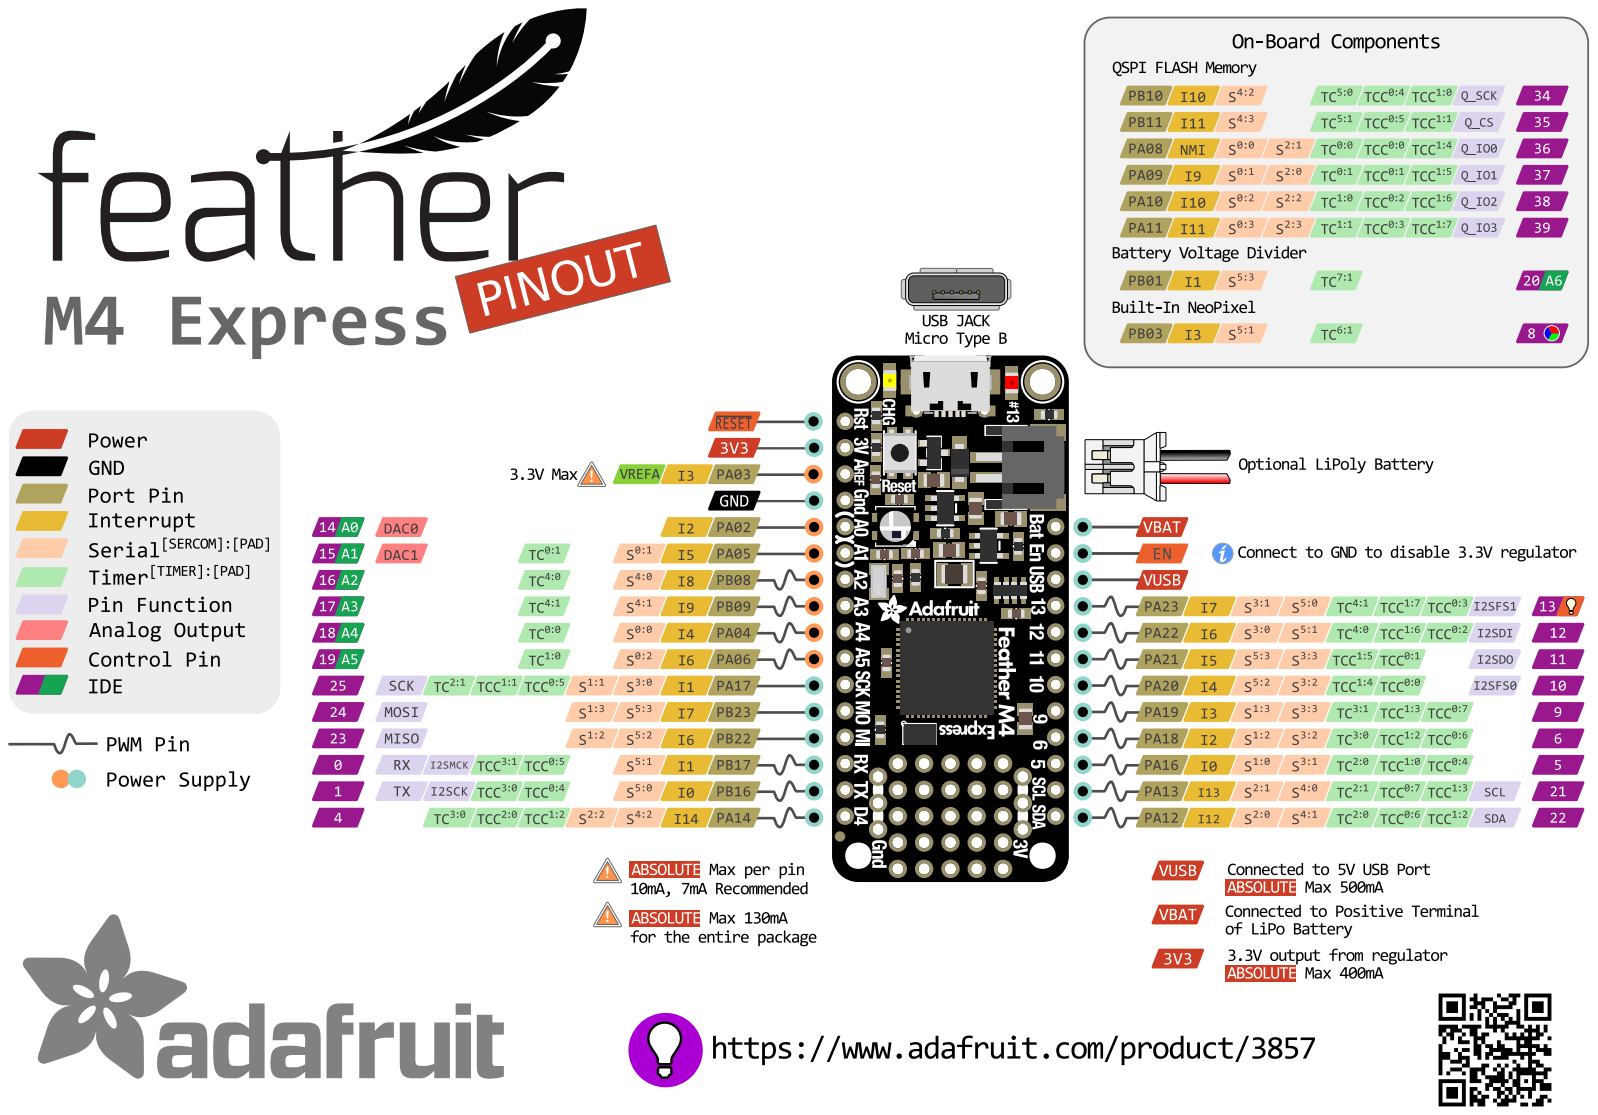
[picture p101: page 1]
