SC3228/BatteryProgrammer/Batt Programmer_V2/Batt Programmer/Docs/ES0800-xxDSFB.PDF

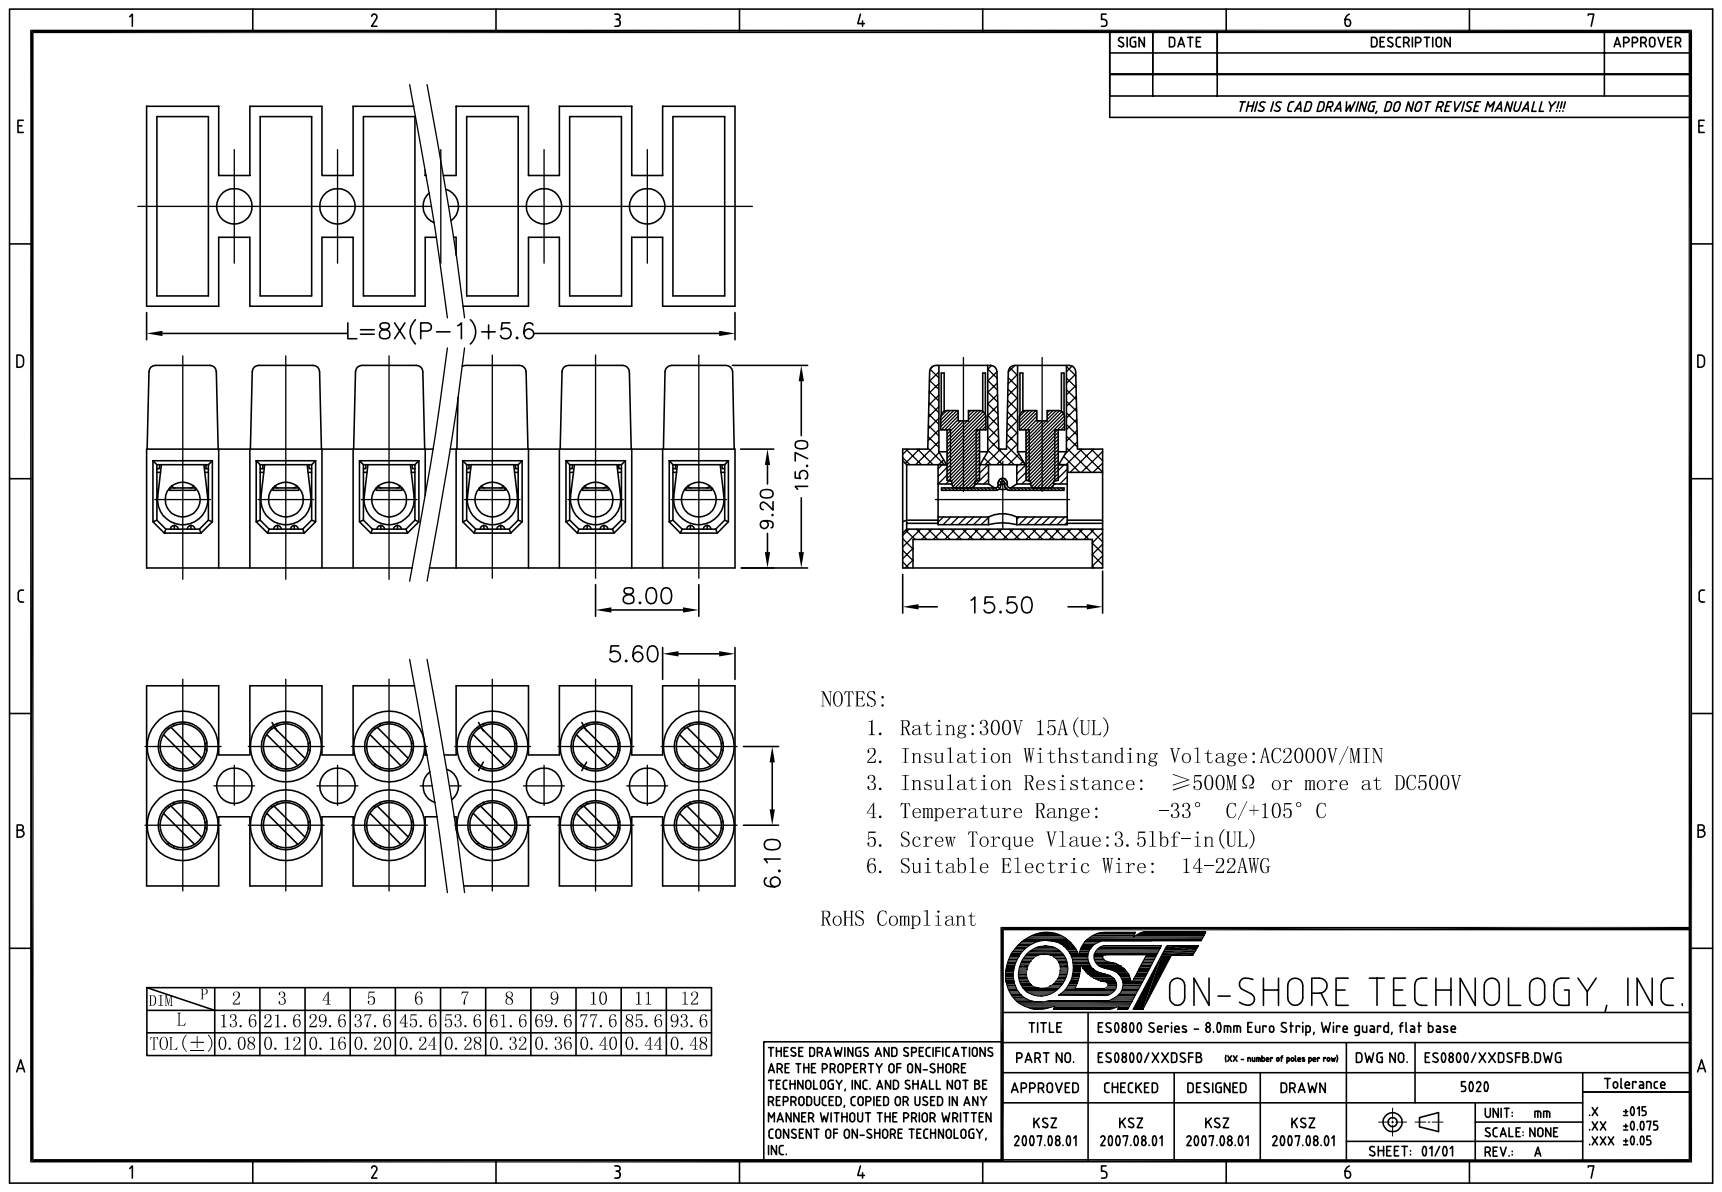
[picture p102: page 1]
