SC3228/BatteryProgrammer/Batt Programmer_V2/Batt Programmer/IO Board/IO Board.kicad_pcb

## KiCad design Batt Programmer_V2/Batt Programmer/IO Board/IO Board.kicad_pcb (2024-01-31)

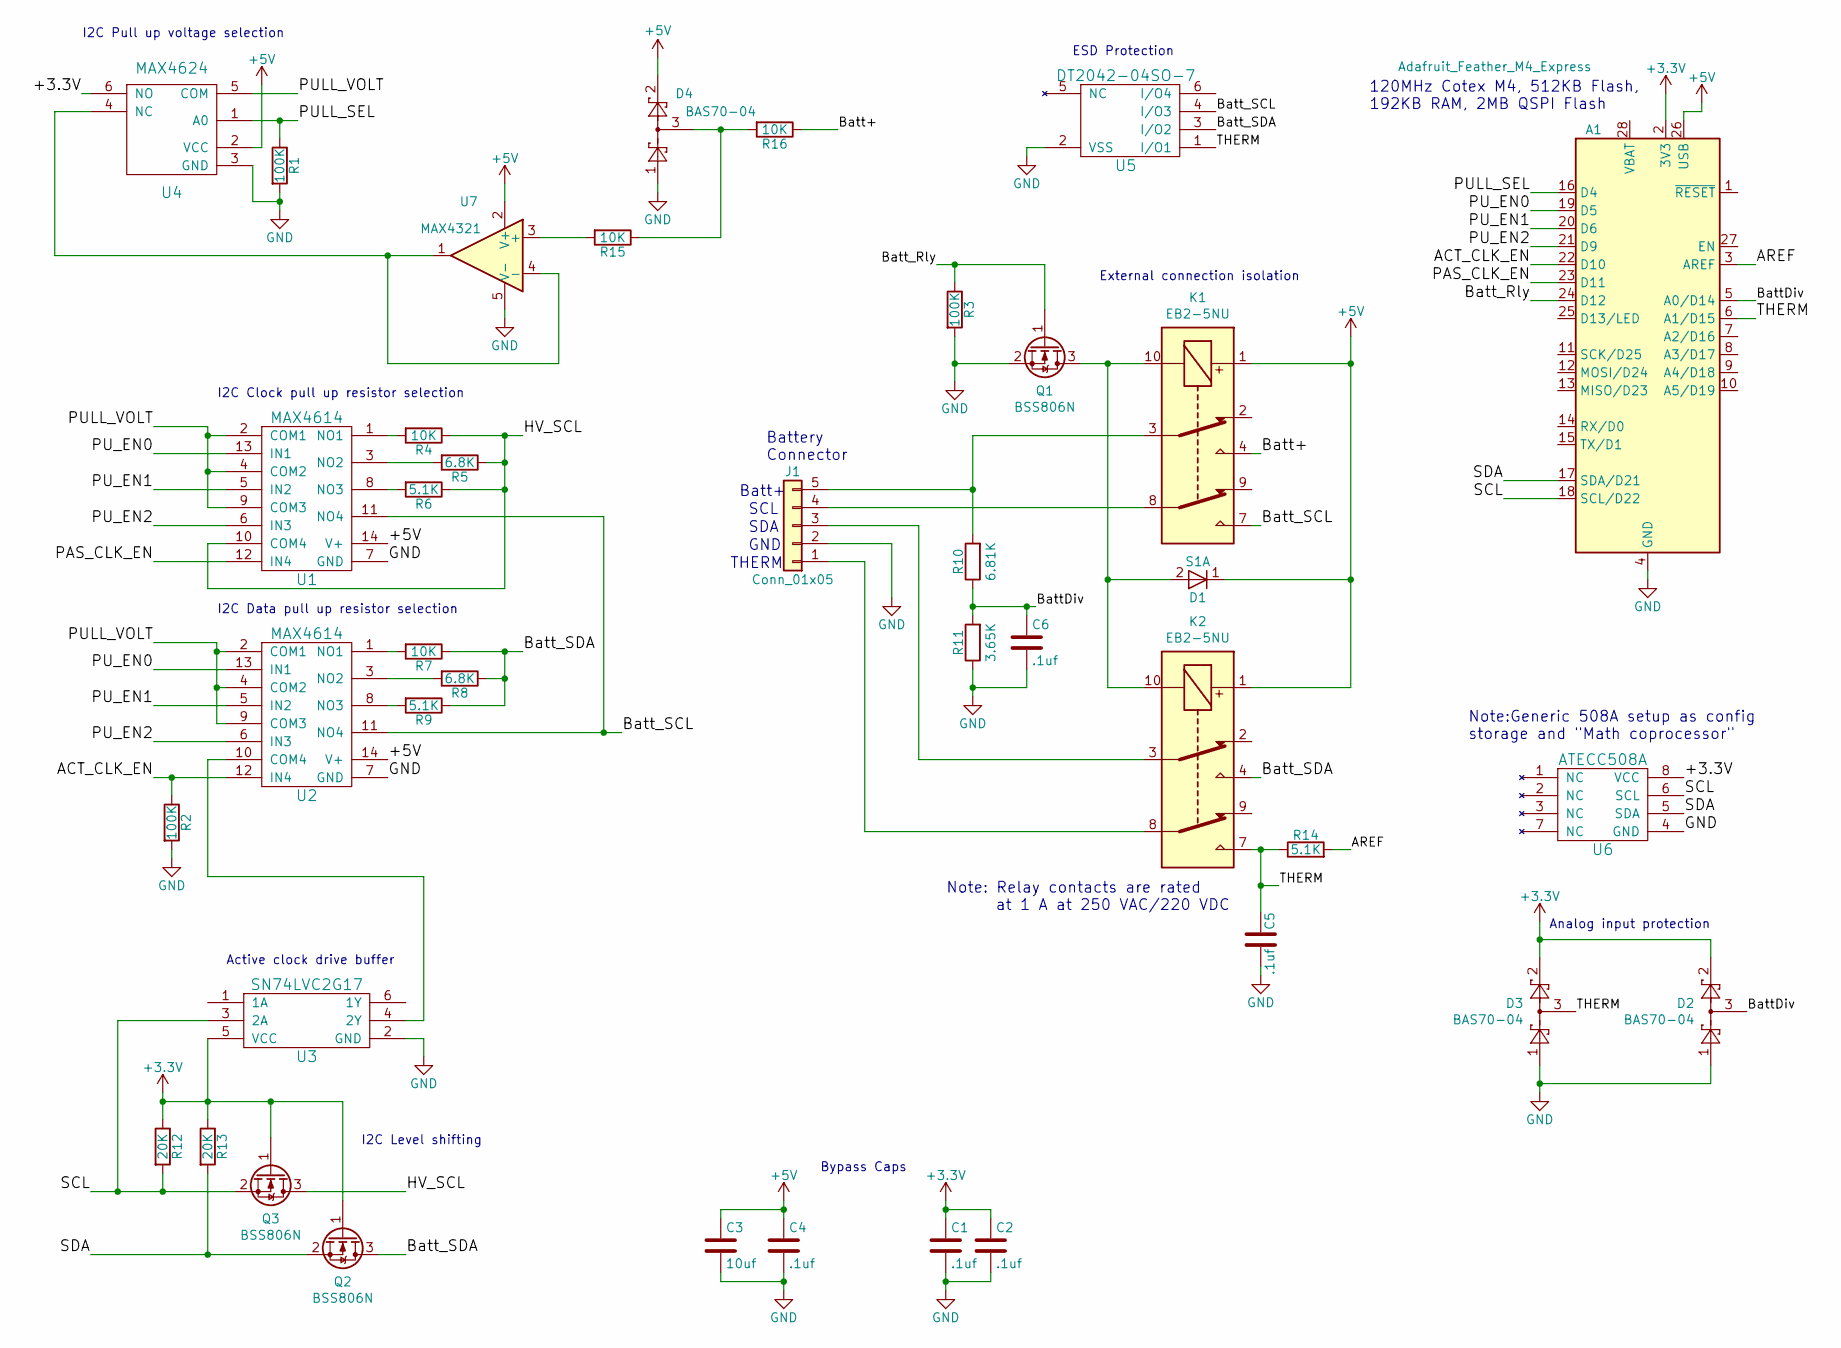
[picture p103: schematic IO Board.kicad_sch, Battery EEPROM Programmer V2]

Parts:
A1: Adafruit_Feather_M4_Express; Adafruit_Feather
C1, C2, C4, C5, C6: .1uf; C_1206_3216Metric_Pad1.33x1.80mm_HandSolder
C3: 10uf; C_1206_3216Metric_Pad1.33x1.80mm_HandSolder
D1: S1A; D_SMA_Handsoldering
D2, D3, D4: BAS70-04; SOT-23_Handsoldering
J1: Conn_01x05; PinHeader_1x05_P2.54mm_Vertical
K1, K2: EB2-5NU; Relay_DPDT_Omron_G6H-2F
Q1, Q2, Q3: BSS806N; SOT-23_Handsoldering
R1, R2, R3: 100K; R_1206_3216Metric_Pad1.30x1.75mm_HandSolder
R4, R7, R15, R16: 10K; R_1206_3216Metric_Pad1.30x1.75mm_HandSolder
R5, R8: 6.8K; R_1206_3216Metric_Pad1.30x1.75mm_HandSolder
R6, R9, R14: 5.1K; R_1206_3216Metric_Pad1.30x1.75mm_HandSolder
R10: 6.81K; R_1206_3216Metric_Pad1.30x1.75mm_HandSolder
R11: 3.65K; R_1206_3216Metric_Pad1.30x1.75mm_HandSolder
R12, R13: 20K; R_1206_3216Metric_Pad1.30x1.75mm_HandSolder
U1, U2: MAX4614; SOIC-14_3.9x8.7mm_P1.27mm
U3: SN74LVC2G17; SOT-23-6_Handsoldering
U4: MAX4624; SOT-23-6_Handsoldering
U5: DT2042-04SO-7; SOT-23-6_Handsoldering
U6: ATECC508A; SOIC-8_3.9x4.9mm_P1.27mm
U7: MAX4321; SOT-23-5_HandSoldering

Connections:
+3.3V: A1.2 (3V3), C1.1, C2.1, D2.2, D3.2, Q2.1 (G), Q3.1 (G), R12.1, R13.1, U3.5 (VCC), U4.6 (NO), U6.8 (VCC)
+5V: A1.26 (USB), C3.1, C4.1, D1.1 (C), D4.2, K1.1, K2.1, U1.14 (V+), U2.14 (V+), U4.2 (VCC), U7.2 (V+)
/ACT_CLK_EN: A1.22 (D10), R2.1, U2.12 (IN4)
/AREF: A1.3 (AREF), R14.2
/Batt+: K1.4, R16.1
/BattDiv: A1.5 (A0/D14), C6.1, D2.3, R10.1, R11.2
/Batt_Rly: A1.24 (D12), Q1.1 (G), R3.1
/Batt_SCL: K1.7, U1.11 (NO4), U2.11 (NO4), U5.4 (I/O3)
/Batt_SDA: K2.4, Q2.3 (D), R7.1, R8.1, R9.1, U5.3 (I/O2)
/HV_SCL: Q3.3 (D), R4.1, R5.1, R6.1, U1.10 (COM4)
/PAS_CLK_EN: A1.23 (D11), U1.12 (IN4)
/PULL_SEL: A1.16 (D4), R1.1, U4.1 (A0)
/PULL_VOLT: U1.2 (COM1), U1.4 (COM2), U1.9 (COM3), U2.2 (COM1), U2.4 (COM2), U2.9 (COM3), U4.5 (COM)
/PU_EN0: A1.19 (D5), U1.13 (IN1), U2.13 (IN1)
/PU_EN1: A1.20 (D6), U1.5 (IN2), U2.5 (IN2)
/PU_EN2: A1.21 (D9), U1.6 (IN3), U2.6 (IN3)
/SCL: A1.18 (SCL/D22), Q3.2 (S), R12.2, U3.3 (2A), U6.6 (SCL)
/SDA: A1.17 (SDA/D21), Q2.2 (S), R13.2, U6.5 (SDA)
/THERM: A1.6 (A1/D15), C5.1, D3.3, K2.7, R14.1, U5.1 (I/O1)
GND: A1.4 (GND), C1.2, C2.2, C3.2, C4.2, C5.2, C6.2, D2.1, D3.1, D4.1, J1.2, Q1.2 (S), R1.2, R2.2, R3.2, R11.1, U1.7 (GND), U2.7 (GND), U3.2 (GND), U4.3 (GND), U5.2 (VSS), U6.4 (GND), U7.5 (V-)
unnamed: D1.2 (A), K1.10, K2.10, Q1.3 (D)
unnamed: D4.3, R15.1, R16.2
unnamed: J1.1, K2.8
unnamed: J1.3, K2.3
unnamed: J1.4, K1.8
unnamed: J1.5, K1.3, R10.2
unnamed: R4.2, U1.1 (NO1)
unnamed: R5.2, U1.3 (NO2)
unnamed: R6.2, U1.8 (NO3)
unnamed: R7.2, U2.1 (NO1)
unnamed: R8.2, U2.3 (NO2)
unnamed: R9.2, U2.8 (NO3)
unnamed: R15.2, U7.3 (+)
unnamed: U2.10 (COM4), U3.4 (2Y)
unnamed: U4.4 (NC), U7.1, U7.4 (-)

Notes on the sheet:
External connection isolation
Batt+
SDA
Battery Connector
I2C Level shifting
I2C Clock pull up resistor selection
Note:Generic 508A setup as config storage and "Math coprocessor"
I2C Data pull up resistor selection
Note: Relay contacts are rated at 1 A at 250 VAC/220 VDC
Analog input protection
SCL
ESD Protection
Active clock drive buffer
120MHz Cotex M4, 512KB Flash, 192KB RAM, 2MB QSPI Flash
I2C Pull up voltage selection
Bypass Caps
GND
THERM

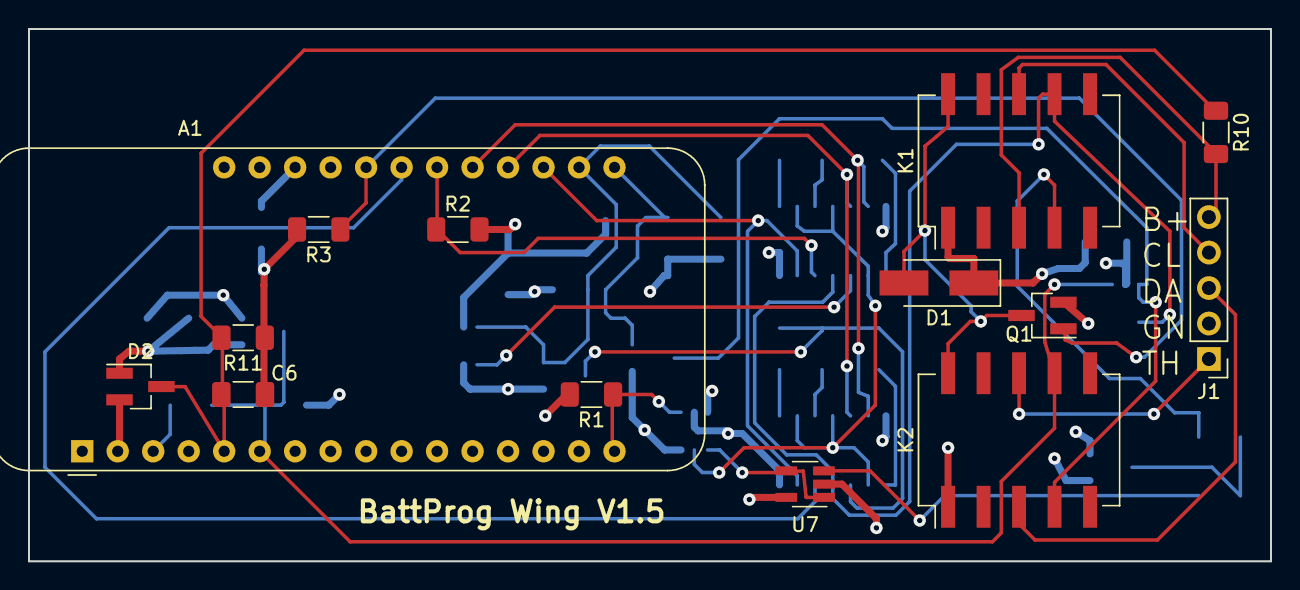
[picture p104: board IO Board.kicad_pcb from above]

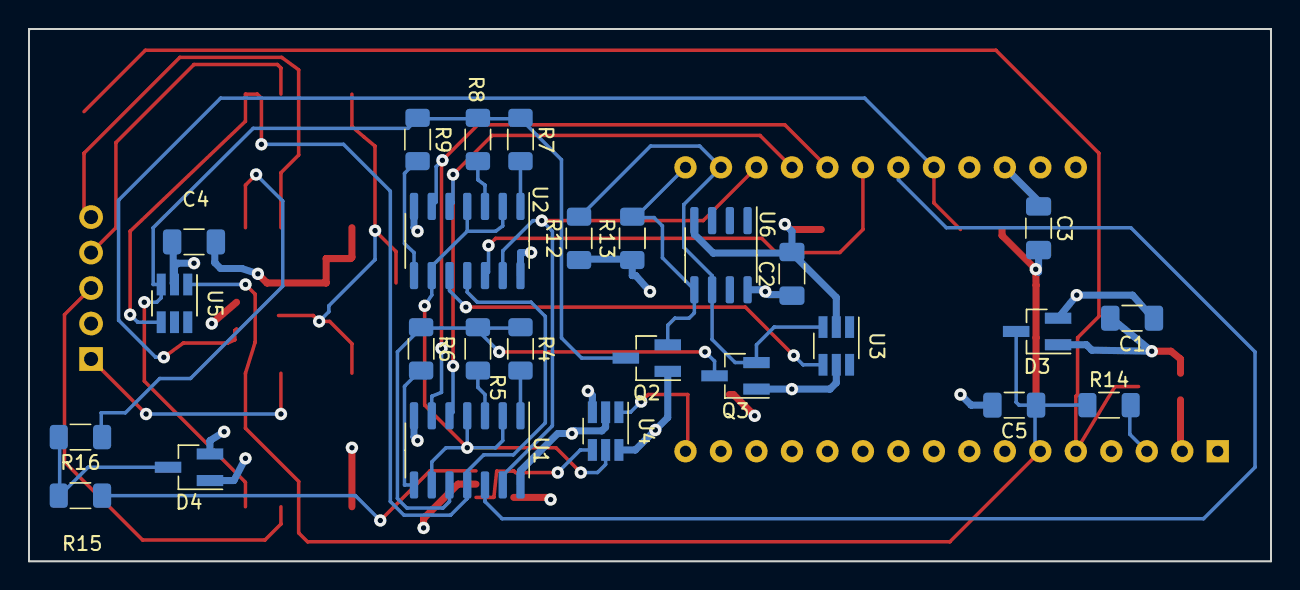
[picture p105: board IO Board.kicad_pcb from below]

Board: 4 copper layers, 88.9 x 38.1 mm, 40 parts (26 on the bottom side), 35 nets.
